sumkindafreak/new_showduino/firmware/s3-comms-controller/README.md

# Showduino ESP32-S3 Comms Controller

```text
Status: ACTIVE
Role: Showduino Communications Engine (dedicated ESP32-S3 Dev Module)
```

Dedicated USB-programmable ESP32-S3 communications processor.

This is **not** the 800×480 touchscreen Director (`firmware/director-esp32-8048s050/`).
It has no LVGL, no display, and no GT911. It is a separate ESP32-S3 Dev Module.

```text
Director ESP32-S3
        |
        | ESP-NOW
        v
ESP32-S3 Comms Controller   (this firmware)
        |
        | UART 115200 8N1
        v
ESP32-P4 Stage Engine
```

The P4 remains the authoritative Stage Engine. This board transports only. The P4 boots and runs locally if this S3 is missing.

## Constitution

> The Communications Engine transports.

It must **not**:

- Run the show timeline
- Own authoritative show state
- Make show-level decisions
- Invent show / production / emergency / node / output / E1.31 state
- Own SD, audio, pixels, or the Plug-in Bus
- Initialise Bluetooth

It **may** host the static browser WebUI from PROGMEM and proxy P4 API GETs.

## Sketch

```text
firmware/s3-comms-controller/ShowduinoS3CommsController/
```

Arduino board: **ESP32S3 Dev Module** (`esp32:esp32:esp32s3`).

USB CDC must remain enabled so this board stays directly programmable and debuggable over USB. The P4 UART uses UART1 on GPIO17/GPIO18, not UART0 and not native USB D+/D−.

### Compile (Arduino core 3.3.11)

```text
arduino-cli compile --fqbn "esp32:esp32:esp32s3:USBMode=hwcdc,CDCOnBoot=cdc,FlashSize=8M,PSRAM=opi,PartitionScheme=default_8MB" firmware/s3-comms-controller/ShowduinoS3CommsController
```

USB recovery uses this same FQBN. Hold BOOT, tap RESET, release BOOT, then `arduino-cli upload` to the CDC port. Always keep `PartitionScheme=default_8MB` so both OTA slots remain.

Do not reuse a firmware version string after that build has been physically installed or accepted. Uninstalled 0.5.1 prerelease assets may be replaced; installed SoftAP/browser-control hardening is **0.5.3**. See `docs/comms-ota.md` and `docs/browser-control.md`.

Arduino IDE: **PSRAM = OPI PSRAM** (DevKitC-1 N8R8 / 8 MB). Use **QSPI PSRAM** only on an N8R2 2 MB module. Disabled is wrong for this board.

## UART pins

Defined only in `BoardConfig.h`:

| S3 GPIO | Function |
|---|---|
| **18** | UART RX (from P4 TX) |
| **17** | UART TX (to P4 RX) |

Wiring:

```text
S3 GPIO17 TX  ->  P4 GPIO4 RX
S3 GPIO18 RX  <-  P4 GPIO5 TX
S3 GND        --  P4 GND
115200 8N1, newline-framed ASCII
```

## Phase 1 behaviour

- Receive Director ESP-NOW desk packets (magic `0x5348444F`, version 1, 96-byte command)
- Receive Audio Node ESP-NOW packets (116-byte node packet, type `AUDIO`) and forward `NODE:AUDIO:` to the P4
- Receive Lamp Node ESP-NOW packets (type `LAMP`) and forward `NODE:LAMP:` to the P4
- Forward `ROUTE:AUDIO:<seq>:<cmd>` from the P4 to the Audio Node (transport only)
- Forward `ROUTE:LAMP:<seq>:<cmd>` from the P4 to the Lamp Node (transport only)
- Validate and reject malformed packets
- Remember Director MAC and Audio Node MAC
- Newline-frame commands to the P4 UART
- Forward P4 UART lines back to the Director as desk packets
- Reply `DIAG:PONG` to P4 `DIAG:PING` (local; not forwarded to Director)
- USB maintenance: `HELP`, `STATUS`, `MAC`, `PING:P4`, `RGB:STATUS`, `RGB:TEST`
- Onboard WS2812 status RGB on **GPIO48** (DevKitC-1 v1.0). v1.1 boards use GPIO38 — change only `SHOWDUINO_COMMS_RGB_PIN`.
- `PING:P4` sends `DIAG:PING` and waits for `DIAG:PONG`
- SoftAP `Showduino` on channel 1 (AP+STA, WPA2) serving PROGMEM system console / commissioning WebUI
- Local `GET /api/comms` plus UART proxy of P4 `/api/*`
- `GET/POST /api/studio-timeline` envelope check, then UART proxy to the P4 (PIXEL / AUDIO:NODE RAM cues only)

USB does **not** inject arbitrary Stage Engine commands.

Copy the boot Wi-Fi MAC into Director `SHOWDUINO_COMMS_MAC_*` in `firmware/director-esp32-8048s050/ShowduinoDirector8048S050/BoardConfig.h`.

## USB power / brownout

Cheap ESP32-S3 Dev Modules often brownout on USB when UART or the Wi-Fi radio starts (`E BOD: Brownout detector was triggered`).

Firmware mitigations (USB sag, not a substitute for 5 V):

- Brownout *reset* is disabled so a short dip does not reboot-loop
- ESP-NOW TX power is reduced (`WIFI_POWER_8_5dBm`)
- `esp_wifi_start()` is not called twice after `WiFi.mode(WIFI_STA)`

First boot: **unplug the P4 UART wires**. If GPIO17 TX is clamped by an unpowered P4, USB current spikes and the chip resets. Power the P4, then connect:

```text
S3 GPIO17 TX  ->  P4 GPIO4 RX
S3 GPIO18 RX  <-  P4 GPIO5 TX
GND
```

Prefer a powered USB hub or the board 5 V pin, not a weak laptop port.

## WebUI (PROGMEM)

Canonical frontend source: `web/showduino-studio/`.

Regenerate flash-resident assets (do not hand-edit `WebAssets.generated.h`):

```text
python tools/embed-webui/embed_webui.py
```

or:

```text
powershell -File tools/embed-webui/embed-webui.ps1
```

Join Wi-Fi `Showduino` / `showduino` (documented bench WPA2 secret — change before a public venue). Open `http://192.168.4.1/`. SoftAP stays on ESP-NOW channel 1.

If the P4 UART is down the UI still loads and shows **P4 OFFLINE**. S3 does not invent show state.

Navigation: Home, Productions, Live, Outputs, Devices, Network, System, Settings. Page map: `web/showduino-studio/README.md`.

## Comms self-OTA (Phase 2A)

Comms 0.5.1 can install **its own** image into the inactive `default_8MB` OTA slot from a GitHub Release. See `docs/comms-ota.md`.

- Operator action is **Update Comms**, never Update System
- P4 must authorise maintenance; a running show or emergency blocks apply
- SHA-256 is required; HTTPS is required; signed manifests are not implemented
- During the Comms reboot, Director and ESP-NOW nodes briefly disconnect. P4 and GPIO25 stay up
- Other components still require USB

## FUTURE / RESERVED / NOT IMPLEMENTED

- Bluetooth LE
- OTA for P4, Director, or specialist nodes
- Ethernet / E1.31 (next P4 work; not this firmware)

Intended later topology:

```text
Browser
  ├─ Wi-Fi → Comms S3 WebUI (this board)
  └─ future Ethernet path as appropriate
Comms S3 --UART--> P4 Show Engine --Ethernet--> E1.31 / show network
```

## Related

| Path | Status |
|---|---|
| `firmware/p4-c6-espnow-bridge/` | UNUSED BY SHOWDUINO / RESERVED HARDWARE (onboard C6) |
| `firmware/c3-supermini-espnow-bridge/` | LEGACY / SUPERSEDED |
| `firmware/stage-engine-p4/` | ACTIVE Stage Engine |
| `firmware/director-esp32-8048s050/` | ACTIVE Director |
