sumkindafreak/new_showduino/firmware/director-s3/README.md

# Showduino Director S3 (UART scaffold)

```text
Status: LEGACY
Not part of the canonical runtime.
```

Earlier ESP32-S3 Director using UART toward the engine. Superseded by `firmware/director-esp32-8048s050/` (ESP‑NOW → Communications Engine).

See [`docs/repository-status.md`](../../docs/repository-status.md).
