sumkindafreak/new_showduino/firmware/touch-probe-8048/README.md

# Touch Probe 8048

```text
Status: DIAGNOSTIC
Hardware bring-up utility; not production firmware.
```

GT911 / XPT2046 touch diagnostics for ESP32-8048S043 / S050 panels.

See [`docs/repository-status.md`](../../docs/repository-status.md).
