sumkindafreak/new_showduino/docs/repository-status.md

# Showduino Repository Status

> **2 November 2026:** The active-stack inventory below describes the historical main-source classification, not all features on the owner-reported working local firmware. The local baseline is represented in unmerged [PR #51](https://github.com/sumkindafreak/new_showduino/pull/51); optional FastLED and other staged work are in draft PRs #52–#57, and a reported MOSFET reconnect output-drop has a paired P4/node candidate in draft #58. Do not treat those drafts as installed or physically accepted. [Current status](manual/SHOWDUINO_FINISH_LINE_STATUS_2026-10-30.md#2-november-2026--working-local-baseline-and-staged-github-integration).

Classification of firmware projects. Status labels guide development priority; legacy source is retained where useful.

Related:

- [Constitution](constitution.md)
- [Architecture](architecture.md)
- [Command protocol](command-protocol.md)
- [Final hardware architecture](final-hardware-architecture.md)
- [Audio and Pixel Engine](audio-pixel-engine.md)
- [Specialist Node Roadmap](node-roadmap.md)
- [Wireless Emergency + Pixel Node](emergency-node.md)
- [System updates](system-updates.md)

**Roadmap note:** the active P4 now owns authoritative runtime/safety, bounded persistent PIXEL/AUDIO/LAMP/MOSFET/TEST/LOG production loading, onboard system audio, and the local GPIO23 segmented Show Pixel Engine. Those cue types are implemented in the persistent parser; broader cue coverage and physical acceptance remain open. See [production storage](production-storage.md).

---

## 1. Canonical active stack

```text
Director ESP32-S3
    → ESP-NOW
Communications Engine ESP32-S3 (dedicated Dev Module)
    → UART
Show Engine ESP32-P4
```

The supported current stack also includes the first specialist **Audio Node**.

Current specialist-node rollout order:

```text
Audio Node → S3 Lamp Node → C3 Pixel Node → C3 Emergency Node → MOSFET Node
```

The Relay Node product role is **retired**. The S3 Lamp Node occupies that Director fabric slot. MOSFET remains a later digital/PWM specialist. DMX remains parked until explicitly reopened.

The S3 Communications Engine now hosts the bench/browser SoftAP WebUI and proxies API requests to the P4. It remains transport/UI hosting only; it does not own show decisions.

### Active firmware

| Folder | Role |
|---|---|
| `firmware/director-esp32-8048s050/` | Director — operator UI, requests, display |
| `firmware/s3-comms-controller/` | Communications Engine — dedicated ESP32-S3 ESP-NOW + UART + SoftAP/WebUI proxy |
| `firmware/stage-engine-p4/` | Show Engine on Stage Controller |
| `firmware/audio-node-esp32-a1s/` | First specialist Audio Node — implemented, hardware test required |
| `firmware/s3-lamp-node/` | S3 Lamp Node — ACTIVE carbide simulator (physical GPIOs confirmed) |
| `firmware/c3-pixel-node/` | C3 Pixel Node — remote pixel specialist |
| `firmware/c3-emergency-node/` | C3 Emergency + Pixel Node — wireless assert-only Emergency Button + full Pixel engine on GPIO2 (GPIO unconfirmed) |
| `firmware/c3-lamp-node/` | Historical C3 lamp — SUPERSEDED / reference |

---

## 2. Complete firmware classification table

| Folder | Status | Target hardware | Current purpose | Relationship / next action |
|---|---|---|---|---|
| `firmware/director-esp32-8048s050/` | **ACTIVE** | ESP32-S3 800×480 | Canonical Director LVGL + ESP-NOW client | Keep; Director requests/displays only |
| `firmware/s3-comms-controller/` | **ACTIVE** | ESP32-S3 Dev Module | Communications Engine, Audio Node routing, SoftAP/WebUI/API proxy | Keep transport-only; no show decisions |
| `firmware/stage-engine-p4/` | **ACTIVE** | ESP32-P4 Stage Controller | Authoritative Show Engine | Current platform focus includes P4 pixel bench commissioning |
| `firmware/audio-node-esp32-a1s/` | **ACTIVE / HARDWARE TEST REQUIRED** | Ai-Thinker ESP32-A1S / ES8388 | Attraction/programme audio node | Bench commission before claiming hardware-complete |
| `firmware/s3-lamp-node/` | **ACTIVE / PHYSICAL PINS CONFIRMED** | ESP32-S3 Dev Module family | Interactive carbide-lamp practical | Production Lamp Node firmware 0.4.0 |
| `firmware/c3-pixel-node/` | **ACTIVE / HARDWARE TEST REQUIRED** | ESP32-C3 | Remote pixel specialist | Same FX/emergency-white model as P4 GPIO23 |
| `firmware/c3-emergency-node/` | **ACTIVE / GPIO UNCONFIRMED** | ESP32-C3 Super Mini class | Wireless emergency station (ASSERT ONLY) + Pixel capability on GPIO2 | Do not mark GPIO verified until pushbutton commissioned. Sequential ESTOP-01 → reboot → healthy+linked → ESTOP-02 |
| `firmware/c3-lamp-node/` | **SUPERSEDED** | ESP32-C3 Super Mini OLED | Historical lamp FX firmware | Retained as reference; not the physical lamp |
| `firmware/mosfet-node-esp32/` | **SOFTWARE IMPLEMENTED** | ESP32_MOS_X4 / 303E32NMOS4 | Digital/PWM powered outputs OUT1–4 | Pin map defined; physical validation required |
| `firmware/relay-node-esp32/` | **LEGACY / RETIRED** | ESP32 + relay module | Historical relay-node prototype | Retain as reference only; not a production Node |
| `firmware/p4-c6-espnow-bridge/` | **UNUSED / RESERVED** | Onboard ESP32-C6 | Historical C6 bridge qualification | C6 hardware remains unused/reserved |
| `firmware/c3-supermini-espnow-bridge/` | **LEGACY / SUPERSEDED** | ESP32-C3 SuperMini | Previous SUE Communications Engine | Retain as reference; not current path |
| `firmware/director-s3/` | **LEGACY** | ESP32-S3 + TFT_eSPI | Earlier UART Director scaffold | Do not extend |
| `firmware/espnow-bridge/` | **LEGACY** | ESP32 family | Early ESP-NOW bridge scaffold | Retain packet ideas only |
| `firmware/touch-probe-8048/` | **DIAGNOSTIC** | 8048 touchscreen | Touch hardware bring-up | Keep as lab tool |
| `firmware/sue-esp32s3-node/` | **INCOMPLETE** | ESP32-S3 | Old multi-function node placeholder | Do not confuse with current specialist-node roadmap |
| `firmware/controller-cyd/` | **ARCHIVE CANDIDATE** | CYD | Legacy UI generation | Archive later |
| `firmware/executor-mega/` | **ARCHIVE CANDIDATE** | Arduino Mega | Legacy executor | Archive later |

---

## 3. Active project boundaries

### Director

**Owns:** operator UI, input handling, display state, ESP-NOW client transport, Director-local diagnostics.

**Must not own:** authoritative show state, production execution, node routing policy, physical completion assumptions.

### Communications Engine

**Owns:** ESP-NOW fabric, UART transport to P4, transport-address discovery, Audio Node packet forwarding, link health, static browser WebUI hosting and P4 API proxying.

**Must not own:** show decisions, timelines, cue state, physical FX execution, or false completion acknowledgements.

### Show Engine — ESP32-P4

**Owns:**

- authoritative show/emergency state;
- production loading and timeline execution;
- safety policy;
- node coordination;
- P4 system/safety audio;
- GPIO24 emergency/signage pixels;
- GPIO23 local segmented Show Pixel Engine;
- storage and local services as implemented.

The GPIO23 engine currently supports direct/bench `PIXEL:` commands and the shared 25-effect vocabulary. Persistent production format v1 accepts bounded PIXEL, AUDIO, LAMP, MOSFET, TEST and LOG cues. ESTOP-prefixed pixel persistence remains unsupported. See [production storage](production-storage.md).

### Emergency/signage pixels — GPIO24

Safety-owned, not a production lane.

```text
Each sign = 10 pixels
NORMAL: first pixel GREEN, remaining 9 OFF
EMERGENCY: every pixel WHITE
```

Up to 100 configured pixels gives up to ten sign bundles. All groups are prepared in one frame and transmitted together.

### Show pixels — GPIO23

One local theatrical line with independent segments and non-blocking effects. Emergency overrides every segment and forces the full line bright white. Clearing emergency leaves the show line blacked out; old effects do not auto-resume.

Shared FX vocabulary: `protocol/showduino_pixel_fx.h`.

### Audio Node

**Classification:** implemented / hardware test required.

Owns local ES8388 + microSD programme audio, playback lifecycle, fades/duck/inventory, P4 GRANT ownership, and a channel-1 SoftAP WebUI when standalone. It does not own P4 system/emergency audio or show decisions.

### S3 Lamp Node

**Classification:** ACTIVE firmware / physical GPIOs confirmed. Replaces the retired Relay Node product role on the Director fabric. Interactive carbide-lamp practical via `firmware/s3-lamp-node/` firmware **0.4.0**; same image is a standalone SoftAP prop (`Showduino-Lamp-<id>`) and a GRANT-managed Showduino node. P4 `LampNodeLink` / Comms `ROUTE:LAMP:`. Historical C3 firmware remains in `firmware/c3-lamp-node/`. See [`s3-lamp-node.md`](s3-lamp-node.md).

### C3 Pixel Node

**Classification:** implemented / hardware test required.

Remote equivalent of P4 GPIO23. Same firmware binary on every C3; commission `LED-01` / friendly name / line length after flash. P4 `PixelNodeLink` / Comms `ROUTE:PIXEL:<id>:`. Max 512 pixels on C3 (P4 local line remains 1–1024). See [`c3-pixel-node.md`](c3-pixel-node.md).

### MOSFET Node

**Classification:** SOFTWARE IMPLEMENTED / HARDWARE PIN MAP DEFINED / PHYSICAL OUTPUT VALIDATION REQUIRED.

ESP32_MOS_X4 four powered outputs with LEVEL / PULSE / FADE, Comms multi-peer `ROUTE:MOSFET:`, P4 `MosfetNodeLink`, Director Page 04 live tile, Studio Powered Output deploy. GPIO unverified until physical bench. Not a Relay revival.

---

## 4. Pixel electrical baseline

Each P4 pixel data line uses a **470 Ω series resistor** near the controller/logic buffer:

```text
GPIO23 / buffer → 470 Ω → Show Pixel DIN
GPIO24 / buffer → 470 Ω → Emergency/Signage DIN
```

Common ground is mandatory. A 74AHCT125/74HCT125-class 5 V logic buffer is recommended for final/long-cable installations. The resistor is signal conditioning, not level conversion. Use an appropriately sized external 5 V pixel supply and bulk capacitance near the line start.

---

## 5. Current implementation maturity

| Maturity | Current repository scope |
|---|---|
| **IMPLEMENTED** | Director → ESP-NOW → S3 Comms → UART → P4; P4 authoritative emergency/runtime; P4 SD TEST/LOG/PIXEL/AUDIO/LAMP/MOSFET production loading; P4 ES8311 system audio; Audio Node firmware; C3 Lamp Node firmware; C3 Pixel Node firmware; C3 Emergency Node firmware; MOSFET Node firmware; P4 GPIO24 grouped emergency signage; P4 GPIO23 segmented 25-FX local pixel engine; Comms SoftAP/WebUI/API proxy; Studio RAM timeline PIXEL/AUDIO/MOSFET:NODE ingest |
| **HARDWARE TEST REQUIRED** | Audio Node physical board; C3 Lamp Node physical board; C3 Pixel Node physical board; C3 Emergency Node physical board; MOSFET Node ESP32_MOS_X4 pin/LED validation; P4 GPIO23 Show Pixel line; final GPIO24 grouped signage wiring |
| **PARTIAL** | Persistent production assets/cue types beyond TEST/LOG; completion-driven state across every node type; SHDO v2 authoring vs P4 format-v1 store; public showduino.com deploy of the Studio V4 picker (source/overlay updated in this tree) |
| **PLANNED** | production AUDIO/PIXEL cue dispatch polish; native `.shdo` ingest on the P4 |
| **PARKED** | DMX work until explicitly reopened |
| **LEGACY** | Relay Node product concept, C3/SUE Comms, onboard-C6 Comms attempt, CYD/Mega generation, GoreFX dashboard tree |

---

## 6. Naming / repository debt

- `firmware/stage-engine-p4/` retains the older folder name even though the role is Show Engine / Stage Controller.
- Older docs may still describe the Relay Node as future/current; when encountered, update them to MOSFET Node or clearly mark historical context.
- Older docs may still say the S3 Comms Controller does not host SoftAP/WebUI; current Comms firmware does.
- Onboard C6 references must remain clearly marked unused/reserved.

No broad archive/move operation is required for the current pixel milestone.
