sumkindafreak/new_showduino/images/Connection lost system alert panel.png

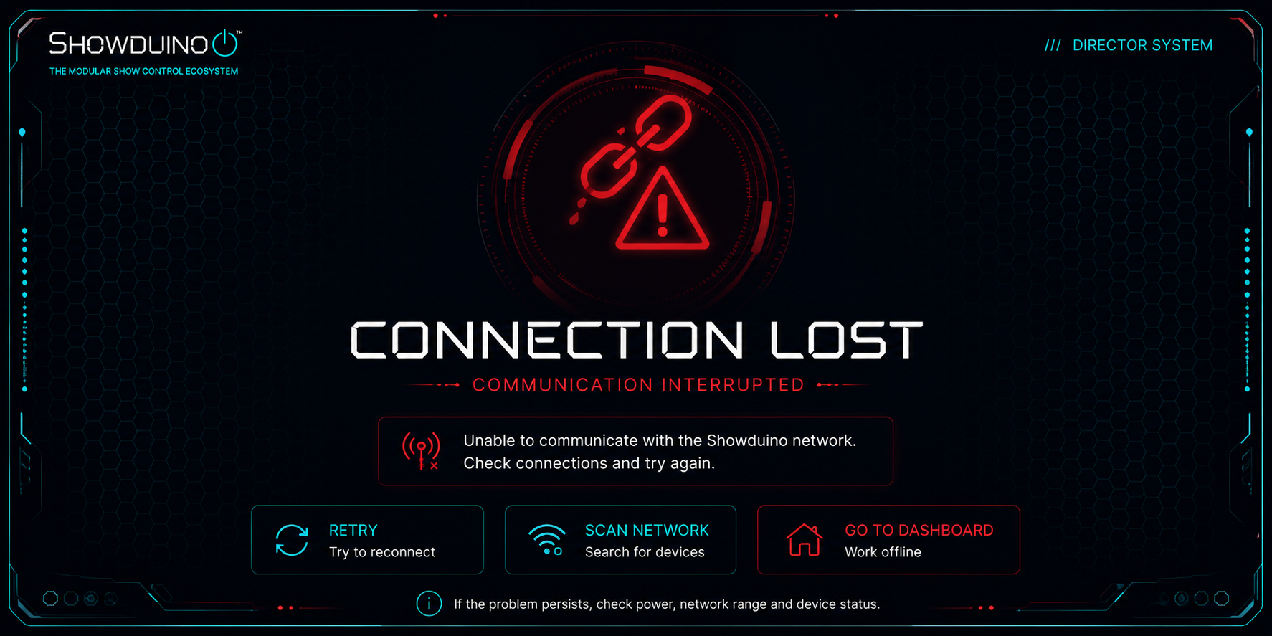
images/Connection lost system alert panel.png
