sumkindafreak/new_showduino/images/Emergency stop active_ system in safe mode.png

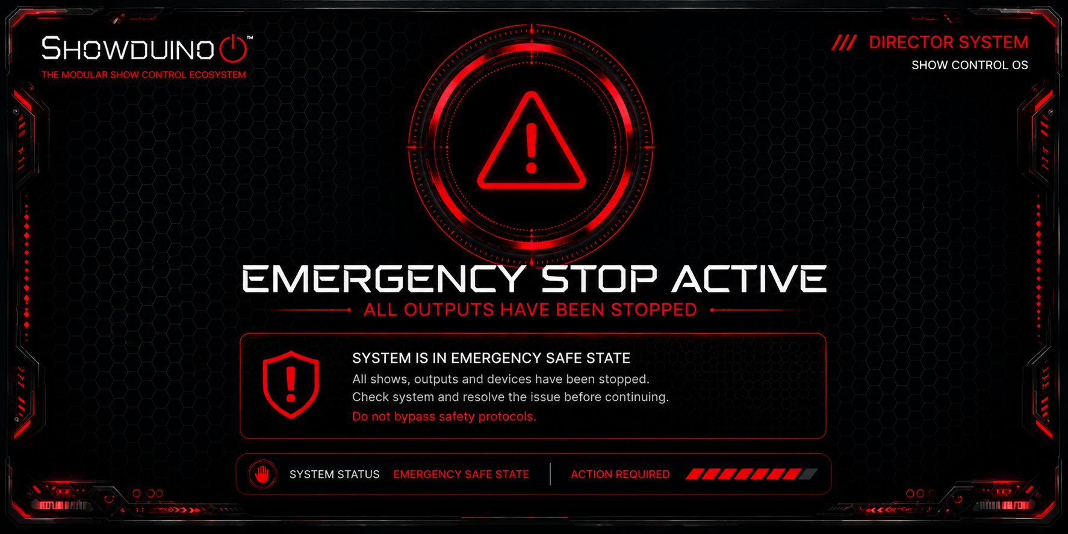
images/Emergency stop active_ system in safe mode.png
