sumkindafreak/new_showduino/images/Firmware update in progress dashboard.png

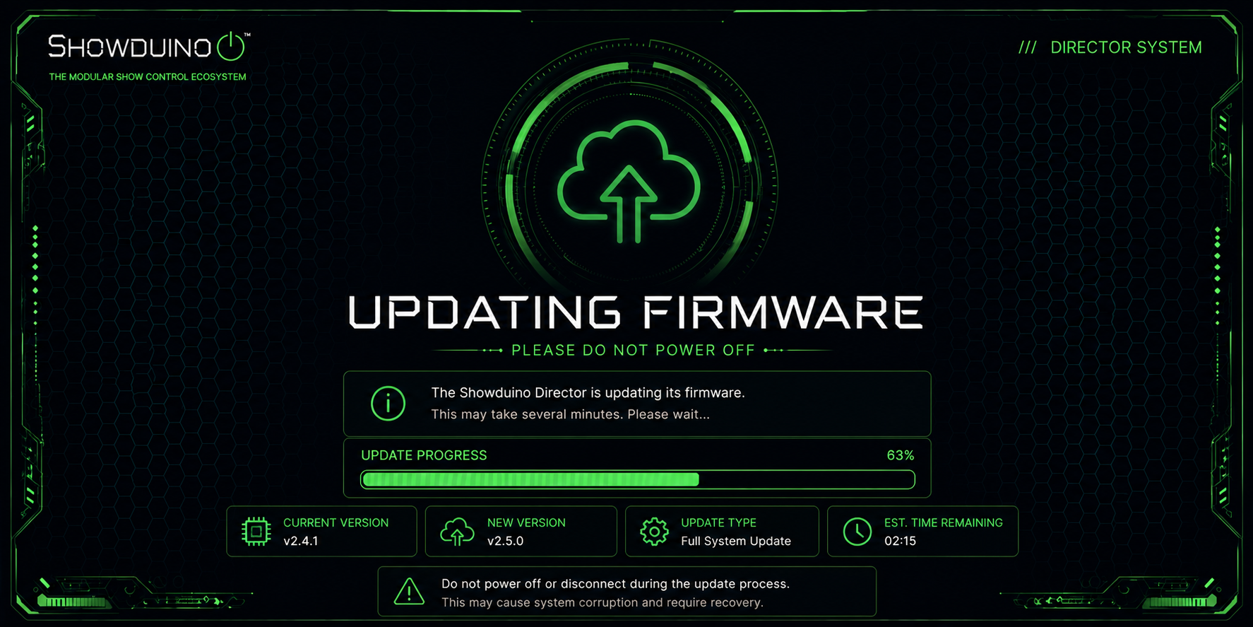
images/Firmware update in progress dashboard.png
