sumkindafreak/new_showduino/images/Futuristic control system dashboard UI.png

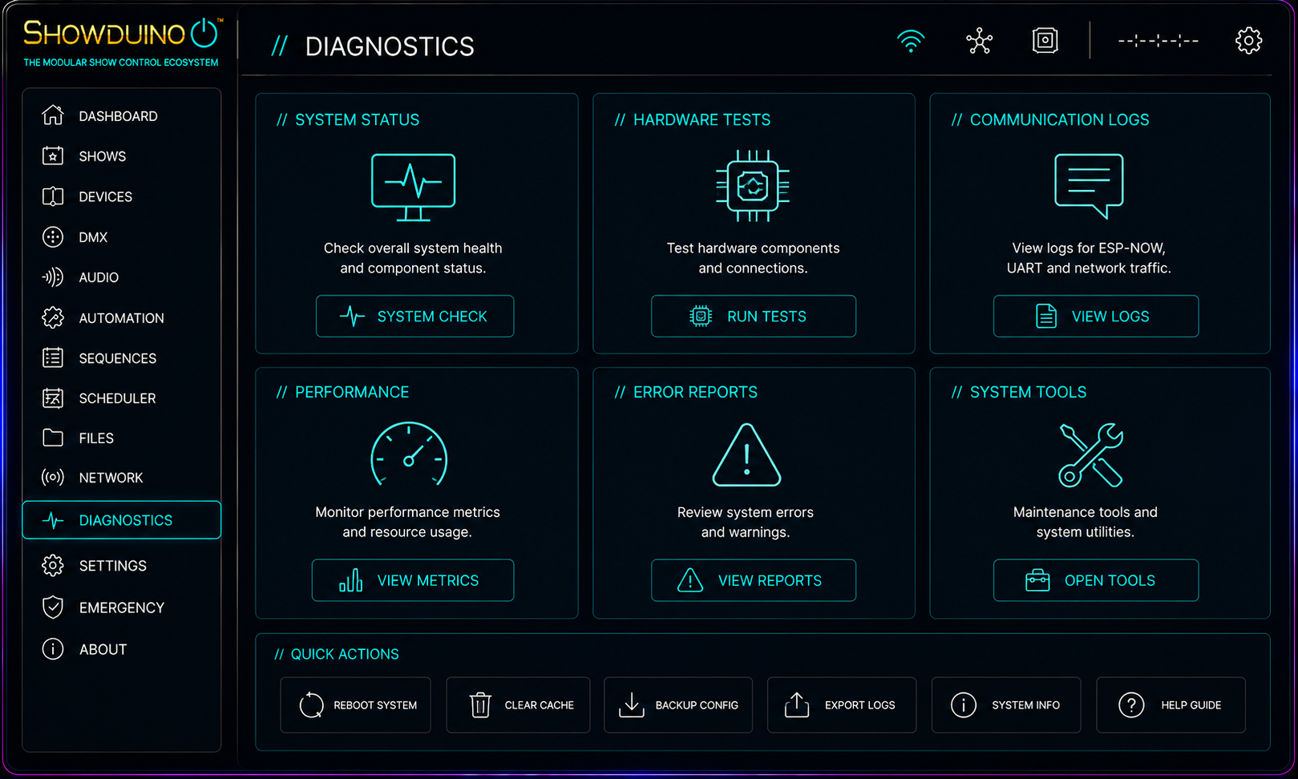
images/Futuristic control system dashboard UI.png
