sumkindafreak/new_showduino/images/Futuristic modular show control dashboard.png

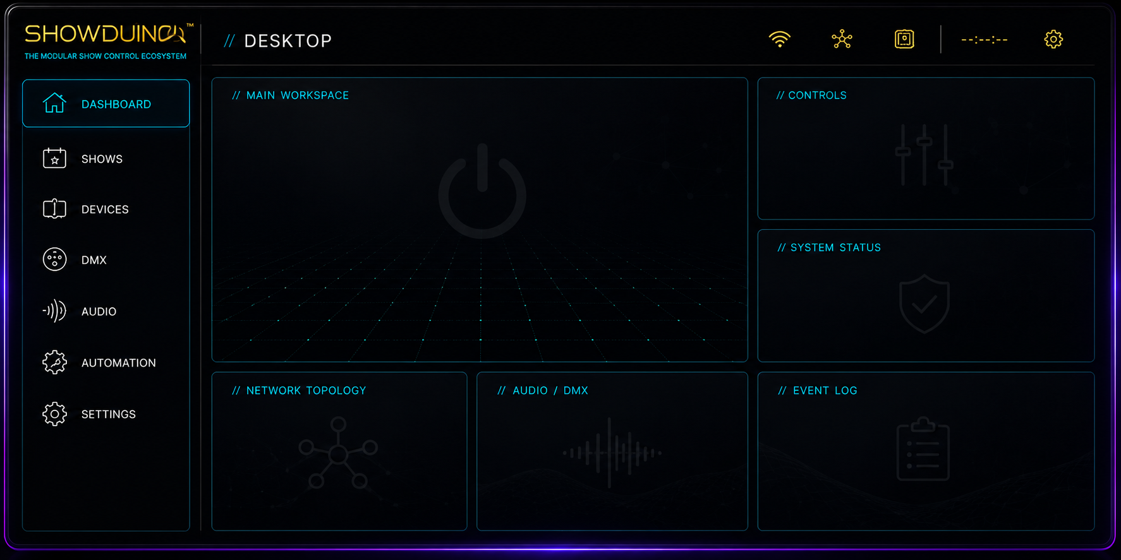
images/Futuristic modular show control dashboard.png
