sumkindafreak/new_showduino/images/Futuristic network control dashboard design.png

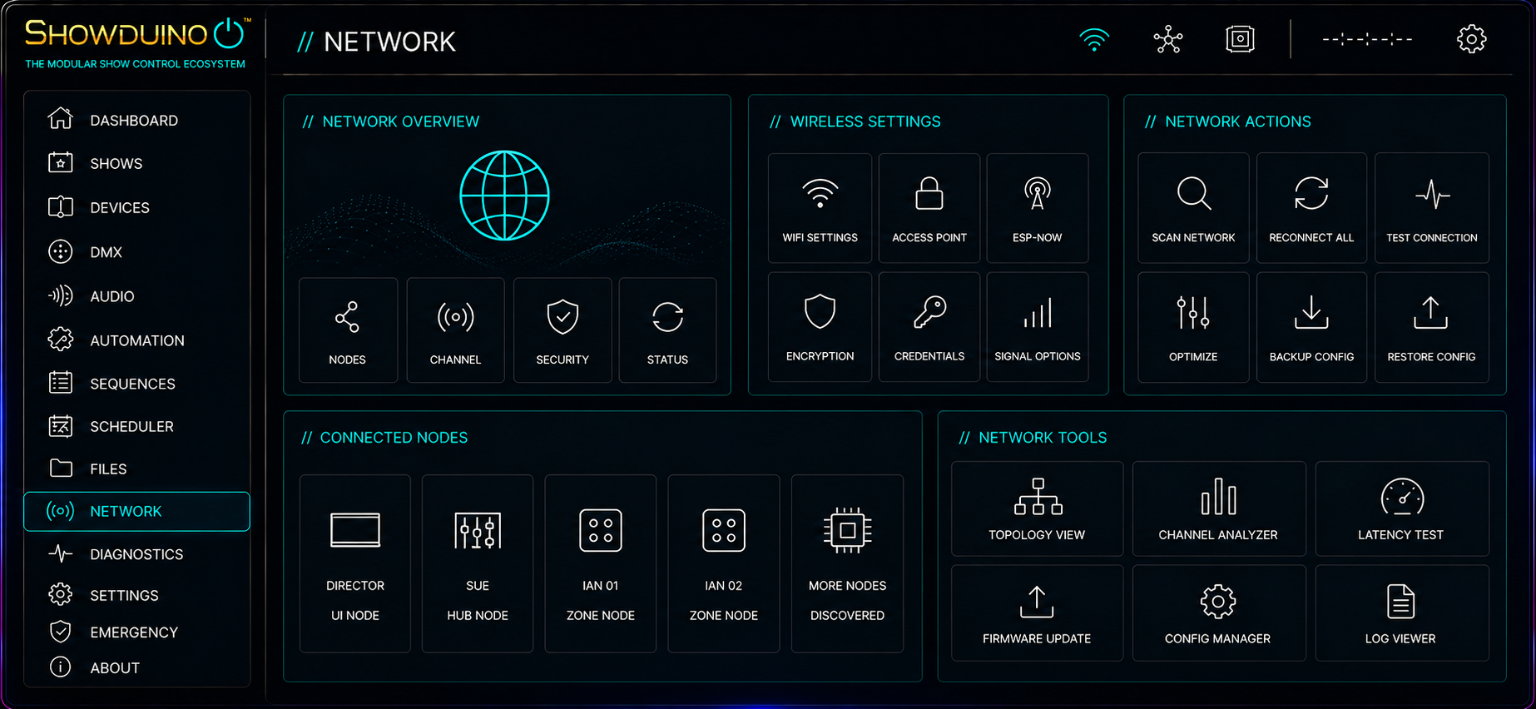
images/Futuristic network control dashboard design.png
