sumkindafreak/new_showduino/images/Futuristic show control dashboard screen.png

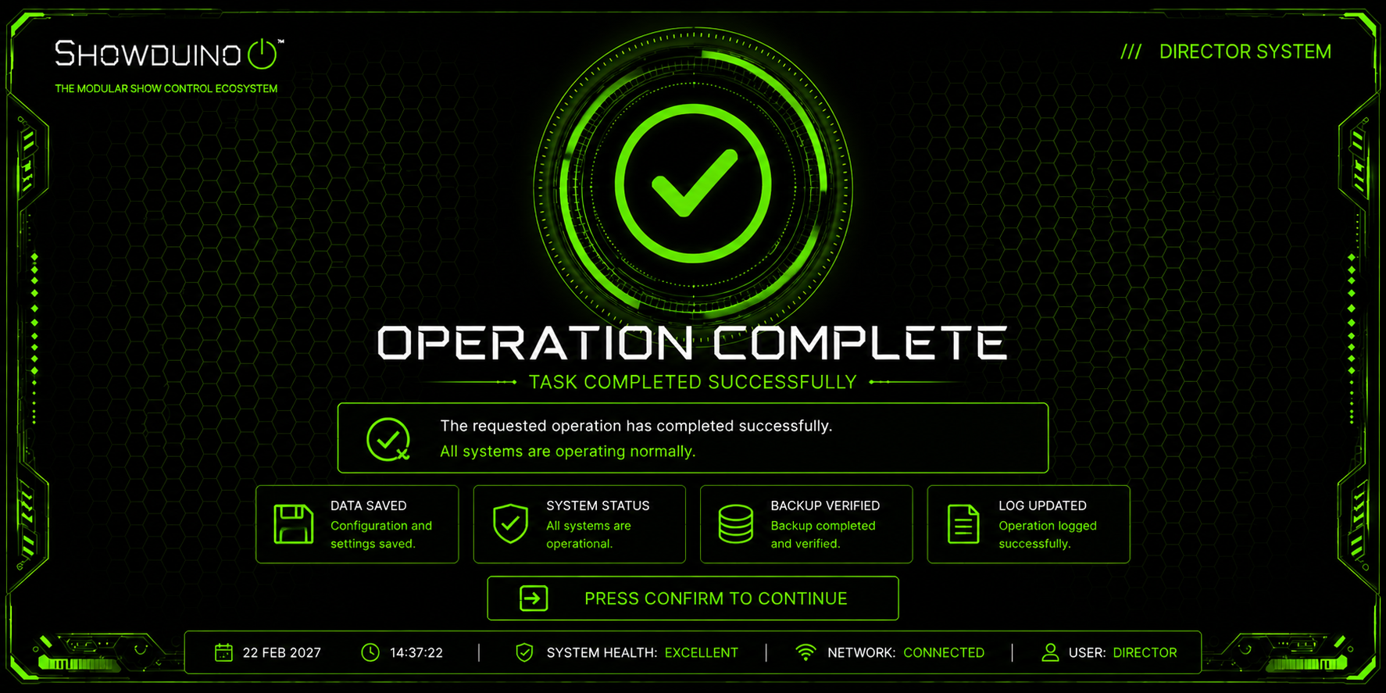
images/Futuristic show control dashboard screen.png
