sumkindafreak/new_showduino/images/Futuristic show control interface design.png

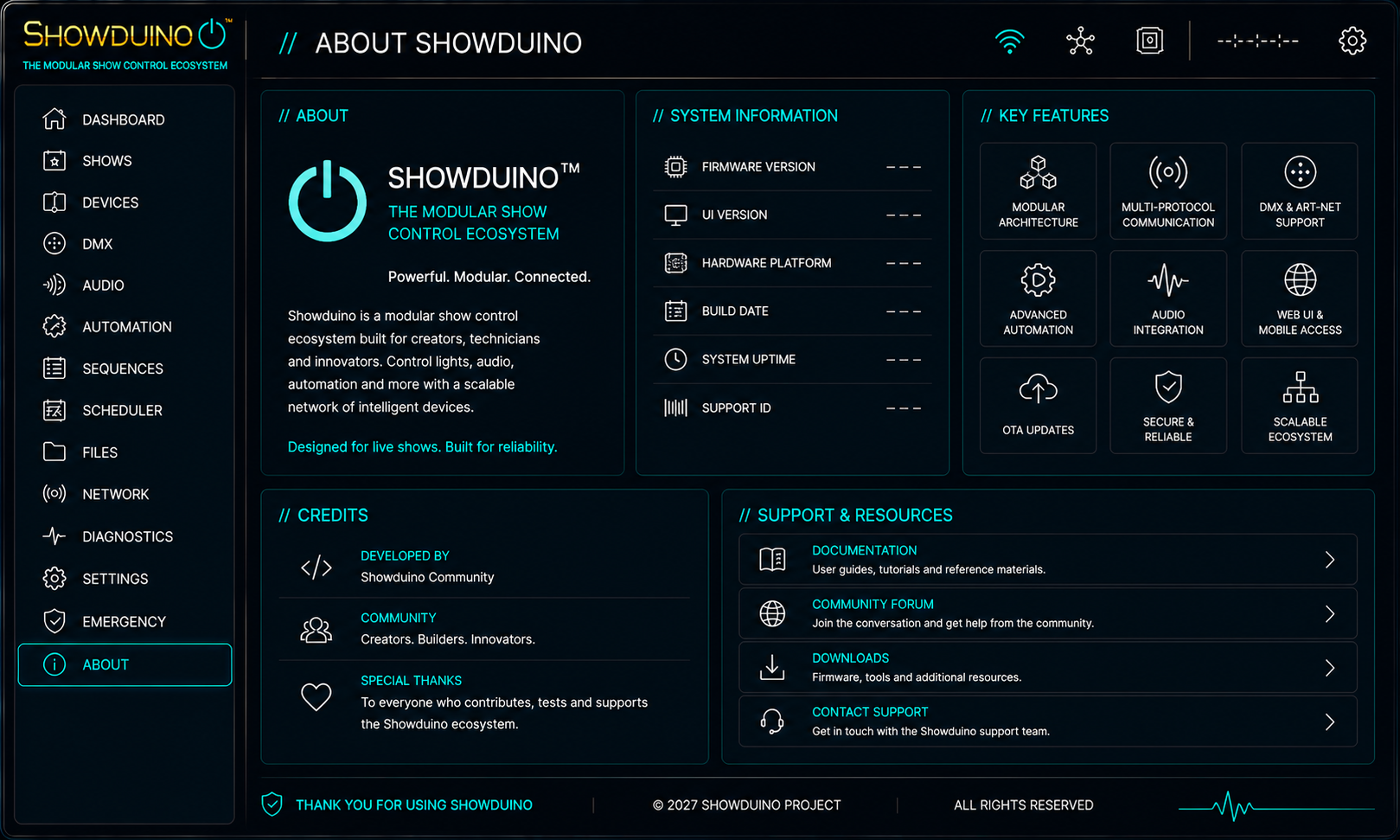
images/Futuristic show control interface design.png
