sumkindafreak/new_showduino/images/Futuristic system backup interface.png

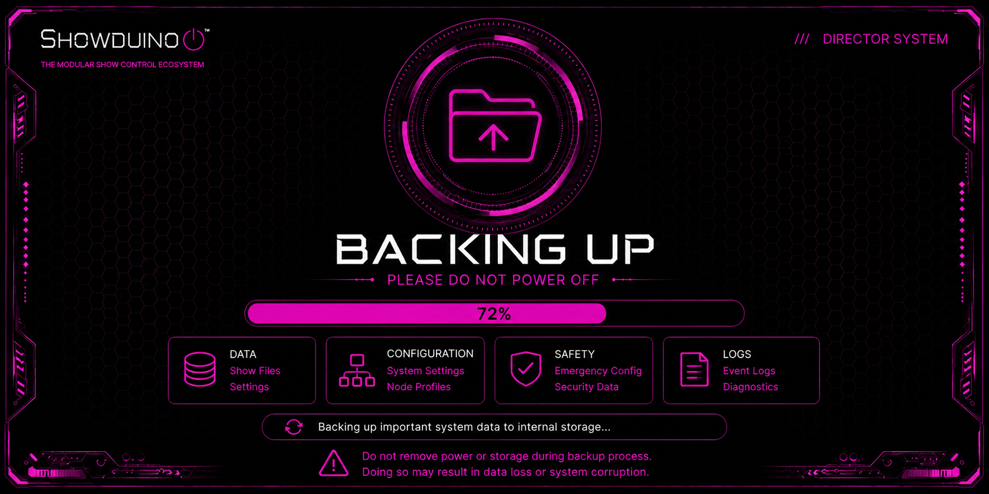
images/Futuristic system backup interface.png
