sumkindafreak/new_showduino/images/Futuristic system unlock interface.png

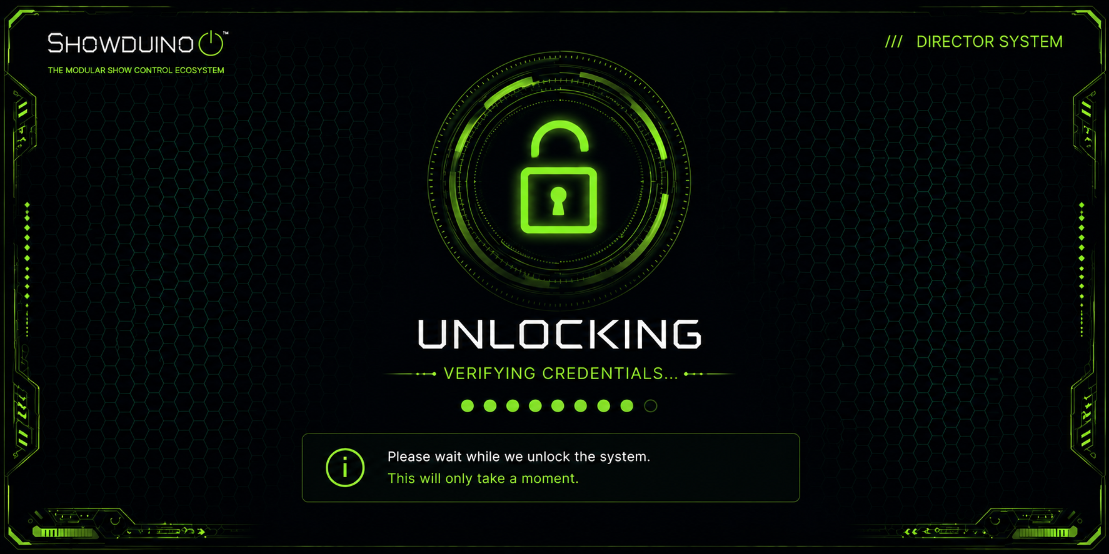
images/Futuristic system unlock interface.png
