sumkindafreak/new_showduino/images/Locked director system interface.png

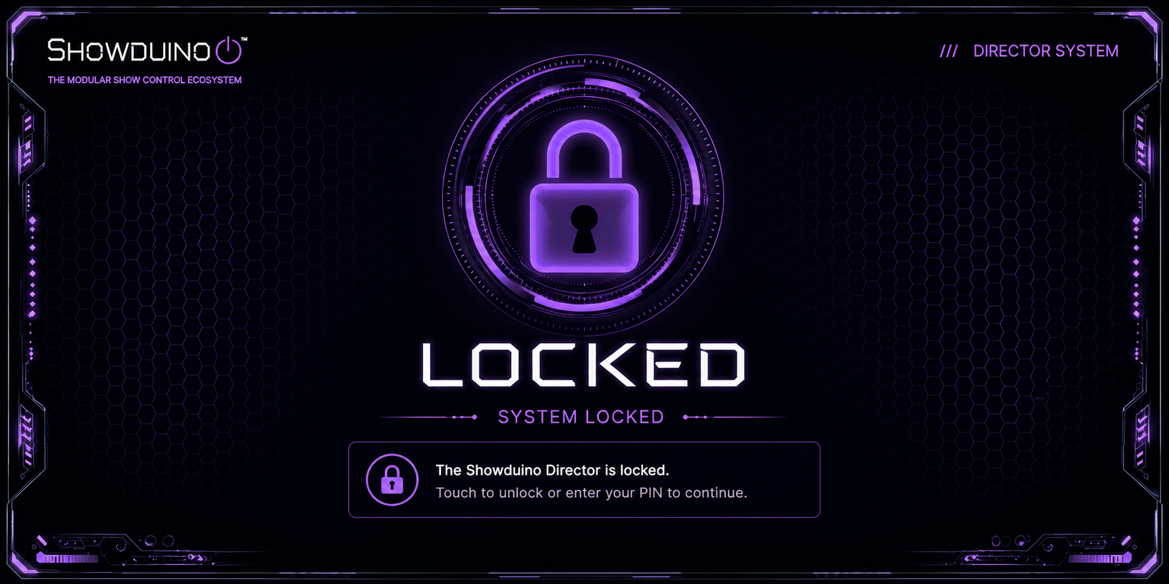
images/Locked director system interface.png
