sumkindafreak/new_showduino/images/No network – system status dashboard.png

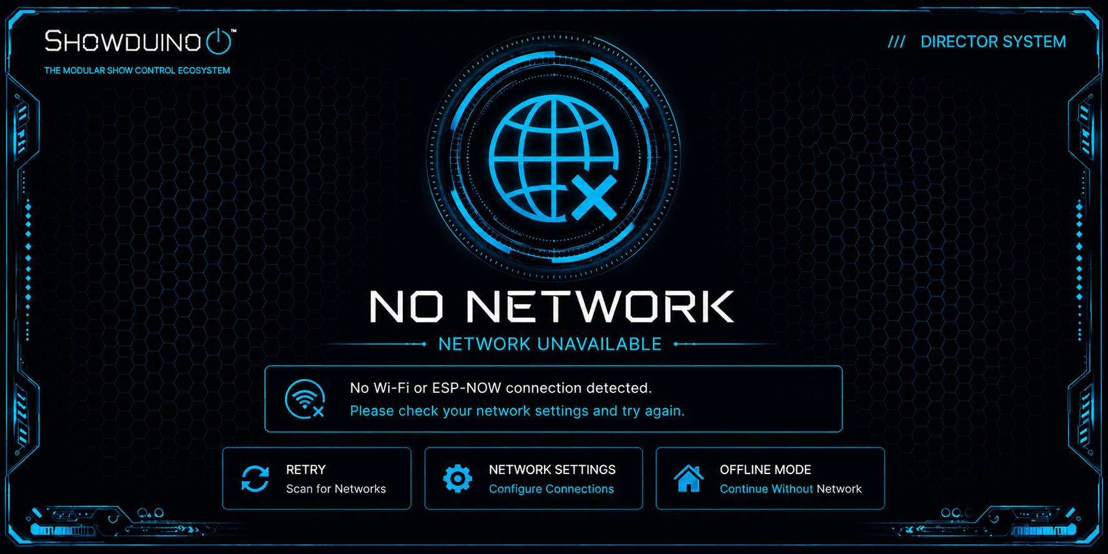
images/No network – system status dashboard.png
