sumkindafreak/new_showduino/images/No SD card detected on dashboard.png

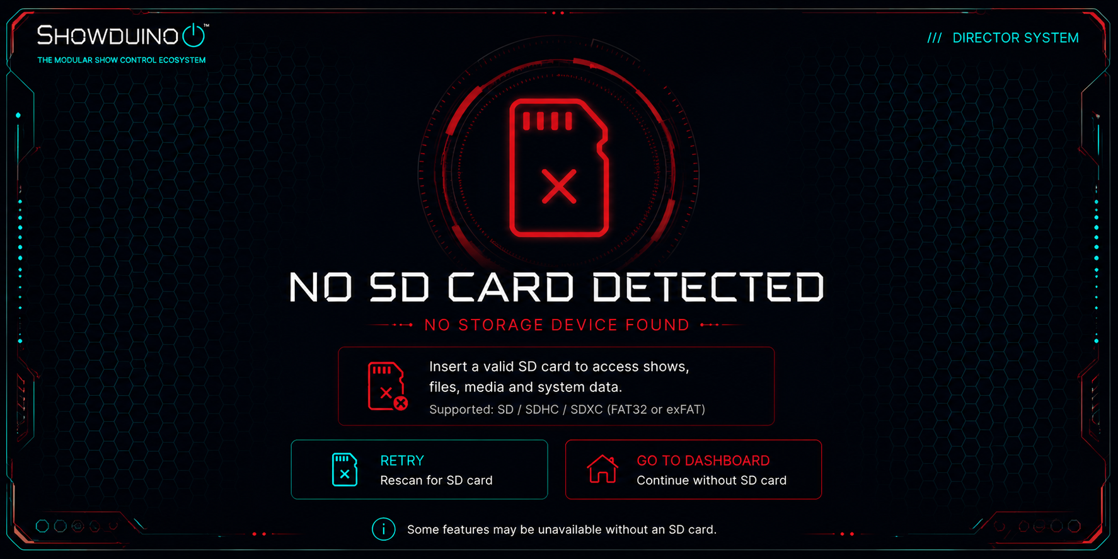
images/No SD card detected on dashboard.png
