sumkindafreak/new_showduino/images/Sci-fi device discovery interface.png

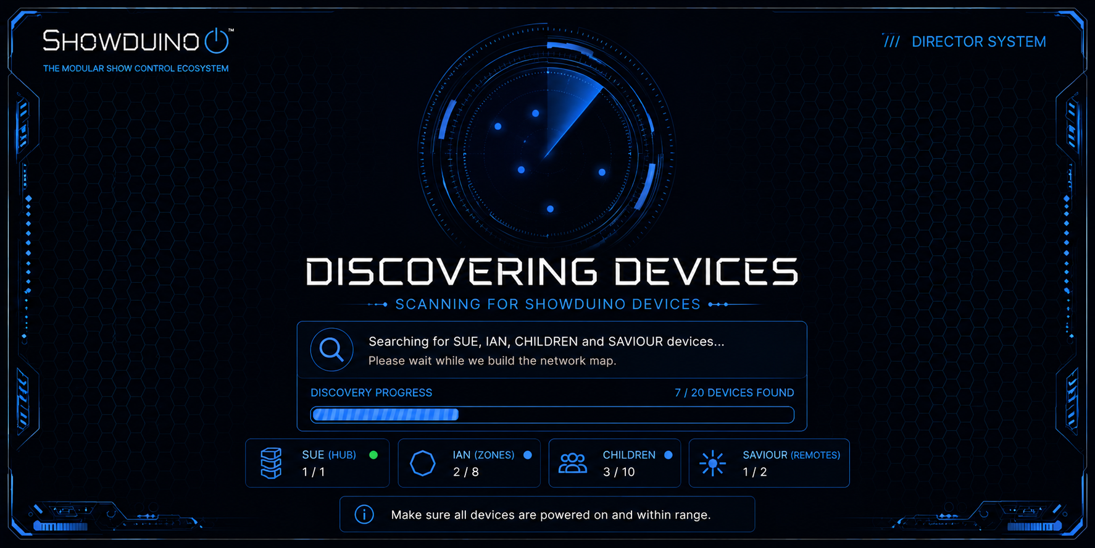
images/Sci-fi device discovery interface.png
