sumkindafreak/new_showduino/images/System reboot in progress HUD.png

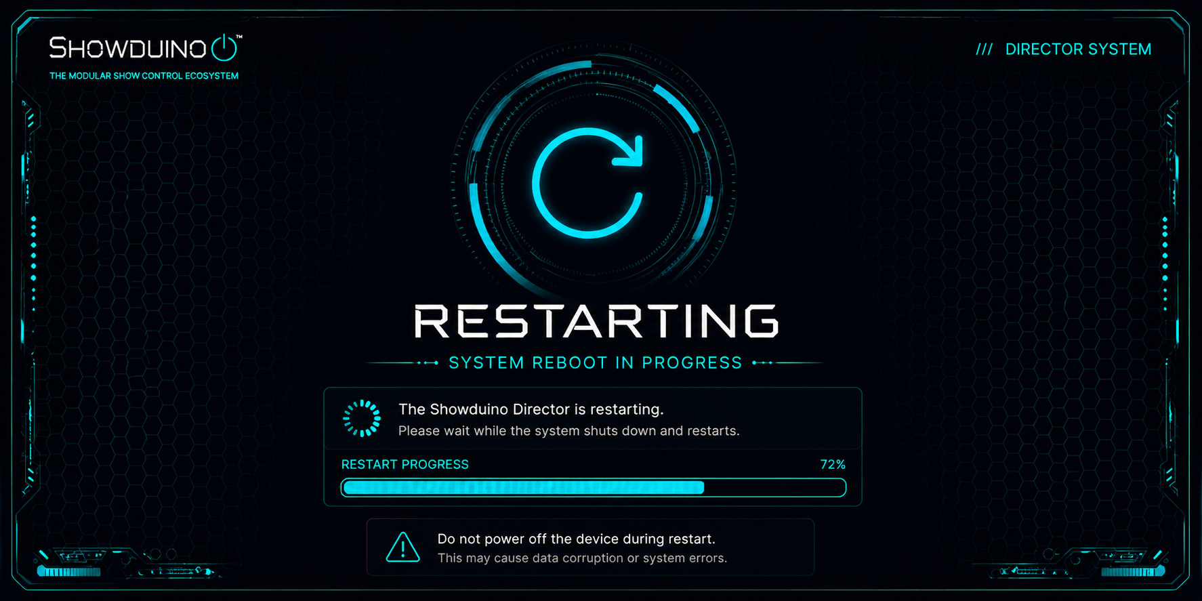
images/System reboot in progress HUD.png
