sumkindafreak/new_showduino/images/Tech recovery interface with neon accents.png

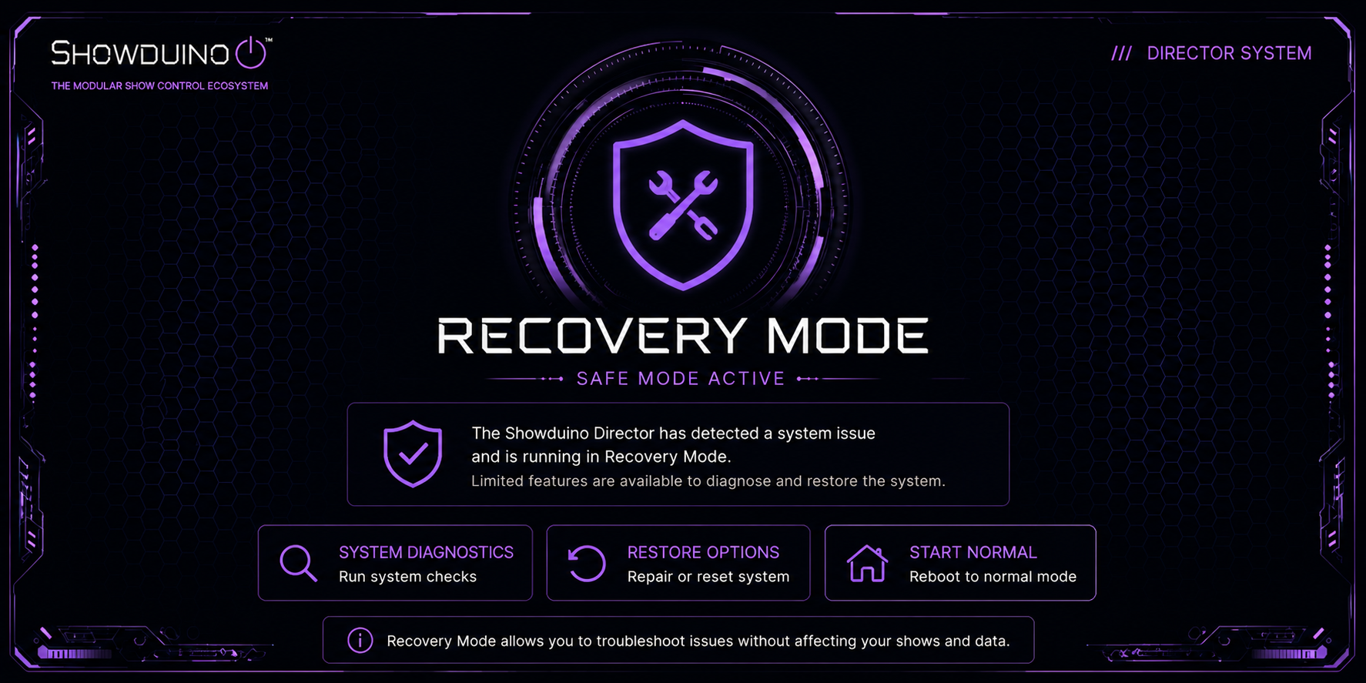
images/Tech recovery interface with neon accents.png
