sumkindafreak/new_showduino/showduino_ver_me/Screenshot 2026-09-04 194759.png

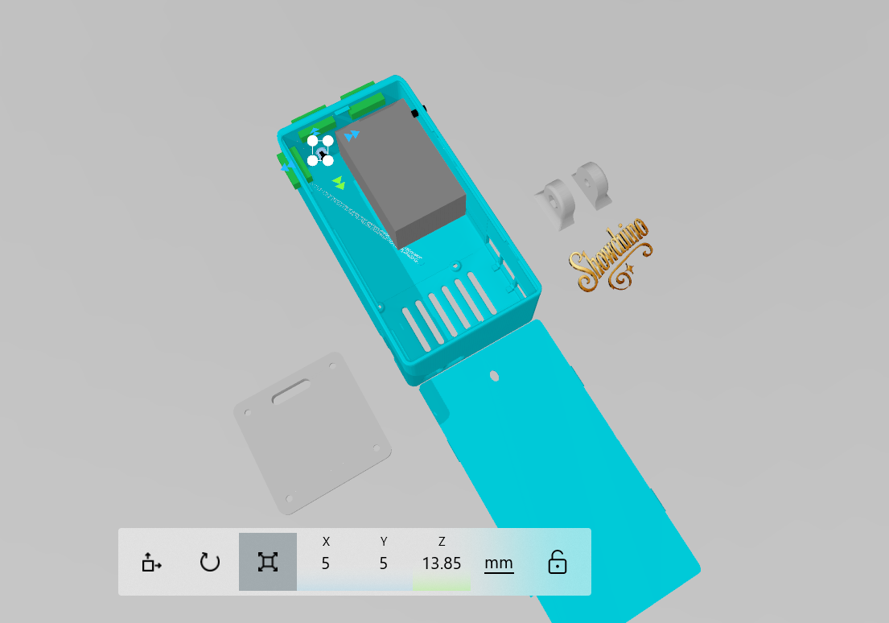
showduino_ver_me/Screenshot 2026-09-04 194759.png
