sumkindafreak/new_showduino/docs/manual/SHOWDUINO_FINISH_LINE_AUDIT_2026-10-24.md

# Showduino finish-line audit — 24 October 2026

**Target:** one complete, physically observed, non-DMX show followed by a mid-show Emergency repeat. **Status: FIRST COMBINED AUDIO/VISUAL PLAYBACK ACHIEVED (29 OCT); FORMAL COMPLETE-SCENARIO + EMERGENCY ACCEPTANCE STILL OPEN.**

## 29 October 2026 follow-up — FIRST REAL AUDIO/VISUAL SHOW PLAYBACK

- **Owner-confirmed physical milestone:** On **29 October 2026**, Showduino actually played a show with **both audio and visual effects together** on real hardware for the first time. The owner reported some teething issues. This is stronger evidence than the earlier visual-only 22-second pixel test and **supersedes** prior statements that Showduino has not played a show. Do not relabel this achievement as a mere simulation or isolated pixel/audio test.
- **Acceptance boundary:** The owner has not yet supplied a signed, time-stamped end-to-end run record identifying production file, duration, all required nodes, exact installed firmware builds, COMPLETE state or Emergency interruption/recovery. Therefore **first playback = achieved**, but **repeatable complete-scenario acceptance = not yet recorded**, and the separate **full v1 release gate = open**. The older 22-second acceptance record remains `NOT RUN` for its specified all-node normal and Emergency sequence; it must not be treated as contradicting the new first-show milestone.
- **GitHub source check:** `main` at [`e57870c`](https://github.com/sumkindafreak/new_showduino/commit/e57870caaea2) is four commits ahead of the 28 October reviewed `fd0834ef`. All four commits are scheduled **S3 Studio WebUI bundle regenerations**, touching only `firmware/s3-comms-controller/ShowduinoS3CommsController/src/web/WebAssets.generated.h` and `tools/embed-webui/last-build.json`. The manifest still reports `buildHash=56677901c6a2`, **42 assets**, **214,954 embedded bytes**, and authoring Studio source `850dea084320a45fb89b584507eda1514662b8dd`. No active firmware source changed in that range. The exact code flashed during the first show is **not known from GitHub main**.
- **Previously observed issues remain unclosed until retested:** Director Core 1 `LoadProhibited` resets, legacy Stage/synchronisation warnings and microphone CALIBRATE/threshold acknowledgement were reported on 28 October. Today's show playback demonstrates an operating audio/visual path, but does not by itself prove those issues have been fixed. WAV stuttering/volume were reported resolved on the working bench setup; preserve that configuration and do not infer PR #37 is flashed.
- **Smallest non-DMX next steps:** (1) record/backup the working installed firmware versions and exact production/assets; (2) repeat the *same* successful show and capture LOAD, deliberate START, cue timing and COMPLETE with P4-confirmed state; (3) identify and fix only any reproducible blockers (especially Director resets if they recur); (4) repeat that same show with mid-playback Emergency and verify safe outputs, latch, deliberate clear and **no automatic resume**; (5) enter observed PASS/FAIL evidence into the bench record and only then freeze a known-good build. No new modules, UI features or DMX work are required for this finish line.
- **Documentation disposition:** This dated correction is proposed on documentation-only [PR #41](https://github.com/sumkindafreak/new_showduino/pull/41); it does **not** change `main`, firmware, the authored show or the 20 October User Manual code baseline.

## 28 October 2026 follow-up — real bench progress and new Director crash blocker

- Reviewed `main` at [`fd0834ef`](https://github.com/sumkindafreak/new_showduino/commit/fd0834efa621aa1c8bada6e91147b581bedf03e5), committed **28 October 2026 18:25:16 UTC**. GitHub comparison `ddfdb6fc..fd0834ef` contains **four commits** and changes only the generated Comms `WebAssets.generated.h` and `tools/embed-webui/last-build.json`. The embed manifest retains `buildHash=56677901c6a2`, **42 assets**, **214,954 embedded bytes**, and the same authoring Studio source SHA `850dea084320a45fb89b584507eda1514662b8dd`; `buildUtc` advanced to `2026-10-28T18:25:16Z`. No active firmware implementation changed in these four commits. Compared with the 20 October manual source baseline, `main` is now **36 commits ahead**.
- **New owner-reported physical evidence, not yet a signed acceptance record:** the existing 22-second *visual* test exercised P4 and Audio Node pixels/lighting, and an Emergency response was observed. Separately, **ESP32-A1S WAV stuttering and volume problems are now reported fixed in physical playback**. This **supersedes** the older "WAV still stutters" report for the currently installed bench configuration; do not infer that unmerged PR #37 is the proven fix or that a specific GitHub SHA is flashed. Full timed all-node show, system-test WAV assets on A1S/P4, Chamber production and comprehensive Emergency repeat remain unverified. See [release-gate issue #42](https://github.com/sumkindafreak/new_showduino/issues/42) for the owner's dated observations.
- **New blocking regression on 28 October (Director):** the owner flashed the Director and initially reported working asset selection, then observed repeated **ESP32-S3 Core 1 `LoadProhibited` panics/reboots** while navigating Home/Audio Node. The 17:02 Director serial log shows `EXCCAUSE=0x1c`, `RTC_SW_CPU_RST`, an Audio Node page crash, later Home page crashes, and the same ELF short hash `2272f8568`. Backtraces need symbolication against the **exact flashed ELF**; no root cause or patch is confirmed. Other log lines include `WARN: legacy Stage (STATUS:READY)`, `DEGRADED reason=SYNCHRONISING`, and `TX FAILED -> Stage: AUDIO:NODE:SOUND:THRESHOLD:30`. These are observed link/version/routing warnings, not a proven P4 firmware diagnosis.
- **Audio microphone controls are only partially evidenced:** the Audio Node serial showed `[SOUND] DISABLE`, `[SOUND] ENABLE` and `SOUND:TRIGGER:TRANSIENT,ID=5,L=50,P=60,F=0,TH=20`, so at least some commands reach it. **CALIBRATE produced no observed Audio Node serial response**, and threshold/telemetry acknowledgements are not verified. Director touch/layout, P4 routing and the Audio Node's playback-versus-input ownership still require focused bench testing; do not mark the microphone path accepted.
- **Acceptance remains OPEN:** the existing [22-second all-node result sheet](https://github.com/sumkindafreak/new_showduino/blob/integration/pr27-pr28-current-main/docs/manual/SHOWDUINO_BENCH_RESULT_RECORD.md) is still `NOT RUN` as a full LOAD → START → COMPLETE plus mid-show Emergency acceptance. The visual-only bench demonstration is valuable partial progress, not the complete signed show. Preserve that working hardware setup before further flashing.
- **Separate release target:** the owner has set **31 October 2026** as the full active-v1 release target in [issue #42](https://github.com/sumkindafreak/new_showduino/issues/42), requiring every active node and safety behaviour physically verified. This broader release gate does **not** expand the scope of the present single-scenario finish-line test. A calendar target is not an acceptance result.
- **Minimum next actions for the existing scenario:** (1) record actual flashed SHAs and save the currently working pixel/audio configuration; (2) decode the Director crash backtrace with its exact ELF and stabilise Home/Audio Node navigation plus the mismatched Stage/link warnings; (3) test CALIBRATE/threshold acknowledgement with WAV stopped, without adding microphone features; (4) install/verify the existing test WAV assets and persist/LOAD/START the same 22-second all-node fixture; (5) run the same show with Emergency during audio and record all node outputs, Director-authorised clear and no automatic resume. Do not broaden the test or merge unverified safety changes.
- **Documentation disposition:** this is a documentation-only update on [PR #41](https://github.com/sumkindafreak/new_showduino/pull/41). The User Manual retains its 20 October firmware-source baseline, now with a dated bench-status note; no firmware, test fixture, hardware or `main` branch files were changed by this update.

## 27 October 2026 follow-up — another four bundle regenerations; finish line still unpassed

- Checked `main` at [`ddfdb6fc`](https://github.com/sumkindafreak/new_showduino/commit/ddfdb6fc78a84e7d1acaa6a7024ca100d8110d73). Direct GitHub comparison `36215ee4..ddfdb6fc` shows **four commits**, changing only `firmware/s3-comms-controller/ShowduinoS3CommsController/src/web/WebAssets.generated.h` and `tools/embed-webui/last-build.json`. No active firmware source, production fixture or operator manual changed in this range.
- The manifest's `buildUtc` is **2026-10-27T18:23:11Z**; `buildHash` remains **`56677901c6a2`**, with **42 assets**, **214,954 embedded bytes**, and authoring Studio pinned to **`850dea084320a45fb89b584507eda1514662b8dd`**. These unchanged metadata fields are consistent with regeneration, **not** proof that the compiled firmware was flashed or tested.
- From the 20 October firmware/manual baseline `f4c9aea`, `main` is now **32 commits ahead**. The comparison contains documentation and generated Comms WebUI assets/manifest, but no changes to active `.ino`, `.cpp` or `.h` firmware sources other than the generated WebAssets header. Retain the dated manual baseline; do not silently promote unmerged fixes.
- The fixed [22-second acceptance procedure](https://github.com/sumkindafreak/new_showduino/blob/integration/pr27-pr28-current-main/examples/productions/ALL_NODES_BENCH_TEST.md) and its [bench result record](https://github.com/sumkindafreak/new_showduino/blob/integration/pr27-pr28-current-main/docs/manual/SHOWDUINO_BENCH_RESULT_RECORD.md) remain on the unmerged integration branch; the result record still says **NOT RUN**. No new physically evidenced LOAD → START → COMPLETE or Emergency repeat was found in the reviewed repository records.
- Open PRs [#29](https://github.com/sumkindafreak/new_showduino/pull/29), [#35](https://github.com/sumkindafreak/new_showduino/pull/35), [#36](https://github.com/sumkindafreak/new_showduino/pull/36), [#37](https://github.com/sumkindafreak/new_showduino/pull/37) and [#40](https://github.com/sumkindafreak/new_showduino/pull/40) still contain proposed integration/parser/audio/pixel changes. The independent Emergency persistence proposal [#33](https://github.com/sumkindafreak/new_showduino/pull/33) is explicitly hardware-validation pending and **must not be merged merely to complete the 22-second show**.
- **Documentation disposition:** recorded this follow-up on documentation-only [PR #41](https://github.com/sumkindafreak/new_showduino/pull/41), updated its User Manual pointer and index, and made **no firmware or production changes**. No evidence warrants marking the acceptance gate passed or changing the five-step procedure below.

## 26 October 2026 follow-up — four more generated-bundle commits, no new physical pass

- Checked `main` at [`36215ee4`](https://github.com/sumkindafreak/new_showduino/commit/36215ee4a10c09b99ce69803e60f1cd2f402c187), committed **26 October 2026 at 18:40:39 UTC**. This is **four commits ahead** of the 25 October check (`43e0cebd`), and **eight commits ahead** of the 24 October audit (`87963bb`).
- GitHub comparison `43e0cebd..main` shows only `firmware/s3-comms-controller/ShowduinoS3CommsController/src/web/WebAssets.generated.h` and `tools/embed-webui/last-build.json` changed. All four commits say **“Regenerate S3 Studio WebUI bundle”** (26 October at 01:00, 06:53, 14:02 and 18:40 UTC). No active firmware source, acceptance fixture or operator manual changed in that range.
- Current manifest: `buildHash: 56677901c6a2`, **42 assets**, **861,510 raw bytes**, **214,954 embedded bytes**, website Studio pinned to `sumkindafreak/showduino.com@850dea084320a45fb89b584507eda1514662b8dd`; only the build timestamp differs from the 25 October manifest in the fields checked. This is consistent with regeneration rather than a functional update. The generated header bytes were **not** decoded or run on hardware here; do not claim a proven regression-free binary.
- The **20 October manual firmware baseline remains intentionally dated**; current `main` is now **28 commits ahead** of `f4c9aea`, without evidence of active firmware-source changes in those subsequent commits. Draft integration/fix PRs [#29](https://github.com/sumkindafreak/new_showduino/pull/29), [#35](https://github.com/sumkindafreak/new_showduino/pull/35), [#36](https://github.com/sumkindafreak/new_showduino/pull/36), [#37](https://github.com/sumkindafreak/new_showduino/pull/37) and [#40](https://github.com/sumkindafreak/new_showduino/pull/40) remain **open**, not part of `main`.
- The existing [bench result record](https://github.com/sumkindafreak/new_showduino/blob/integration/pr27-pr28-current-main/docs/manual/SHOWDUINO_BENCH_RESULT_RECORD.md) is still marked **NOT RUN**. No new dated physical LOAD → START → COMPLETE or mid-show Emergency acceptance evidence was found in the reviewed GitHub main/acceptance branch. The previously reported roughly 7-metre wireless Emergency-to-Audio observation is the most recent limited physical evidence available here; it is **not** proof of full Emergency acceptance.
- **Documentation disposition:** This addendum updates the audit and linked manual/index in [PR #41](https://github.com/sumkindafreak/new_showduino/pull/41), without changing the original manual's 20 October source baseline, firmware or acceptance criteria. The same five-step non-DMX procedure below remains the minimum route to a pass.

## 25 October 2026 follow-up — main advanced, acceptance unchanged

- Latest checked `main`: [`43e0cebd`](https://github.com/sumkindafreak/new_showduino/commit/43e0cebd3107a4d044cbddc53b70b6be6b0cf62c) (25 October, 18:29 UTC), **four commits ahead** of the 24 October audit baseline `87963bb`.
- Direct GitHub compare `87963bb..main` shows **only two changed paths**: `firmware/s3-comms-controller/ShowduinoS3CommsController/src/web/WebAssets.generated.h` and `tools/embed-webui/last-build.json`. The manifest retains `buildHash: 56677901c6a2`, **42 assets**, **214,954 embedded bytes**, and the same pinned website Studio source commit `850dea084320a45fb89b584507eda1514662b8dd`; its `buildUtc` changed from 24 to 25 October. This is consistent with timestamp-only regeneration, **not evidence of a new Studio feature or tested firmware**. The generated header changed, but its binary payload was not independently decoded during this audit.
- Compared with the 20 October manual baseline `f4c9aea`, `main` is now **24 commits ahead**; the additional four commits still do not modify active firmware source. The manual's dated firmware baseline remains valid, with this addendum identifying the later repository snapshot.
- Draft PRs [#29](https://github.com/sumkindafreak/new_showduino/pull/29), [#35](https://github.com/sumkindafreak/new_showduino/pull/35), [#36](https://github.com/sumkindafreak/new_showduino/pull/36), [#37](https://github.com/sumkindafreak/new_showduino/pull/37), and [#40](https://github.com/sumkindafreak/new_showduino/pull/40) remain **open/unmerged**. This documentation reconciliation remains [PR #41](https://github.com/sumkindafreak/new_showduino/pull/41), not yet merged to `main`.
- No new dated full-hardware 22-second **LOAD → START → COMPLETE** result or mid-show Emergency repeat was found in the reviewed repository evidence. The finish-line gate is still **NOT PASSED**. Keep the exact existing acceptance production and the five-step sequence below; do not widen scope.

## Source of truth and limits

- Checked `sumkindafreak/new_showduino` **`main` at `87963bbd017b4ca930f49db9928a3d39b32fa690`** on 24 October 2026.
- The maintained manual's reviewed firmware baseline remains `f4c9aeaabdcf939417f9891fb01d98e1e5d8aec2` (20 October). GitHub comparison shows **20 subsequent commits**, affecting documentation and the generated Comms Studio bundle/manifest; **no active firmware source changed** in that comparison. Do not silently promote draft firmware into `main`.
- `main` declares P4 `0.6.8`, Comms `0.5.4` and Audio Node `0.4.3` in their BoardConfig files. These are source versions, **not confirmed versions flashed onto the owner's hardware**.
- Most recent owner-reported physical observation: a wireless Emergency Node triggered audible Audio Node playback from roughly **7 metres** away. This proves only that particular observed path, **not** the full Emergency sequence, audio continuity or a complete show.
- **No dated physical LOAD → RUN → COMPLETE pass, and no complete Emergency repeat, has been recorded.** Host tests, firmware compilation, a Studio preview and a P4 persist/reload roundtrip are not substitutes.

## Confirmed in source or software tests — not a physical acceptance pass

- `main` contains Director, Comms S3, P4 timeline/runtime and persistent production code; the supported bounded cue types include PIXEL, AUDIO, LAMP, MOSFET, TEST and LOG.
- The 20 October documentation review records passing host production tests and website static checks. It did not flash or exercise physical hardware.
- Draft [PR #29](https://github.com/sumkindafreak/new_showduino/pull/29) has **separately** passed full Director/P4/Comms builds, host suites, and a persistent compile/reload of the fixed **22-second** `all-nodes-bench-test.shdo`. Its acceptance show and result sheet are on that **unmerged branch**, not on `main`: [fixture/procedure](https://github.com/sumkindafreak/new_showduino/blob/integration/pr27-pr28-current-main/examples/productions/ALL_NODES_BENCH_TEST.md), [result record](https://github.com/sumkindafreak/new_showduino/blob/integration/pr27-pr28-current-main/docs/manual/SHOWDUINO_BENCH_RESULT_RECORD.md).
- The smaller `main` fixture [`first-audio-test.shdo`](../../examples/productions/first-audio-test.shdo) is a **30-second** production with **22 seconds of requested WAV playback** (3 s PLAY, 25 s STOP). It is **not** the 22-second all-node acceptance show.

## Blocking observations and draft fixes

| Gate | Evidence / status | Minimum action |
| --- | --- | --- |
| Audio Node uninterrupted WAV | Owner reported stuttering; `main` is Audio 0.4.3. [PR #37](https://github.com/sumkindafreak/new_showduino/pull/37) buffers/retries I2S writes but is **uncompiled and untested on the A1S**. | Compile and A/B test existing WAV against the installed firmware; retain only a proven fix. |
| Actual website Studio export → SD persist | [PR #35](https://github.com/sumkindafreak/new_showduino/pull/35) fixes `action.value` token handling; [PR #36](https://github.com/sumkindafreak/new_showduino/pull/36) rejects truncated commands. Both are **unmerged**. #36 reports host tests only. | Verify a genuine exported file through the P4 persist/load path; apply the narrow parser fix if reproduced. |
| Matched 22-second multi-node show | [PR #29](https://github.com/sumkindafreak/new_showduino/pull/29) remains **draft/unmerged** and has diverged from `main`; its builds are not evidence of flashed hardware. | Reconcile without discarding current `main` or local edits; build/flash the matched required set; use its **existing** acceptance file. |
| Pixel and indicator wiring | On `main`, Audio GPIO22 is the configurable show-pixel output and GPIO5 is still KEY6; there is **no separate active GPIO5 status pixel**. [PR #40](https://github.com/sumkindafreak/new_showduino/pull/40) proposes GPIO5 **one indicator pixel**, GPIO22 **10-pixel minimum show line**, and disables KEY6; it is **not merged, compiled or physically verified**. P4/C3 default-ten changes are also draft. | Verify pin map and installed firmware first; test GPIO5 indicator and GPIO22 show line separately before accepting PR #40. |
| Emergency repeat and other outputs | Emergency white on P4/C3/Audio/Emergency pixels, Lamp emergency sound, MOSFET safe OFF, Director clear/Locate and no auto-resume have **no complete recorded hardware pass**. [PR #33](https://github.com/sumkindafreak/new_showduino/pull/33) latch persistence is also draft, not proven on power-loss hardware. | Repeat the same 22-second show with Emergency during the 10–14 s audio cue; log actual outputs and clear behaviour. |

The draft MP3 decoder and broader lighting-engine work are **not prerequisites** for this acceptance. No extra production features are required to record the existing test.

## Smallest finish-line sequence

1. **Preserve local work:** record local `git status`, installed firmware versions and any unpushed commits before syncing. Reconcile `main` and the minimum required draft fixes; do not merge untested Emergency persistence or other unrelated changes merely to reach a version number.
2. **Prepare the existing 22-second test:** use the exact [PR #29 acceptance procedure](https://github.com/sumkindafreak/new_showduino/blob/integration/pr27-pr28-current-main/examples/productions/ALL_NODES_BENCH_TEST.md), existing node IDs, saved 10-pixel counts, `system-test.wav`, and a **benign low-voltage** MOSFET OUT1 load. Verify Audio SD and output routing first.
3. **Prove one normal run:** persist, explicitly LOAD, deliberately START, observe each cue and reach **COMPLETE at 22 seconds**. Record actual Director/P4/Comms and node states, WAV continuity, Lamp Jewel and MOSFET OFF.
4. **Prove one Emergency run:** restart the **same** show; assert Emergency during Audio playback (10–14 s). Check P4 latch independent of Director, Audio stop, emergency audio as configured, pixel white, MOSFET OFF, authorised Director clear and **no automatic resume**. Check Director Locate separately where installed.
5. **Freeze only after both passes:** write dated logs, installed commit hashes, observations and failures into the [bench result record](https://github.com/sumkindafreak/new_showduino/blob/integration/pr27-pr28-current-main/docs/manual/SHOWDUINO_BENCH_RESULT_RECORD.md). Repair only a failing path, repeat the same tests, then archive the known-good firmware and production.

**Non-negotiable architecture:** **One Director. One coordinated show. Multiple replaceable nodes.** The Director exclusively chooses/commands shows; the P4 executes and enforces authoritative runtime/Emergency state. Comms transports. Nodes act, and no specialist-node button independently changes scenes. **Emergency STOP must assert and be enforced independently of Director connectivity.** Clearing Emergency never restarts a show. Showduino's theatrical interlock is not a certified life-safety system.
