sumkindafreak/new_showduino/firmware/director-esp32-8048s050/ShowduinoSdTouchTest/README.md

# Showduino SD + Touch Test

```text
Status: DIAGNOSTIC
Hardware bring-up utility; not production firmware.
```

Standalone SD mount / GT911 / RGB panel check for the 8048 Director hardware. Not the production Director application.

Parent product firmware: `../ShowduinoDirector8048S050/` (**ACTIVE**).

See [`docs/repository-status.md`](../../../docs/repository-status.md).
