sumkindafreak/new_showduino/docs/physical-test-checklist.md

# Showduino V1 physical-test checklist

> **2 November 2026 later owner report (supersedes the earlier failure as the latest observation, not as a signed pass):** Emergency clearance is reportedly fixed in the flashed local firmware, and the 22-second full-node show runs. Preserve that baseline; repeat assert → safe outputs → deliberate Director-confirmed clear → no automatic restart with isolated effect loads, and capture P4 authoritative state. Also reproduce the newly reported **MOSFET output drop during Director-only reconnect** and test any proposed paired P4/MOSFET fix from [draft #58](https://github.com/sumkindafreak/new_showduino/pull/58) for held outputs, node reboot, Emergency and no unintended restore. These physical checks remain **NOT SIGNED OFF**; [current evidence](manual/SHOWDUINO_FINISH_LINE_STATUS_2026-10-30.md#2-november-2026--working-local-baseline-and-staged-github-integration).

> **31 October 2026 — safety gate FAIL/BLOCKED:** Owner-reported Emergency clearance failures and intermittent unresponsive Director during recent show/Cue Library testing. Do not mark the physical Emergency/clear checklist PASS, run with live hazardous effect loads, or treat Director reset as an Emergency clear. Preserve exact flashed builds; capture P4, Director and Comms serial logs of assert, physical release, Director confirmation, request/ACK or rejection, P4 authoritative latch and post-clear no-resume state. Test with isolated low-power outputs only after investigation. This supersedes the older blanket `NOT RUN` wording as a statement about *all* physical tests: some audio/pixel/show playback has been observed, but this specific safety acceptance is now reported failing.

Product: **1.0.0-rc.1**. Do not tag `v1.0.0` until this list is signed off.

Pass/fail must come from hardware. Source inspection is not a pass.

Dated gate record: [physical-acceptance-1.0.0-rc.1-2026-09-11.md](release/physical-acceptance-1.0.0-rc.1-2026-09-11.md). That pass found **no attached Showduino hardware** on the validation host. Every physical item remains **BLOCKED** / **NOT RUN**.

## Bench setup

1. P4 with SD containing at least `system_test`.
2. Comms S3 UART: S3 GPIO17 TX → P4 GPIO4 RX; S3 GPIO18 RX ← P4 GPIO5 TX; 115200 8N1.
3. Director ESP32-S3.
4. Audio Node (if present).
5. Lamp Node (if present).
6. Pixel Node (if present) — ESP32-C3 Super Mini OLED, DATA GPIO2, OLED GPIO5/6.
7. Phone/laptop on SoftAP `Showduino` → `http://192.168.4.1/` and `/studio/`. Pixel Node AP is `Showduino-Pixel-XXXX` at `http://192.168.5.1/` (commissioning only).

## Radio / power-cycle (release-blocking)

- [ ] Power P4 → Comms → Director. Director links without forcing channel 1 after Comms STA join.
- [ ] **Audio Node power-on while Director is linked: Director stays linked (10×).**
- [ ] Audio Node power-cycle 10× with show idle: no Director drop, no ESP-NOW deinit loop.
- [ ] Lamp Node join does not drop Director.
- [ ] Comms STA connect to a venue AP on a non-1 channel: Director and Audio follow without Comms deleting peers.
- [ ] STA disconnect: after ~3 s radio returns to channel 1; Director relinks.
- [ ] SoftAP `Showduino` remains joinable during STA connect.

## Boot / atmosphere

- [ ] Director boot 10×: first complete boot frame, then backlight; no fade-in of boot art.
- [ ] Boot sound and atmospheric LEDs coordinate; emergency white still overrides.

## Emergency / safety (must not regress)

- [ ] Physical E-stop GPIO25 latches; outputs safe; auto-resume does not happen.
- [ ] Release does not clear Emergency.
- [ ] Director clear is request → confirmation; P4 rejects while GPIO25 is held.
- [ ] New physical Emergency assertion cancels a pending clear confirmation.
- [ ] GPIO23 emergency pixels all white; GPIO24 groups of 10; Lamp emergency white; Pixel Node entire configured line bright white.
- [ ] SHDO persist commit during emergency aborts; running show stops.

## Main button Locate + Director acknowledgement (hardware still required)

Do not tick these unless they were physically run.

- [ ] Quick press immediately enters Emergency
- [ ] Release does not clear Emergency
- [ ] 7-second hold does NOT Locate
- [ ] 8-second hold DOES Locate
- [ ] Locate command fires once only
- [ ] Locate works from second hold while already Emergency-latched
- [ ] Director wakes from auto-off
- [ ] Director backlight stays on during Locate
- [ ] Ambient LEDs flash continuously
- [ ] Locate continues beyond 60 seconds
- [ ] LOCATE ACTIVE UI is visible
- [ ] First touch stops Locate
- [ ] First touch is consumed
- [ ] Emergency remains latched after Locate acknowledgement
- [ ] Clear rejected while button pressed
- [ ] Director clear requires deliberate confirmation
- [ ] New Emergency assertion cancels old clear authorisation
- [ ] Clear leaves show stopped/safe
- [ ] Show requires deliberate restart

## Director touchscreen calibration (hardware still required)

Do not tick these unless they were physically run.

- [ ] Factory fallback still operates with NVS calibration absent
- [ ] Settings → Touchscreen Calibration opens correctly
- [ ] Five targets require separate press/release cycles
- [ ] Holding one target cannot skip to the next
- [ ] Calibration completes
- [ ] Bad/failed calibration is not saved
- [ ] Valid calibration becomes active without reboot
- [ ] Reboot preserves calibration
- [ ] Full power removal preserves calibration
- [ ] Top-left touch accurate
- [ ] Top-right touch accurate
- [ ] Bottom-left touch accurate
- [ ] Bottom-right touch accurate
- [ ] Centre touch accurate
- [ ] Edge controls remain usable
- [ ] Calibration screen prevents underlying UI clicks
- [ ] Auto-off is suspended during calibration
- [ ] Normal auto-off resumes afterward
- [ ] Emergency during calibration aborts calibration safely
- [ ] No partial calibration saved after Emergency
- [ ] Locate behaviour still works correctly
- [ ] Reset calibration restores factory mapping
- [ ] Reset does not delete unrelated Director NVS
- [ ] TOUCH:STATUS reports correct mode
- [ ] TOUCH:RESET provides recovery

## Pixel Node (NEEDS HARDWARE TEST)

- [ ] Flash identical C3 firmware. Boot dark / `NOT INITIALISED`. OLED visible crop/orientation correct.
- [ ] Commission Node ID + friendly name. Save Count does not light. Initialise Line matches configured length.
- [ ] Segments persist across reboot. Independent simultaneous FX. Same vocabulary as P4 GPIO23.
- [ ] Locate is time-limited and loses to emergency. Webpage cannot clear emergency.
- [ ] P4 / Director / Studio see the node. Disconnect: timeline continues. Reconnect: rediscovery.
- [ ] Two nodes (`LED-01`, `LED-02`) independent. Pixel join does not drop Director/Audio/Lamp (10× power-cycle).

## MOSFET Node (ESP32_MOS_X4 / 303E32NMOS4)

Software pin map is defined; physical validation is required before production use.

1. [ ] Disconnect real attraction loads. Flash over UART (IO0 download). Benign low-voltage supply only.
2. [ ] Boot reports MOSFET-01; all outputs OFF at idle. Serial shows GPIO MAP SOFTWARE DEFINED / HARDWARE UNVERIFIED.
3. [ ] Measure cold boot / reset / IO0 download for output glitches on all four channels.
4. [ ] Connect one benign resistive/LED test load (not motor/solenoid until topology checked).
5. [ ] OUT1→GPIO16, OUT2→GPIO17, OUT3→GPIO26, OUT4→GPIO27; LED GPIO23 polarity.
6. [ ] Test 25/50/75/100%, pulse, fade in/out.
7. [ ] Active output + reset → OFF. Active + authority loss → OFF. Restore link → stays OFF.
8. [ ] Emergency STOP → immediate OFF. Clear → remains OFF. Fresh command works.
9. [ ] Only after pass may `SHOWDUINO_MOSFET_GPIO_VERIFIED` become 1.

### Identifier NeoPixels (GPIO25) — local indicators + dim status

Not a theatrical Pixel Line. Four WS2812 on one data pin. Green = energised MOSFET only.

1. [ ] MOSFET outputs disconnected from real attraction loads.
2. [ ] Connect four NeoPixels in series.
3. [ ] GPIO25 → 330 Ω → DIN Pixel 0 → Pixel 1 → Pixel 2 → Pixel 3.
4. [ ] Common ground. Safe 5 V pixel supply (do not overload onboard 5 V).
5. [ ] Boot — violet chase 1→2→3→4 once, then dim status (not bright Christmas tree).
6. [ ] Idle healthy owned: P0 purple, P1 cyan, P2 turquoise, P3 violet @ ~8–12 brightness. No green.
7. [ ] OUT1 100% → Pixel 0 green; other OFF pixels keep status colours.
8. [ ] OUT2 100% → Pixel 1 green only (wins over cyan/amber role).
9. [ ] OUT3 / OUT4 same for pixels 2 / 3.
10. [ ] Test 25/50/75% green brightness tracking.
11. [ ] PULSE / FADE follow real output.
12. [ ] ALL OFF → greens off; status colours may remain on OFF channels.
13. [ ] ESP-NOW searching (no ownership) → slow amber bounce; reconnect grant → turquoise sweep once.
14. [ ] WebUI client join → brief magenta double-pulse on free pixels.
15. [ ] IDENTIFY → 4-pixel white chase; MOSFET outputs unchanged.
16. [ ] Fault → magenta ↔ amber; Emergency → MOSFET outputs OFF and **all identifier pixels solid full-bright white**.
17. [ ] Authority loss → outputs OFF and identifiers OFF; reconnect does not restore stale state.
18. [ ] Only then mark `SHOWDUINO_MOSFET_IDENTIFIER_PIXEL_VERIFIED` = 1.

## Studio / persist

- [ ] `/studio/` RAM timeline PIXEL + AUDIO:NODE still works; START waits for P4.
- [ ] WebUI Productions persist of a minimal SHDO writes SD `manifest.json` + `timeline.json` and does **not** auto-load or auto-start.
- [ ] Director can PRODUCTION:LOAD the persisted id, then START.

## Network / updates

- [ ] WebUI Network shows AP / home Wi-Fi / internet / ESP-NOW channel separately from P4 Ethernet.
- [ ] Connect/disconnect/forget do not log passwords.
- [ ] Internet unplug does **not** show SHOWDUINO CONNECTION LOST on Director.
- [ ] Check for Updates returns `no_releases` or a newer tag without installing.

## Honesty

Any unchecked radio/Audio item is **NEEDS HARDWARE TEST**. Audio power-on vs Director remains a **BLOCKER** for tagging 1.0.0 until the 10× test passes.

Status/identifier acceptance vocabulary: [`status-colour-standard.md`](status-colour-standard.md).
