sumkindafreak/new_showduino/firmware/director-esp32-8048s050/ShowduinoDirector8048S050/ShowduinoDirector8048S050.ino

/*
  Showduino Director 5" - ESP32-S3 RGB (JC8048W550C / 8048S050)

  Display / touch bring-up follows BankOfDadLVGL landscape pattern:
  - RGB bounce buffer
  - TAMC_GT911 -> LVGL
  - DISPLAY_ROTATION 0 (landscape 800x480)

  Primary use:
  - Portable control surface
  - ESP-NOW -> Communications Engine (C3) -> Show Engine (P4)

  Required Arduino libraries:
  - lvgl 9.x
  - Arduino_GFX_Library
  - TAMC_GT911
  - Adafruit NeoPixel (ambient status LEDs on GPIO17)

  Arduino IDE:
  - Board: ESP32S3 Dev Module
  - USB CDC On Boot: Disabled   (required - USB-C serial is CH340 on UART0)
  - USB Mode: USB-OTG (TinyUSB)
  - Flash Size: 16MB | QIO 80MHz
  - PSRAM: OPI PSRAM
  - Partition: app3M_fat9M_16MB
  - Serial Monitor: 115200 on the same COM port that prints ESP-ROM
*/

#include <Arduino.h>
#include <Arduino_GFX_Library.h>
#include <SPI.h>
#include <SD.h>
#include <FS.h>
#include <Wire.h>
#include <lvgl.h>
#include <TAMC_GT911.h>
#include <esp_heap_caps.h>

#include "BoardConfig.h"
#include "lvgl_port.h"
#include "touch_lvgl.h"
#include "backlight.h"
#include "DirectorAmbientPixels.h"
#include "DirectorEmergencyClearDialog.h"
#include "ShowduinoUi.h"
#include "DirectorUnlockScreen.h"
#include "DirectorUiMotion.h"
#include "DirectorAmbientPixels.h"
#if SHOWDUINO_OS2_SHELL
#include "os2/ShowduinoOs.h"
#endif
#include "EspNowTransport.h"
#include "src/WebServerManager.h"
#include "src/StorageAPI.h"
#include "src/TimelineEngine.h"
#include "../../../protocol/showduino_state_wire.h"
#include "../../../protocol/showduino_legacy_strings.h"
#include "../../../protocol/showduino_log.h"
#include "../../../protocol/showduino_show_runtime.h"

// =========================================================
// RGB panel - BankOfDad bounce buffer, landscape rotation 0
// =========================================================
Arduino_ESP32RGBPanel *rgbpanel = new Arduino_ESP32RGBPanel(
  RGB_DE_PIN, RGB_VSYNC_PIN, RGB_HSYNC_PIN, RGB_PCLK_PIN,
  RGB_R0_PIN, RGB_R1_PIN, RGB_R2_PIN, RGB_R3_PIN, RGB_R4_PIN,
  RGB_G0_PIN, RGB_G1_PIN, RGB_G2_PIN, RGB_G3_PIN, RGB_G4_PIN, RGB_G5_PIN,
  RGB_B0_PIN, RGB_B1_PIN, RGB_B2_PIN, RGB_B3_PIN, RGB_B4_PIN,
  RGB_HSYNC_POLARITY, RGB_HSYNC_FRONT, RGB_HSYNC_PULSE, RGB_HSYNC_BACK,
  RGB_VSYNC_POLARITY, RGB_VSYNC_FRONT, RGB_VSYNC_PULSE, RGB_VSYNC_BACK,
  RGB_PCLK_ACTIVE_NEG, RGB_PREFER_SPEED, false,
  0, 0, RGB_BOUNCE_BUFFER
);

Arduino_RGB_Display *panel = new Arduino_RGB_Display(
  SCREEN_WIDTH, SCREEN_HEIGHT, rgbpanel, DISPLAY_ROTATION, true
);

TAMC_GT911 touchDev(TOUCH_SDA_PIN, TOUCH_SCL_PIN, TOUCH_INT_PIN, TOUCH_RST_PIN,
                    SCREEN_WIDTH, SCREEN_HEIGHT);

ShowduinoUi ui;
ShowduinoEspNowTransport espNowTransport;
TimelineEngine timeline;           /* SD parse + cue upload helper only - not authority */
ShowRuntime gShowMirror;           /* read-only mirror of Stage ShowRuntime */

String usbInputBuffer;
String stageInputBuffer;

unsigned long lastHeartbeatMs = 0;
unsigned long lastHelloMs = 0;
unsigned long lastUiRefreshMs = 0;
unsigned long lastLvglTickMs = 0;
unsigned long lastStageReplyMs = 0;
unsigned long lastEspNowRecoverMs = 0;
unsigned long bootMs = 0;

uint8_t linkState = LINK_SEARCHING;
bool emergencyLocked = false;
bool espNowReady = false;
bool linkLostLogged = false;
bool syncRequested = false;
bool runtimeQuerySent = false;
uint32_t txCount = 0;
uint32_t rxCount = 0;
uint8_t gNodesOnline = 0;
bool tlEndAckSeen = false;
int tlEndAckCount = -1;

void markLinkDisconnected(const char *reason);
void requestLinkRetry();
void readEspNowReplies();
void readStageSerial();
void sendToStage(const String &command);
void requestStateSync();
void applyMirroredRuntime(const ShowRuntime &rt);
void onEmergencyActivatedDirectorUx();
void pushEmergencyTimelineSnapshot();
bool uploadShowTimelineToStage(const char *idOrName);

static void directorWakeDisplay(const char *tag) {
  Serial.printf("[%s] Display wake\n", tag);
  backlightNotifyActivity();
}

static void onEmergencyClearConfirm() {
  sendToStage(SHOWDUINO_LEGACY_EMERGENCY_CLEAR_CONFIRM);
}

static void onEmergencyClearCancel() {
  sendToStage(SHOWDUINO_LEGACY_EMERGENCY_CLEAR_CANCEL);
}

#if SHOWDUINO_OS2_SHELL
void publishOs2Services() {
  Os2::publishShow(
      gShowMirror.showName,
      (uint8_t)gShowMirror.state,
      gShowMirror.elapsedMs,
      gShowMirror.remainingMs,
      gShowMirror.totalDurationMs,
      gShowMirror.currentCue,
      gShowMirror.totalCues,
      gShowMirror.loaded != 0,
      gShowMirror.running != 0,
      gShowMirror.paused != 0,
      gShowMirror.emergency != 0 || emergencyLocked,
      gShowMirror.finished != 0);
  Os2::publishLink(
      linkState,
      gNodesOnline,
      (uint8_t)SHOWDUINO_EXPECTED_NODES,
      (uint32_t)lastStageReplyMs,
      (uint32_t)millis(),
      espNowReady,
      txCount,
      rxCount);
  Os2::publishSafety(emergencyLocked);
}

void syncOs2Catalogue() {
  ShowManager &sm = gStorage.showManager();
  Os2::ProductionManifest items[SHOW_INDEX_MAX];
  int n = 0;
  for (uint8_t i = 0; i < sm.size() && n < SHOW_INDEX_MAX; ++i) {
    const ShowIndexEntry *e = sm.get(i);
    if (!e || !e->id[0]) continue;
    Os2::ProductionManifest &p = items[n++];
    memset(&p, 0, sizeof(p));
    strncpy(p.id, e->id, sizeof(p.id) - 1);
    strncpy(p.name, e->name[0] ? e->name : e->id, sizeof(p.name) - 1);
    strncpy(p.description, e->description, sizeof(p.description) - 1);
    strncpy(p.version, e->version, sizeof(p.version) - 1);
    strncpy(p.author, e->author, sizeof(p.author) - 1);
    strncpy(p.lastEdited, e->modified, sizeof(p.lastEdited) - 1);
    strncpy(p.entryShow, e->id, sizeof(p.entryShow) - 1);
    p.durationSeconds = e->durationSeconds;
    p.hasThumbnail = e->hasThumbnail;
    p.capabilities.sceneCount = e->cueCount;
    p.capabilities.audio = true;     /* package may include audio/ - refined later */
    p.capabilities.lighting = true;
    p.capabilities.effects = false;
    p.capabilities.audioTrackCount = 0;
    p.readiness = Os2::StatusLevel::Healthy;
  }
  Os2::publishCatalogue(items, n);

  /* Seed session from Director config last show if present. */
  const DirectorConfig &cfg = gStorage.getConfig();
  if (cfg.lastShow[0]) {
    Os2::sessionService().setLastProduction(cfg.lastShow);
    Os2::assetService().select(cfg.lastShow);
  }
}

void drainOs2Commands() {
  Os2::Command cmd;
  while (Os2::commandService().takeNext(cmd)) {
    using CT = Os2::CommandType;
    switch (cmd.type) {
      case CT::LoadProduction: {
        ShowDefinition def;
        if (!gStorage.showManager().loadShow(cmd.arg, def)) {
          ui.appendLog(String("CMD LoadProduction failed: ") + cmd.arg);
          Os2::commandService().markFailed(cmd.seq, "missing production");
        } else {
          ui.setLoadedShowName(def.name);
          DirectorConfig &cfg = gStorage.getConfig();
          strncpy(cfg.lastShow, def.id, sizeof(cfg.lastShow) - 1);
          gStorage.markConfigDirty();
          gStorage.startShowLog(def.id);
          uploadShowTimelineToStage(def.id);
          Os2::sessionService().setLastProduction(def.id);
          ui.appendLog(String("CMD loaded: ") + def.name);
          Os2::commandService().markSucceeded(cmd.seq, def.name);
          Os2::shell().openApp(Os2::AppId::Dashboard);
        }
        break;
      }
      case CT::StartShow: {
        const char *key = nullptr;
        if (gStorage.showManager().hasCurrentShow()) {
          key = gStorage.showManager().currentShow().id;
        } else if (gShowMirror.showName[0]) {
          key = gShowMirror.showName;
        }
        if (key && key[0]) {
          sendToStage(String("SHOW:RUN:") + key);
          Os2::commandService().markSucceeded(cmd.seq);
          ui.appendLog("CMD StartShow");
        } else {
          Os2::commandService().markFailed(cmd.seq, "nothing loaded");
          ui.appendLog("CMD StartShow failed - nothing loaded");
        }
        break;
      }
      case CT::StopShow:
        sendToStage("SHOW:STOP");
        Os2::commandService().markSucceeded(cmd.seq);
        break;
      case CT::PauseShow:
        sendToStage("SHOW:PAUSE");
        Os2::commandService().markSucceeded(cmd.seq);
        break;
      case CT::ResumeShow:
        sendToStage("SHOW:RESUME");
        Os2::commandService().markSucceeded(cmd.seq);
        break;
      case CT::EmergencyStop:
        sendToStage("EMERGENCY:STOP");
        emergencyLocked = true;
        ui.setEmergencyLocked(true);
        Os2::commandService().markSucceeded(cmd.seq);
        break;
      case CT::EmergencyClear:
        sendToStage("EMERGENCY:CLEAR");
        Os2::commandService().markSucceeded(cmd.seq);
        break;
      case CT::SelectProduction:
        Os2::assetService().select(cmd.arg);
        Os2::commandService().markSucceeded(cmd.seq);
        break;
      case CT::OpenApp: {
        Os2::IApp *app = Os2::apps().findByName(cmd.arg);
        if (app) {
          Os2::shell().openApp(app);
          Os2::commandService().markSucceeded(cmd.seq);
        } else {
          Os2::commandService().markFailed(cmd.seq, "unknown app");
        }
        break;
      }
      default:
        Os2::commandService().markFailed(cmd.seq, "unhandled");
        break;
    }
  }
}
#endif

void applyLinkState(uint8_t state) {
  uint8_t prev = linkState;
  if (linkState == state) return;
  linkState = state;
  ui.setLinkState(state);
  if (state == LINK_DISCONNECTED) {
    if (prev != LINK_DISCONNECTED) SD_LOGW("DIRECTOR", "Comms lost");
    ui.markRelayStaleUnknown();
    syncRequested = false;
    runtimeQuerySent = false;
    ui.setSynchronising(false);
    gShowMirror.stageConnected = 0;
  } else if (state == LINK_READY && prev != LINK_READY) {
    SD_LOGI("DIRECTOR", "Comms online");
    directorAmbientPulse(DIRECTOR_AMBIENT_EVT_CONNECTION_RESTORED);
    requestStateSync();
  }
  ui.updateStatusWidgets(false);
#if SHOWDUINO_OS2_SHELL
  publishOs2Services();
#endif
}

void onStorageStatus(const StorageStatus &st) {
  static StorageBootStage lastLogged = StorageBootStage::Idle;
  if (st.stage != lastLogged) {
    lastLogged = st.stage;
    Serial.printf("[StorageUI] %s\n", st.bootMessage);
  }
}

// =========================================================
// Stage Engine command sender
// Primary route: ESP-NOW -> C3 bridge -> P4 UART.
// Backup route: direct UART for bench/service testing.
// =========================================================
bool isQuietLinkTraffic(const String &msg) {
  return msg == SHOWDUINO_LEGACY_HEARTBEAT ||
         msg == SHOWDUINO_LEGACY_ACK_HEARTBEAT ||
         msg == "OK:HEARTBEAT" ||
         msg == SHOWDUINO_LEGACY_HELLO ||
         msg == SHOWDUINO_LEGACY_READY ||
         msg == SHOWDUINO_LEGACY_SHOWDUINO_STAGE ||
         msg == "BOOT:STAGE_ENGINE_READY" ||
         msg == SHOWDUINO_WIRE_SNAPSHOT_BEGIN ||
         msg == SHOWDUINO_WIRE_SNAPSHOT_END ||
         msg == "ERR:UNKNOWN_COMMAND" ||
         msg.startsWith("ERR:UNKNOWN_COMMAND:") ||
         msg.startsWith("STATE:") ||
         msg.startsWith(SHOW_RUNTIME_WIRE_PREFIX) ||
         /* Quiet 1 Hz clock pushes; keep TIME:REQUEST visible for diagnostics. */
         (msg.startsWith(SHOWDUINO_LEGACY_TIME_PREFIX) &&
          msg != SHOWDUINO_LEGACY_TIME_REQUEST);
}

// =========================================================
// Stage Engine response parser (UART fallback + ESP-NOW replies)
// =========================================================
void handleStageLine(String line) {
  line.trim();
  if (line.length() == 0) return;

  rxCount++;
  lastStageReplyMs = millis();
  linkLostLogged = false;
  ui.noteStageReply(lastStageReplyMs);

  // Any valid Stage reply proves the link is alive (reconnects from DISCONNECTED).
  applyLinkState(LINK_READY);

  /* HELLO / sendCapabilities tokens. TIME:READY|UNSYNCED must not be treated as SUE clock. */
  if (line == "TIME:READY" || line == "TIME:UNSYNCED") {
    ui.applyStageCapabilityLine(line.c_str());
    ui.setTraffic(txCount, rxCount);
    ui.updateStatusWidgets(false);
    return;
  }

  /* SUE TimeService - display only; do not invent a local clock. */
  if (line.startsWith(SHOWDUINO_LEGACY_TIME_PREFIX)) {
    ui.applySueTimeWire(line.c_str());
    return;
  }

  ui.applyStageCapabilityLine(line.c_str());

  if (ui.applyGatewayWire(line.c_str()) || ui.applyUpdateWire(line.c_str())) {
    return;
  }

  if (line == SHOWDUINO_WIRE_SNAPSHOT_BEGIN) {
    ui.beginSnapshot();
    return;
  }
  if (line == SHOWDUINO_WIRE_SNAPSHOT_END) {
    ui.endSnapshot();
    syncRequested = false;
    ui.appendLog("Sync complete");
    return;
  }

  ShowduinoShowRuntimeWire showW = showduino_parse_state_show(line.c_str());
  if (showW != SHOWDUINO_SHOW_WIRE_INVALID) {
    /* Legacy STATE:SHOW - prefer mirrored SHOW:RUNTIME when present. */
    if (gShowMirror.revision == 0) {
      if (showW == SHOWDUINO_SHOW_WIRE_PLAYING) ui.setShowView(DeskShowView::Playing);
      else if (showW == SHOWDUINO_SHOW_WIRE_EMERGENCY) ui.setShowView(DeskShowView::Emergency);
      else ui.setShowView(DeskShowView::Idle);
    } else if (showW == SHOWDUINO_SHOW_WIRE_EMERGENCY) {
      ui.setShowView(DeskShowView::Emergency);
    }
  }

  if (line.startsWith(SHOW_STATE_WIRE_PREFIX)) {
    ShowState st = showStateFromName(line.c_str() + strlen(SHOW_STATE_WIRE_PREFIX));
    gShowMirror.state = st;
    showRuntimeSyncFlags(&gShowMirror);
    refreshTimelineUi();
  }

  if (line.startsWith(SHOW_RUNTIME_WIRE_PREFIX) ||
      (line.indexOf('|') > 0 && line.startsWith("SHOW:RUNTIME"))) {
    ShowRuntime parsed;
    if (showRuntimeParse(line.c_str(), &parsed)) {
      applyMirroredRuntime(parsed);
    }
  }

  if (line == SHOW_FINISHED_WIRE) {
    gStorage.endShowLog("complete");
  }

  if (line == SHOWDUINO_LEGACY_DIRECTOR_LOCATE) {
    directorLocateOnCommand(millis());
    ui.appendLog("Director locate");
    ui.pushOperatorEvent("Director locate");
  }

  if (line == SHOWDUINO_LEGACY_EMERGENCY_CLEAR_REQUEST) {
    directorWakeDisplay("ESTOP");
    gDirectorEmergencyClearDialog.show(millis());
    ui.pushOperatorEvent("Emergency clear requested");
  }

  if (line == SHOWDUINO_LEGACY_EMERGENCY_CLEAR_EXPIRED) {
    gDirectorEmergencyClearDialog.hide();
    ui.noteEmergencyClearCancelled();
    ui.appendLog("Emergency clear request expired");
    ui.pushOperatorEvent("Clear request expired");
  }

  if (line == SHOWDUINO_LEGACY_EMERGENCY_CLEAR_OK) {
    gDirectorEmergencyClearDialog.hide();
  }

  {
    ShowduinoEmergencySourceWire src{};
    if (showduino_parse_state_emergency_source(line.c_str(), &src)) {
      ui.applyEmergencySourceWire(src);
    }
    const int safety = showduino_parse_state_safety_estop_fault(line.c_str());
    if (safety >= 0) ui.setSafetyEstopFault(safety == 1);
    const ShowduinoEmergencyNodeWire enW = showduino_parse_state_node_emergency(line.c_str());
    if (enW != SHOWDUINO_EMERGENCY_NODE_WIRE_INVALID) {
      ui.applyEmergencyNodeWire(enW);
    }
    ShowduinoEmergencyDetailWire ed{};
    if (showduino_parse_state_node_emergency_detail(line.c_str(), &ed)) {
      ui.applyEmergencyNodeDetail(ed);
    }
    ShowduinoEmergencyStationWire es{};
    if (showduino_parse_state_node_emergency_station(line.c_str(), &es)) {
      ui.applyEmergencyStationWire(es);
    }
  }

  ShowduinoEmergencyWire emW = showduino_parse_state_emergency(line.c_str());
  if (emW != SHOWDUINO_EMERGENCY_WIRE_INVALID) {
    bool nowLocked = (emW == SHOWDUINO_EMERGENCY_WIRE_ACTIVE);
    Serial.printf("[E-Stop] Stage STATE:EMERGENCY:%s (was %s)\n",
                  nowLocked ? "ACTIVE" : "CLEAR",
                  emergencyLocked ? "LOCKED" : "CLEAR");
    if (nowLocked && !emergencyLocked) {
      onEmergencyActivatedDirectorUx();
    }
    emergencyLocked = nowLocked;
    ui.markEmergencyStateFromStage();
    ui.setEmergencyLocked(emergencyLocked);
    if (!nowLocked) {
      gDirectorEmergencyClearDialog.hide();
    }
  }

  ShowduinoLampNodeWire lampW = showduino_parse_state_node_lamp(line.c_str());
  if (lampW != SHOWDUINO_LAMP_NODE_WIRE_INVALID) {
    ui.setLampNodeAvail(lampW);
    gNodesOnline = ui.getNodeCount();
#if SHOWDUINO_OS2_SHELL
    publishOs2Services();
#endif
  }
  {
    ShowduinoLampDetailWire ldet{};
    if (showduino_parse_state_node_lamp_detail(line.c_str(), &ldet)) {
      ui.setLampNodeDetail(ldet);
    }
  }
  {
    ShowduinoLampSensorWire lsen{};
    if (showduino_parse_state_node_lamp_sensors(line.c_str(), &lsen)) {
      ui.setLampNodeSensors(lsen);
    }
  }
  if (line.startsWith("LAMP:ACCEPTED:")) {
    ui.noteLampAccepted();
  }
  if (line.startsWith("LAMP:FAILED:") || line.startsWith("REJECTED:LAMP:")) {
    const int colon = line.lastIndexOf(':');
    ui.noteLampFailed(colon >= 0 ? line.substring(colon + 1).c_str() : "FAILED");
  }

  ShowduinoPixelNodeWire pixW = showduino_parse_state_node_pixel(line.c_str());
  if (pixW != SHOWDUINO_PIXEL_NODE_WIRE_INVALID) {
    ui.setPixelNodeAvail(pixW);
    gNodesOnline = ui.getNodeCount();
#if SHOWDUINO_OS2_SHELL
    publishOs2Services();
#endif
  }
  {
    ShowduinoPixelDetailWire pdet{};
    if (showduino_parse_state_node_pixel_detail(line.c_str(), &pdet)) {
      ui.setPixelNodeDetail(pdet);
    }
  }

  ShowduinoMosfetNodeWire mosW = showduino_parse_state_node_mosfet(line.c_str());
  if (mosW != SHOWDUINO_MOSFET_NODE_WIRE_INVALID) {
    ui.setMosfetNodeAvail(mosW);
    gNodesOnline = ui.getNodeCount();
#if SHOWDUINO_OS2_SHELL
    publishOs2Services();
#endif
  }
  {
    ShowduinoMosfetDetailWire mdet{};
    if (showduino_parse_state_node_mosfet_detail(line.c_str(), &mdet)) {
      ui.setMosfetNodeDetail(mdet);
    }
  }

  ShowduinoAudioNodeWire audioW = showduino_parse_state_node_audio(line.c_str());
  if (audioW != SHOWDUINO_AUDIO_NODE_WIRE_INVALID) {
    static char sLastAudioWire[48] = "";
    if (showduino_log_changed(sLastAudioWire, sizeof(sLastAudioWire), line.c_str())) {
      SD_LOGI("DIRECTOR", "Audio node %s", line.c_str());
    }
    ui.setAudioNodeWire(audioW);
    gNodesOnline = ui.getNodeCount();
#if SHOWDUINO_OS2_SHELL
    publishOs2Services();
#endif
  }
  {
    ShowduinoAudioDetailWire det;
    if (showduino_parse_state_node_audio_detail(line.c_str(), &det)) {
      ui.applyAudioNodeDetail(det);
    }
    ShowduinoAudioSoundWire snd;
    if (showduino_parse_state_node_audio_sound(line.c_str(), &snd)) {
      ui.applyAudioNodeSound(snd);
    }
    if (line.startsWith(SHOWDUINO_WIRE_STATE_NODE_AUDIO_CAPS_PREFIX)) {
      ui.applyAudioNodeCaps(line.c_str() + (sizeof(SHOWDUINO_WIRE_STATE_NODE_AUDIO_CAPS_PREFIX) - 1));
    }
    if (line.startsWith(SHOWDUINO_WIRE_STATE_NODE_AUDIO_META_PREFIX)) {
      const char *p = line.c_str() + (sizeof(SHOWDUINO_WIRE_STATE_NODE_AUDIO_META_PREFIX) - 1);
      char fw[12] = "";
      char mac[18] = "";
      const char *comma = strchr(p, ',');
      if (comma) {
        size_t n = (size_t)(comma - p);
        if (n >= sizeof(fw)) n = sizeof(fw) - 1;
        memcpy(fw, p, n);
        strncpy(mac, comma + 1, sizeof(mac) - 1);
      } else {
        strncpy(fw, p, sizeof(fw) - 1);
      }
      ui.applyAudioNodeMeta(fw, mac);
    }
    if (line.startsWith(SHOWDUINO_WIRE_STATE_NODE_AUDIO_INV_PREFIX)) {
      const char *p = line.c_str() + (sizeof(SHOWDUINO_WIRE_STATE_NODE_AUDIO_INV_PREFIX) - 1);
      uint16_t page = (uint16_t)atoi(p);
      const char *c1 = strchr(p, ':');
      uint16_t total = 0;
      char names[SHOWDUINO_AUDIO_INV_WIRE_MAX][SHOWDUINO_AUDIO_INV_NAME_MAX + 1] = {};
      uint8_t count = 0;
      if (c1) {
        total = (uint16_t)atoi(c1 + 1);
        const char *list = strchr(c1 + 1, ':');
        if (list && list[1]) {
          list++;
          char buf[(SHOWDUINO_AUDIO_INV_WIRE_MAX * (SHOWDUINO_AUDIO_INV_NAME_MAX + 1)) + 1];
          strncpy(buf, list, sizeof(buf) - 1);
          char *item = buf;
          while (item && *item && count < SHOWDUINO_AUDIO_INV_WIRE_MAX) {
            char *comma2 = strchr(item, ',');
            if (comma2) *comma2 = '\0';
            strncpy(names[count], item, SHOWDUINO_AUDIO_INV_NAME_MAX);
            names[count][SHOWDUINO_AUDIO_INV_NAME_MAX] = '\0';
            count++;
            item = comma2 ? comma2 + 1 : nullptr;
          }
        }
      }
      ui.applyAudioNodeInv(page, total, names, count);
    }
  }

  /* Legacy emergency companions */
  if (line == SHOWDUINO_LEGACY_STATUS_ELOCKED) {
    if (!emergencyLocked) onEmergencyActivatedDirectorUx();
    emergencyLocked = true;
    ui.markEmergencyStateFromStage();
    ui.setEmergencyLocked(true);
  }
  if (line == SHOWDUINO_LEGACY_STATUS_ECLEARED) {
    emergencyLocked = false;
    ui.markEmergencyStateFromStage();
    ui.setEmergencyLocked(false);
    gDirectorEmergencyClearDialog.hide();
    ui.pushOperatorEvent("Stage cleared emergency");
  }

  /* Fingerprint: early Stage Engine (pre-ShowRuntime) - operator must reflash P4. */
  if (line == "STATUS:READY") {
    ui.appendLog("WARN: legacy Stage (STATUS:READY) - flash ShowduinoStageEngineP4");
    ui.pushOperatorEvent("Stage firmware outdated - reflash P4");
  }

  if (line == SHOWDUINO_LEGACY_ERR_ESTOP_HELD ||
      line.startsWith("ERR:EMERGENCY_CLEAR:") ||
      line.startsWith(SHOWDUINO_LEGACY_EMERGENCY_CLEAR_REJECTED_PREFIX)) {
    ui.noteEmergencyClearRejected();
    if (line.endsWith("BUTTON_ACTIVE") || line == SHOWDUINO_LEGACY_ERR_ESTOP_HELD) {
      ui.appendLog("Cannot clear Emergency. Release the Emergency button first.");
      ui.pushOperatorEvent("Release the Emergency button first");
    } else if (line.endsWith("NO_REQUEST")) {
      ui.appendLog("CLEAR rejected - no pending Director clear request");
      ui.pushOperatorEvent("Clear request is not pending");
      gDirectorEmergencyClearDialog.hide();
      ui.noteEmergencyClearCancelled();
    } else if (line.endsWith("TIMEOUT")) {
      ui.appendLog("CLEAR rejected - request timed out");
      ui.pushOperatorEvent("Clear request timed out");
      gDirectorEmergencyClearDialog.hide();
      ui.noteEmergencyClearCancelled();
    } else if (line.endsWith("SUPERSEDED")) {
      ui.appendLog("CLEAR cancelled - new Emergency assertion");
      ui.pushOperatorEvent("Clear request cancelled by new Emergency");
      gDirectorEmergencyClearDialog.hide();
      ui.noteEmergencyClearCancelled();
    } else {
      ui.appendLog("CLEAR rejected - " + line);
      ui.pushOperatorEvent("Emergency clear rejected");
      gDirectorEmergencyClearDialog.hide();
      ui.noteEmergencyClearCancelled();
    }
  }

  if (line == "ERR:UNKNOWN_COMMAND" || line.startsWith("ERR:UNKNOWN_COMMAND:")) {
    static uint32_t lastUnknownMs = 0;
    static uint16_t unknownBurst = 0;
    unknownBurst++;
    if ((millis() - lastUnknownMs) >= 4000UL) {
      lastUnknownMs = millis();
      if (line.startsWith("ERR:UNKNOWN_COMMAND:") && line.length() > 21) {
        ui.appendLog(String("Stage rejected: ") + line.substring(21));
      } else {
        ui.appendLog("Stage rejected command (unknown) - check P4 firmware build");
      }
      if (unknownBurst > 1) {
        ui.appendLog(String("Stage unknown-command burst x") + String(unknownBurst));
      }
      unknownBurst = 0;
    }
    return;
  }

  if (line.startsWith("ACK:SHOW:TL:END:")) {
    tlEndAckSeen = true;
    tlEndAckCount = line.substring(strlen("ACK:SHOW:TL:END:")).toInt();
  }

  int relayCh = 0;
  ShowduinoRelayKnowledgeWire relayK = SHOWDUINO_RELAY_WIRE_INVALID;
  if (showduino_parse_state_relay(line.c_str(), &relayCh, &relayK) == 0) {
    if (relayK == SHOWDUINO_RELAY_WIRE_ON) ui.noteConfirmedSnapshot((uint8_t)relayCh, true);
    else if (relayK == SHOWDUINO_RELAY_WIRE_OFF) ui.noteConfirmedSnapshot((uint8_t)relayCh, false);
    else if (relayK == SHOWDUINO_RELAY_WIRE_UNKNOWN) ui.applyRelayUnknown((uint8_t)relayCh);
    else if (relayK == SHOWDUINO_RELAY_WIRE_FAULT) ui.applyRelayFault((uint8_t)relayCh);
  }

  char reason[40];
  if (showduino_parse_relay_outcome(line.c_str(), SHOWDUINO_WIRE_REJECTED_RELAY_PREFIX,
                                    &relayCh, reason, sizeof(reason)) == 0) {
    ui.clearRelayPendingKeepLast((uint8_t)relayCh);
    ui.appendLog(String("Rejected R") + relayCh + ": " + reason);
  }
  if (showduino_parse_relay_outcome(line.c_str(), SHOWDUINO_WIRE_FAILED_RELAY_PREFIX,
                                    &relayCh, reason, sizeof(reason)) == 0) {
    ui.clearRelayPendingKeepLast((uint8_t)relayCh);
    ui.appendLog(String("Failed R") + relayCh + ": " + reason);
  }

  /* ACCEPTED:RELAY - request accepted, not completed; leave pending visuals */
  if (line.startsWith(SHOWDUINO_WIRE_ACCEPTED_RELAY_PREFIX)) {
    /* no confirmed mutation */
  }

  /* Do NOT treat ACK:RELAY / OK:RELAY as confirmed Stage 3 state.
     Confirmed display comes only from STATE:RELAY. */

  if (line.startsWith(SHOWDUINO_WIRE_UNSUPPORTED_PREFIX) ||
      line.startsWith(SHOWDUINO_WIRE_NOT_IMPLEMENTED_PREFIX) ||
      line.startsWith(SHOWDUINO_WIRE_NODE_UNAVAILABLE_PREFIX)) {
    /* Log only - honest failure paths */
  }

  if (!isQuietLinkTraffic(line)) {
    /* Operator log / Serial: meaningful events only. Quiet covers heartbeats,
     * STATE sync, unknown-command bursts already handled above. */
    ui.appendLog("RX <- Stage: " + line);
  }

  ui.setEmergencyLocked(emergencyLocked);
  ui.setTraffic(txCount, rxCount);
  ui.updateStatusWidgets(false);
}

void sendToStage(const String &command) {
  bool sentByEspNow = false;

#if SHOWDUINO_USE_ESPNOW
  if (espNowReady) {
    sentByEspNow = espNowTransport.sendCommand(command);
  }
#endif

#if SHOWDUINO_USE_UART_FALLBACK
  if (!sentByEspNow) {
    Serial1.println(command);
  }
#endif

  txCount++;
  if (command == SHOWDUINO_LEGACY_HELLO) lastHelloMs = millis();

  /* Emergency lock: E-STOP may set local activating feedback in UI;
     CLEAR must wait for STATE:EMERGENCY:CLEAR (do not unlock here). */
  if (command == SHOWDUINO_LEGACY_EMERGENCY_STOP) {
    Serial.println("[E-Stop] TX EMERGENCY:STOP to Stage");
    if (!emergencyLocked) onEmergencyActivatedDirectorUx();
    emergencyLocked = true;
    ui.setEmergencyLocked(true);
  } else if (command == SHOWDUINO_LEGACY_EMERGENCY_CLEAR) {
    Serial.println("[E-Stop] TX EMERGENCY:CLEAR request to Stage");
  } else if (command == SHOWDUINO_LEGACY_EMERGENCY_CLEAR_CONFIRM) {
    Serial.println("[E-Stop] TX emergency clear confirm to Stage (await STATE:EMERGENCY:CLEAR)");
  } else if (command == SHOWDUINO_LEGACY_EMERGENCY_CLEAR_CANCEL) {
    Serial.println("[E-Stop] TX EMERGENCY:CLEAR_CANCEL to Stage");
  }

  ui.setTraffic(txCount, rxCount);

  if (!isQuietLinkTraffic(command)) {
    if (sentByEspNow) ui.appendLog("TX -> Stage: " + command);
    else ui.appendLog("TX -> Stage UART: " + command);
  }

  // Drain any replies that arrived during the blocking send wait.
  readEspNowReplies();
}

void requestStateSync() {
  if (syncRequested) return;
  syncRequested = true;
  ui.setSynchronising(true);
  ui.appendLog("Sync: STATUS:REQUEST + SHOW:STATE? + TIME:REQUEST");
  sendToStage(SHOWDUINO_LEGACY_STATUS_REQUEST);
  sendToStage(SHOW_STATE_QUERY);
  sendToStage(SHOWDUINO_LEGACY_TIME_REQUEST);
  runtimeQuerySent = true;
}

void applyMirroredRuntime(const ShowRuntime &rt) {
  ShowState prev = gShowMirror.state;
  gShowMirror = rt;
  gShowMirror.stageConnected = (linkState == LINK_READY) ? 1 : 0;

  if (rt.showName[0]) ui.setLoadedShowName(rt.showName);

  ui.applyRuntimeMirror(gShowMirror);

  if (rt.state == SHOW_STATE_EMERGENCY_STOP || rt.emergency) {
    if (prev != SHOW_STATE_EMERGENCY_STOP) {
      onEmergencyActivatedDirectorUx();
    }
    if (!emergencyLocked) {
      emergencyLocked = true;
      ui.setEmergencyLocked(true);
    }
  } else if (prev == SHOW_STATE_EMERGENCY_STOP || emergencyLocked) {
    /* Runtime left EMERGENCY_STOP - unlock even if STATE:EMERGENCY:CLEAR was dropped. */
    emergencyLocked = false;
    ui.setEmergencyLocked(false);
  }

  refreshTimelineUi();
#if SHOWDUINO_OS2_SHELL
  publishOs2Services();
#endif
}

/** Timeline cue strings are executed by Stage - Director does not dispatch. */
void timelineDispatch(const char *command) {
  (void)command;
}

void refreshTimelineUi() {
  uint8_t pct = 0;
  if (gShowMirror.totalDurationMs > 0) {
    if (gShowMirror.elapsedMs >= gShowMirror.totalDurationMs) pct = 100;
    else pct = (uint8_t)((gShowMirror.elapsedMs * 100UL) / gShowMirror.totalDurationMs);
  } else if (gShowMirror.finished) {
    pct = 100;
  }

  ui.setTimelinePlayback(gShowMirror.showName[0] ? gShowMirror.showName : "-",
                         showStateName(gShowMirror.state),
                         gShowMirror.elapsedMs,
                         gShowMirror.remainingMs,
                         pct);
}

void serviceTimeline() {
  /* Stage owns playback - Director only mirrors SHOW:RUNTIME. */
}

bool uploadShowTimelineToStage(const char *idOrName) {
  if (!idOrName || !idOrName[0]) return false;

  ShowManager &sm = gStorage.showManager();
  const ShowIndexEntry *entry = sm.findByIdOrName(idOrName);
  char showId[64] = {};
  char showName[64] = {};

  if (entry) {
    strncpy(showId, entry->id, sizeof(showId) - 1);
    strncpy(showName, entry->name[0] ? entry->name : entry->id, sizeof(showName) - 1);
  } else {
    strncpy(showId, idOrName, sizeof(showId) - 1);
    strncpy(showName, idOrName, sizeof(showName) - 1);
  }

  ShowDefinition def;
  if (!sm.hasCurrentShow() || strcmp(sm.currentShow().id, showId) != 0) {
    if (!sm.loadShow(showId, def)) {
      ui.appendLog(String("LOAD failed - missing show ") + showId);
      return false;
    }
  } else {
    def = sm.currentShow();
  }
  if (def.name[0]) strncpy(showName, def.name, sizeof(showName) - 1);

  char path[STORAGE_MAX_PATH_LEN];
  if (!sm.timelinePath(showId, path, sizeof(path)) || !SD.exists(path)) {
    ui.appendLog(String("LOAD failed - missing timeline ") + path);
    return false;
  }

  timeline.setDispatch(timelineDispatch);
  if (!timeline.LoadTimeline(path)) {
    ui.appendLog("LOAD failed - timeline parse error");
    return false;
  }
  timeline.setShowName(showName);
  timeline.Stop();

  char loadCmd[96];
  snprintf(loadCmd, sizeof(loadCmd), "SHOW:LOAD:%s", showId);
  if (strlen(loadCmd) >= SHOWDUINO_DESK_COMMAND_MAX) {
    snprintf(loadCmd, sizeof(loadCmd), "SHOW:LOAD:%s", showName);
  }
  sendToStage(loadCmd);
  sendToStage("SHOW:TL:BEGIN");

  uint16_t sent = 0;
  uint16_t skipped = 0;
  for (uint16_t i = 0; i < timeline.cueTotal(); i++) {
    const TimelineCue *c = timeline.cueAt(i);
    if (!c || !c->command[0]) continue;
    char cueLine[SHOWDUINO_DESK_COMMAND_MAX];
    int n = snprintf(cueLine, sizeof(cueLine), "SHOW:TL:C:%lu:%s",
                     (unsigned long)c->timeMs, c->command);
    if (n <= 0 || n >= (int)sizeof(cueLine)) {
      skipped++;
      continue;
    }
    sendToStage(cueLine);
    sent++;
    if ((i & 7) == 0) {
      readEspNowReplies();
      yield();
    }
  }

  tlEndAckSeen = false;
  tlEndAckCount = -1;
  sendToStage("SHOW:TL:END");

  const unsigned long TL_END_ACK_MS = 2000UL;
  unsigned long t0 = millis();
  while (!tlEndAckSeen && (millis() - t0) < TL_END_ACK_MS) {
    readEspNowReplies();
    readStageSerial();
    delay(5);
  }

  char line[140];
  if (!tlEndAckSeen) {
    ui.appendLog("Timeline upload UNVERIFIED - no Stage confirmation");
    return false;
  }
  if (tlEndAckCount != (int)sent) {
    snprintf(line, sizeof(line),
             "Timeline upload FAILED - Director sent %u cues, Stage received %d",
             (unsigned)sent, tlEndAckCount);
    ui.appendLog(line);
    return false;
  }

  ui.setLoadedShowName(showName);
  snprintf(line, sizeof(line), "Uploaded show to Stage: %s (%u cues verified, %u skipped)",
           showName, (unsigned)sent, (unsigned)skipped);
  ui.appendLog(line);
  logEvent(LogLevel::Event, LogCategory::UserAction, "Shows", line);
  return true;
}

bool requestShowRun(const char *idOrName) {
  if (idOrName && idOrName[0]) {
    /* Ensure package metadata is local; Stage must already have timeline. */
    ShowManager &sm = gStorage.showManager();
    if (!sm.hasCurrentShow() || strcmp(sm.currentShow().id, idOrName) != 0) {
      const ShowIndexEntry *entry = sm.findByIdOrName(idOrName);
      if (entry) {
        ShowDefinition def;
        sm.loadShow(entry->id, def);
      }
    }
  }
  if (gShowMirror.state != SHOW_STATE_SHOW_LOADED &&
      gShowMirror.state != SHOW_STATE_PAUSED &&
      gShowMirror.state != SHOW_STATE_FINISHED &&
      gShowMirror.totalCues == 0) {
    /* Try upload then run if operator pressed RUN without LOAD. */
    const char *key = idOrName;
    if ((!key || !key[0]) && gStorage.showManager().hasCurrentShow()) {
      key = gStorage.showManager().currentShow().id;
    }
    if (key && key[0]) {
      if (!uploadShowTimelineToStage(key)) return false;
    }
  }
  sendToStage("SHOW:RUN");
  ui.appendLog("Requested SHOW:RUN (await Stage runtime)");
  return true;
}

void requestShowStop() {
  sendToStage("SHOW:STOP");
  ui.appendLog("Requested SHOW:STOP (await Stage runtime)");
}

void pushEmergencyTimelineSnapshot() {
  const char *name = gShowMirror.showName[0] ? gShowMirror.showName : "-";
  if (name[0] == '-' && gStorage.showManager().hasCurrentShow() &&
      gStorage.showManager().currentShow().name[0]) {
    name = gStorage.showManager().currentShow().name;
  }

  /* Prefer pre-emergency play state if mirror already says EMERGENCY_STOP. */
  const char *before = "RUNNING";
  if (gShowMirror.state != SHOW_STATE_EMERGENCY_STOP) {
    before = showStateName(gShowMirror.state);
  }

  ui.setEmergencyPlaybackSnapshot(
      name,
      before,
      gShowMirror.elapsedMs,
      (uint16_t)gShowMirror.currentCue,
      (uint16_t)gShowMirror.totalCues,
      gShowMirror.remainingMs,
      linkState == LINK_READY);
}

void onEmergencyActivatedDirectorUx() {
  /* Overlay only - Stage pauses timeline & owns ShowRuntime.emergency. */
  pushEmergencyTimelineSnapshot();
  refreshTimelineUi();
}

void handleUiCommand(const String &command) {
  gStorage.setLastCommand(command.c_str());
  // Do not SD-log every tap - keeps the UI responsive. Critical actions log below.
  if (command.startsWith("EMERGENCY:") || command.startsWith("STORAGE:") ||
      command.startsWith("SHOW:") || command == "STOPALL") {
    logEvent(LogLevel::Event, LogCategory::UserAction, "UI", command.c_str());
  }

  if (command == "UI:ESTOP:RESUME") {
    sendToStage("SHOW:RESUME");
    ui.pushOperatorEvent("Requested SHOW:RESUME (await Stage confirmation)");
    logEvent(LogLevel::Event, LogCategory::Emergency, "E-Stop", "Show Resume requested");
    return;
  }
  if (command == "UI:ESTOP:ABORT") {
    /* Always CLEAR first - works even on older Stage builds that lack SHOW:STOP. */
    sendToStage(SHOWDUINO_LEGACY_EMERGENCY_CLEAR);
    delay(20);
    sendToStage(SHOWDUINO_LEGACY_SHOW_STOP);
    sendToStage(SHOWDUINO_LEGACY_STOP_ALL);
    ui.pushOperatorEvent("Abort: CLEAR + STOP sent - awaiting Stage");
    logEvent(LogLevel::Event, LogCategory::Emergency, "E-Stop", "Abort CLEAR+STOP");
    gStorage.endShowLog("aborted");
    return;
  }
  if (command == "UI:ESTOP:DIAG") {
    logEvent(LogLevel::Event, LogCategory::Emergency, "E-Stop", "Diagnostics viewed");
    return;
  }
  if (command == "UI:ESTOP:ACK") {
    logEvent(LogLevel::Event, LogCategory::Emergency, "E-Stop", "Operator Acknowledged");
    return;
  }

  if (command == "UI:NET:RETRY" || command == "UI:NET:SCAN") {
    requestLinkRetry();
    return;
  }

  if (command == "UI:SYSTEM:REBOOT") {
    Serial.println("[Director] reboot requested");
    delay(400);
    ESP.restart();
    return;
  }

  if (command == "STORAGE:BACKUP") {
    ui.showBackup();
    ui.appendLog(createManualBackup() ? "Backup created" : "Backup failed");
    return;
  }
  if (command == "STORAGE:UNMOUNT") {
    ui.appendLog(safelyUnmountSD() ? "SD safely unmounted" : "Unmount failed");
    return;
  }
  if (command == "STORAGE:EXPORT") {
    ui.appendLog(exportDiagnostics() ? "Diagnostics exported" : "Diagnostics export failed");
    return;
  }
  if (command == "STORAGE:REPAIR") {
    ui.appendLog(gStorage.repairFolders() ? "Folder structure repaired" : "Repair failed");
    return;
  }
  if (command == "STORAGE:STATUS") {
    const StorageStatus &st = getStorageStatus();
    char line[160];
    snprintf(line, sizeof(line), "SD %s %s  free=%lluMB  save=%u",
             st.mounted ? "OK" : "DOWN",
             st.cardType,
             (unsigned long long)(st.freeBytes / (1024 * 1024)),
             (unsigned)st.saveState);
    ui.appendLog(line);
    return;
  }

  if (command == "UI:SHOW:REFRESH") {
    if (gStorage.isRecoveryMode()) {
      ui.appendLog("Show refresh failed - SD recovery mode");
      return;
    }
    bool ok = gStorage.showManager().refreshLibrary();
    ui.refreshShowLibrary(gStorage.showManager());
    ui.appendLog(ok ? "Show library rescanned from SD" : "Show library rescan failed");
#if SHOWDUINO_OS2_SHELL
    syncOs2Catalogue();
#endif
    return;
  }

  if (command == "UI:SHOW:LOAD") {
    if (!ui.hasSelectedShow()) {
      ui.appendLog("LOAD failed - no show selected");
      return;
    }
    ShowDefinition def;
    if (!gStorage.showManager().loadShow(ui.selectedShowId(), def)) {
      ui.appendLog(String("LOAD failed - missing show.json for ") + ui.selectedShowId());
      return;
    }
    ui.setLoadedShowName(def.name);
    DirectorConfig &cfg = gStorage.getConfig();
    strncpy(cfg.lastShow, def.id, sizeof(cfg.lastShow) - 1);
    gStorage.markConfigDirty();
    gStorage.startShowLog(def.id);
    uploadShowTimelineToStage(def.id);
    return;
  }

  if (command == "UI:SHOW:RUN" || command.startsWith("SHOW:RUN:") || command == "SHOW:START") {
    const char *key = nullptr;
    char keyBuf[64] = {};
    if (command.startsWith("SHOW:RUN:")) {
      strncpy(keyBuf, command.c_str() + strlen("SHOW:RUN:"), sizeof(keyBuf) - 1);
      key = keyBuf;
    } else if (gStorage.showManager().hasCurrentShow()) {
      key = gStorage.showManager().currentShow().id;
    } else if (ui.hasSelectedShow()) {
      key = ui.selectedShowId();
    }
    if (!key || !key[0]) {
      ui.appendLog("RUN failed - no show selected/loaded");
      return;
    }
    requestShowRun(key);
    directorAmbientPulse(DIRECTOR_AMBIENT_EVT_START_REQUESTED);
    return;
  }

  if (command == "UI:SHOW:STOP" || command == "SHOW:STOP" || command == "STOP:ALL") {
    requestShowStop();
    directorAmbientPulse(DIRECTOR_AMBIENT_EVT_STOP_REQUESTED);
    return;
  }

  if (command == "SHOW:PAUSE" || command == "UI:SHOW:PAUSE") {
    sendToStage("SHOW:PAUSE");
    ui.appendLog("Requested SHOW:PAUSE (await Stage)");
    directorAmbientPulse(DIRECTOR_AMBIENT_EVT_PAUSE_REQUESTED);
    return;
  }

  if (command == "SHOW:RESUME" || command == "UI:SHOW:RESUME") {
    sendToStage("SHOW:RESUME");
    ui.appendLog("Requested SHOW:RESUME (await Stage)");
    directorAmbientPulse(DIRECTOR_AMBIENT_EVT_RESUME_REQUESTED);
    return;
  }

  if (command.startsWith("SETTINGS:TIMEOUT:")) {
    static const uint8_t kPresets[] = {0, 1, 3, 5, 10, 30};
    DirectorConfig &cfg = gStorage.getConfig();
    uint8_t next = cfg.screenTimeoutMinutes;

    if (command == "SETTINGS:TIMEOUT:CYCLE") {
      uint8_t idx = 0;
      bool found = false;
      for (uint8_t i = 0; i < sizeof(kPresets); i++) {
        if (kPresets[i] == cfg.screenTimeoutMinutes) {
          idx = (uint8_t)((i + 1) % sizeof(kPresets));
          found = true;
          break;
        }
      }
      if (!found) {
        idx = 0;
        for (uint8_t i = 0; i < sizeof(kPresets); i++) {
          if (kPresets[i] > cfg.screenTimeoutMinutes) {
            idx = i;
            break;
          }
        }
      }
      next = kPresets[idx];
    } else {
      next = (uint8_t)command.substring(strlen("SETTINGS:TIMEOUT:")).toInt();
    }

    cfg.screenTimeoutMinutes = next;
    gStorage.markConfigDirty();
    gStorage.saveAllConfiguration();
    backlightConfigure(cfg.screenTimeoutMinutes, cfg.brightness);
    backlightNotifyActivity();
    ui.setScreenTimeoutMinutes(next);
    if (next == 0) ui.appendLog("Auto backlight: NEVER");
    else ui.appendLog(String("Auto backlight: ") + next + " min");
    return;
  }

  if (command == "SETTINGS:AMBIENT:TOGGLE" ||
      command == "SETTINGS:AMBIENT:BRI:CYCLE" ||
      command == "SETTINGS:ANIM:CYCLE") {
    DirectorConfig &cfg = gStorage.getConfig();
    if (command == "SETTINGS:AMBIENT:TOGGLE") {
      cfg.ambientLedsEnabled = !cfg.ambientLedsEnabled;
    } else if (command == "SETTINGS:AMBIENT:BRI:CYCLE") {
      static const uint8_t kBri[] = {40, 100, 180, 255};
      uint8_t idx = 0;
      bool found = false;
      for (uint8_t i = 0; i < sizeof(kBri); i++) {
        if (kBri[i] == cfg.ambientBrightness) {
          idx = (uint8_t)((i + 1) % sizeof(kBri));
          found = true;
          break;
        }
      }
      if (!found) idx = 2;
      cfg.ambientBrightness = kBri[idx];
    } else {
      cfg.uiAnimationMode = (uint8_t)directorUiMotionNextMode(
          (DirectorUiAnimMode)cfg.uiAnimationMode);
    }
    gStorage.markConfigDirty();
    gStorage.saveAllConfiguration();
    ui.applyAtmosphereSettings(cfg.ambientLedsEnabled, cfg.ambientBrightness,
                               cfg.uiAnimationMode);
    ui.appendLog(String("Atmosphere: LEDs ") +
                 (cfg.ambientLedsEnabled ? "ON" : "OFF") +
                 " bri " + String(cfg.ambientBrightness) +
                 " motion " + directorUiMotionModeName());
    return;
  }

  if (command == "EMERGENCY:STOP") {
    /* Stage safety path unchanged. Director overlay only. */
    Serial.println("[E-Stop] UI EMERGENCY:STOP -> Stage");
    ui.noteEmergencyTriggeredByDirector();
    if (!emergencyLocked) onEmergencyActivatedDirectorUx();
    gStorage.logEmergency("UI", "EMERGENCY:STOP");
  }

  if (command == "EMERGENCY:CLEAR") {
    sendToStage(SHOWDUINO_LEGACY_EMERGENCY_CLEAR);
    ui.appendLog("E-CLEAR request sent to Stage");
    if (linkState != LINK_READY) {
      ui.appendLog("CLEAR requested - Stage offline, awaiting confirmation");
      ui.pushOperatorEvent("Cannot confirm emergency clear - Stage offline");
    }
    return;
  }

  if (command == SHOWDUINO_LEGACY_EMERGENCY_CLEAR_CONFIRM) {
    sendToStage(SHOWDUINO_LEGACY_EMERGENCY_CLEAR_CONFIRM);
    ui.appendLog("E-CLEAR confirm sent to Stage");
    if (linkState != LINK_READY) {
      ui.appendLog("CLEAR requested - Stage offline, awaiting confirmation");
      ui.pushOperatorEvent("Cannot confirm emergency clear - Stage offline");
    }
    return;
  }

  if (command == SHOWDUINO_LEGACY_EMERGENCY_CLEAR_CANCEL) {
    sendToStage(SHOWDUINO_LEGACY_EMERGENCY_CLEAR_CANCEL);
    gDirectorEmergencyClearDialog.hide();
    return;
  }

  backlightNotifyActivity();
  if (command.startsWith("RELAY:")) {
    ui.appendLog("Relay retired — use Lamp Node");
    return;
  }
  if (command.startsWith("AUDIO:") &&
      !command.startsWith("AUDIO:NODE:") &&
      command != "AUDIO:LOCAL:STOP" && command != "AUDIO:STOP" &&
      !command.startsWith("AUDIO:LOCAL:PLAY:") &&
      !command.startsWith("AUDIO:PLAY:")) {
    ui.appendLog("Audio command not supported on Stage");
    return;
  }
  if (command.startsWith("UI:") || command.startsWith("SCREEN:") ||
      command.startsWith("HOME:") || command.startsWith("PAGE02:") ||
      command.startsWith("PAGE04:") || command.startsWith("PAGE05:") ||
      command.startsWith("PAGE06:") || command.startsWith("SETTINGS:") || command == "SELFTEST:START") {
    return;
  }
  sendToStage(command);
}

void markLinkDisconnected(const char *reason) {
  static unsigned long lastLogMs = 0;
  const bool alreadyDown = (linkState == LINK_DISCONNECTED);
  applyLinkState(LINK_DISCONNECTED);
  lastHelloMs = 0;
  lastEspNowRecoverMs = 0;

  // Rate-limit UI spam when the Stage / C3 bridge is offline.
  unsigned long now = millis();
  if (!alreadyDown || !linkLostLogged || (now - lastLogMs) > 30000UL) {
    linkLostLogged = true;
    lastLogMs = now;
    ui.appendLog(String("Stage DISCONNECTED - ") + reason);
  }
}

void readEspNowReplies() {
#if SHOWDUINO_USE_ESPNOW
  if (!espNowReady) return;
  String reply;
  uint8_t n = 0;
  while (n < 32 && espNowTransport.popReply(reply)) {
    handleStageLine(reply);
    n++;
  }
#endif
}

void readStageSerial() {
#if SHOWDUINO_USE_UART_FALLBACK
  while (Serial1.available() > 0) {
    char c = (char)Serial1.read();
    if (c == '\n' || c == '\r') {
      if (stageInputBuffer.length() > 0) {
        handleStageLine(stageInputBuffer);
        stageInputBuffer = "";
      }
    } else {
      stageInputBuffer += c;
      if (stageInputBuffer.length() > 220) {
        stageInputBuffer = "";
        ui.appendLog("Stage response too long; buffer cleared.");
      }
    }
  }
#endif
}

// =========================================================
// USB Serial command bridge for bench testing
// =========================================================
void handleUsbLine(String command) {
  command.trim();
  if (command.length() == 0) return;

  if (command == "HELP") {
    ui.appendLog("USB: HEALTH, HELLO, STATUS:REQUEST, SHOW:*, EMERGENCY:*, TOUCH:STATUS, TOUCH:RESET, TOUCH:CALIBRATE, LOG:LEVEL");
    return;
  }

  if (showduino_log_handle_command(command.c_str())) return;

  if (command == "HEALTH") {
    ui.printHealthDiagnostic();
    return;
  }

  if (command == "TOUCH:STATUS") {
    touchLvglPrintCalibrationStatus();
    return;
  }
  if (command == "TOUCH:RESET") {
    gDirectorTouchCalibrationScreen.hide();
    touchLvglResetCalibration();
    return;
  }
  if (command == "TOUCH:CALIBRATE") {
    directorTouchCalStart();
    return;
  }

  if (command.startsWith("SHOW:RUN:") || command == "SHOW:START" ||
      command == "SHOW:STOP" || command == "SHOW:PAUSE" || command == "SHOW:RESUME" ||
      command == "STOP:ALL" || command == "EMERGENCY:STOP") {
    handleUiCommand(command);
    return;
  }

  sendToStage(command);
}

void drainUsbFrom(Stream &port) {
  while (port.available() > 0) {
    char c = (char)port.read();
    if (c == '\n' || c == '\r') {
      if (usbInputBuffer.length() > 0) {
        handleUsbLine(usbInputBuffer);
        usbInputBuffer = "";
      }
    } else {
      usbInputBuffer += c;
      if (usbInputBuffer.length() > 180) {
        usbInputBuffer = "";
        ui.appendLog("USB command too long; buffer cleared.");
      }
    }
  }
}

void readUsbSerial() {
  drainUsbFrom(Serial);
#if defined(ARDUINO_USB_CDC_ON_BOOT) && ARDUINO_USB_CDC_ON_BOOT
  drainUsbFrom(Serial0);
#endif
}

// =========================================================
// Automatic Stage Engine heartbeat / hello
// =========================================================
void sendHeartbeatIfDue() {
  // Only probe with HEARTBEAT while linked. HELLO owns reconnect.
  if (linkState != LINK_READY) return;

  unsigned long now = millis();
  if (now - lastHeartbeatMs >= HEARTBEAT_INTERVAL_MS) {
    lastHeartbeatMs = now;
    sendToStage("HEARTBEAT");
  }
}

void sendHelloIfNeeded() {
  if (linkState == LINK_READY) return;

  unsigned long now = millis();
  if (now - lastHelloMs >= HELLO_RETRY_INTERVAL_MS) {
    lastHelloMs = now;
    if (linkState == LINK_DISCONNECTED) {
      applyLinkState(LINK_SEARCHING);
    }
    sendToStage("HELLO");
  }
}

void requestLinkRetry() {
  lastHelloMs = 0;
  lastEspNowRecoverMs = 0;
  linkLostLogged = false;
  applyLinkState(LINK_SEARCHING);

#if SHOWDUINO_USE_ESPNOW
  espNowReady = espNowTransport.recover(true);
  Serial.println(espNowReady ? "[Link] retry: ESP-NOW re-init ok" : "[Link] retry: ESP-NOW re-init failed");
#endif

  sendToStage("HELLO");
  if (espNowReady) {
    ui.appendLog("Retrying Stage link (HELLO)...");
  } else {
    ui.appendLog("Retry failed - ESP-NOW not ready");
  }
}

void recoverEspNowIfNeeded() {
#if SHOWDUINO_USE_ESPNOW
  if (linkState == LINK_READY) return;

  unsigned long now = millis();
  if (now - lastEspNowRecoverMs < ESPNOW_RECOVER_MS) return;
  lastEspNowRecoverMs = now;
  if (espNowTransport.recover()) {
    espNowReady = true;
  }
#endif
}

void checkLinkWatchdog() {
  if (linkState != LINK_READY) return;
  if (lastStageReplyMs == 0) return;

  unsigned long now = millis();
  if (now - lastStageReplyMs < LINK_TIMEOUT_MS) return;

  markLinkDisconnected("no heartbeat reply");
}

// =========================================================
// Setup
// =========================================================
void onDirectorBootFinished() {
  ui.onBootPresentationFinished();
}

void setup() {
  /* Kill the panel backlight before anything else so a reset cannot show
   * an uninitialised RGB framebuffer or leftover LVGL chrome. */
  backlightInit(TFT_BL_PIN);

  Serial.begin(USB_DEBUG_BAUD);
#if defined(ARDUINO_USB_CDC_ON_BOOT) && ARDUINO_USB_CDC_ON_BOOT
  /* CDC Serial is the unused USB PHY. Keep UART0 alive on the CH340 COM port. */
  Serial0.begin(USB_DEBUG_BAUD);
#endif
  delay(500);

#if defined(ARDUINO_USB_CDC_ON_BOOT) && ARDUINO_USB_CDC_ON_BOOT
  Serial0.println();
  Serial0.println("Showduino Director: USB CDC On Boot is Enabled.");
  Serial0.println("This panel's USB-C serial is CH340 UART0 (the port that printed ESP-ROM).");
  Serial0.println("Arduino IDE -> USB CDC On Boot = Disabled, then reflash. GPIO19/20 are GT911.");
#endif

  Serial.println();
  Serial.println("Showduino Portable Director 5in - JC8048W550C starting...");

  if (!psramFound() || ESP.getPsramSize() < 700000) {
    Serial.println("FATAL: Enable OPI PSRAM + 16MB Flash + QIO 80MHz");
    while (true) delay(2000);
  }
  Serial.printf("PSRAM: %u bytes free\n", (unsigned)ESP.getFreePsram());

#if SHOWDUINO_USE_ESPNOW
  /* Wi-Fi/ESP-NOW before LVGL: the RGB UI build leaves too little internal heap. */
  Serial.println("ESP-NOW: starting before display/UI...");
  espNowReady = espNowTransport.begin();
  Serial.println(espNowReady ? "ESP-NOW: begin ok" : "ESP-NOW: begin failed");
#endif

  /* SD before RGB: heavy SPI while the panel DMA is running trips Interrupt WDT. */
  Serial.println("SHOWDUINO DIRECTOR");
  Serial.println("Storage: mounting SD before display...");
  bool storageOk = storageBegin(onStorageStatus);
  if (!storageOk) {
    Serial.println("SD CARD NOT AVAILABLE");
    Serial.println("RECOVERY MODE ACTIVE");
  } else {
    Serial.println("Storage ready");
  }

  Serial.println("Display/LVGL: BankOfDad landscape bring-up...");
  if (!lvglPortInit(panel, rgbpanel)) {
    Serial.println("LVGL port init failed - check PSRAM / bounce buffer");
    while (true) delay(1000);
  }

  /* Match BankOfDad: pass gfx logical size after panel begin. */
  touchLvglInit(touchDev, gfx->width(), gfx->height(), DISPLAY_ROTATION);
  Serial.printf("Display %ux%u rotation %d (landscape)\n",
                gfx->width(), gfx->height(), DISPLAY_ROTATION);

  /* SD ran before display - re-reset GT911 so I2C is clean. */
  touchLvglRestoreAfterSd();
  if (!touchLvglReady()) {
    Serial.println("Touch: init failed - check GT911 wiring.");
  }

  if (!storageOk && gfx) {
    /* Keep recovery text off the panel until the boot screen owns the first
     * visible frame. The NO SD page is deferred until boot exits. */
    Serial.println("SD recovery mode - UI after boot screen");
  }

  bootMs = millis();
  ui.setBootTime(bootMs);
  {
    const DirectorConfig &cfg = gStorage.getConfig();
    backlightConfigure(cfg.screenTimeoutMinutes, cfg.brightness);
    directorUiMotionSetMode((DirectorUiAnimMode)cfg.uiAnimationMode);
    directorAmbientSetEnabled(cfg.ambientLedsEnabled);
    directorAmbientSetBrightness(cfg.ambientBrightness);
  }

  gDirectorUnlockScreen.setFinishedHandler(onDirectorBootFinished);
  gDirectorUnlockScreen.begin(bootMs);
  lv_tick_inc(1);
  lvglPortEnableFlush(true);
  lv_timer_handler();
  lastLvglTickMs = millis();
  backlightRevealNow();

  directorAmbientBegin();
  gShowMirror.state = SHOW_STATE_BOOTING;
  directorAmbientHoldPresentation(true);
  directorAmbientSetState(DIRECTOR_AMBIENT_BOOT);

  /* HELLO now so the P4 can queue boot.wav while the boot screen is visible
   * and application UI continues constructing in the background. */
  lastHelloMs = millis();
  sendToStage("HELLO");

  Serial.println("UI: begin (behind boot screen)...");
  ui.begin(handleUiCommand);
  ui.setEspNowReady(espNowReady);
  gDirectorEmergencyClearDialog.setConfirmHandler(onEmergencyClearConfirm);
  gDirectorEmergencyClearDialog.setCancelHandler(onEmergencyClearCancel);
  Serial.println("UI: begin done");
#if SHOWDUINO_OS2_SHELL
  Serial.println("Showduino OS 2.0 Complete");
  Serial.printf("Showduino OS: %s | %s (%s)\n",
                SHOWDUINO_OS2_MILESTONE, SHOWDUINO_OS2_PHASE, SHOWDUINO_OS2_VERSION);
  Os2::boot();
  syncOs2Catalogue();
  publishOs2Services();
#endif

  if (gStorage.isRecoveryMode()) {
    ui.showNoSd();
  }

  {
    const DirectorConfig &cfg = gStorage.getConfig();
    backlightConfigure(cfg.screenTimeoutMinutes, cfg.brightness);
    ui.setScreenTimeoutMinutes(cfg.screenTimeoutMinutes);
    ui.applyAtmosphereSettings(cfg.ambientLedsEnabled, cfg.ambientBrightness,
                               cfg.uiAnimationMode);
  }

  ui.appendLog("Showduino portable Director online.");
  ui.appendLog("Panel: landscape 800x480 (BankOfDad bring-up)");
  if (gStorage.isRecoveryMode()) {
    ui.appendLog("SD CARD NOT AVAILABLE - recovery mode");
    backlightConfigure(10, 255);
    ui.setScreenTimeoutMinutes(10);
  } else {
    const StorageStatus &st = getStorageStatus();
    char line[120];
    snprintf(line, sizeof(line), "SD %s  %lluMB free", st.cardType,
             (unsigned long long)(st.freeBytes / (1024 * 1024)));
    ui.appendLog(line);
    ui.refreshShowLibrary(gStorage.showManager());
    logEvent(LogLevel::Info, LogCategory::System, "Director", "Director ready");
  }

#if SHOWDUINO_USE_ESPNOW
  ui.appendLog(espNowReady ? "ESP-NOW ready: targeting standalone S3 Comms Controller." : "ESP-NOW failed.");
#endif

#if SHOWDUINO_WEBUI_ENABLED
  webServerBegin(bootMs);
  ui.appendLog("WebUI: Studio AP + HTTP server online.");
#endif

#if SHOWDUINO_USE_UART_FALLBACK
  Serial1.begin(STAGE_ENGINE_BAUD, SERIAL_8N1, STAGE_ENGINE_RX_PIN, STAGE_ENGINE_TX_PIN);
  Serial.printf("Service UART fallback: RX=%d TX=%d baud=%d\n", STAGE_ENGINE_RX_PIN, STAGE_ENGINE_TX_PIN, STAGE_ENGINE_BAUD);
#endif

  lastHeartbeatMs = millis();
  lastUiRefreshMs = millis();
  lastLvglTickMs = millis();

  showRuntimeClear(&gShowMirror);
  gShowMirror.state = SHOW_STATE_BOOTING;
  directorAmbientHoldPresentation(true);

  Serial.println("Setup complete. Type HELP in Serial Monitor for bench commands.");
}

void loop() {
  unsigned long now = millis();
  unsigned long elapsed = now - lastLvglTickMs;
  lastLvglTickMs = now;

  lv_tick_inc(elapsed);

  /* While blanked, poll GT911 directly so a tap can wake without LVGL. */
  if (!backlightIsOn()) {
    touchLvglPollActivity();
  }

  ui.setEmergencyLocked(emergencyLocked);
  ui.setEspNowReady(espNowReady);
  gDirectorUnlockScreen.tick(now, espNowReady, linkState, emergencyLocked);
  ui.tickEmergencyOverlay(now);
  gDirectorEmergencyClearDialog.tick(now);
  ui.setTraffic(txCount, rxCount);
  if (now - lastUiRefreshMs >= UI_REFRESH_INTERVAL_MS) {
    lastUiRefreshMs = now;
    ui.updateStatusWidgets(true);
  } else {
    ui.updateStatusWidgets(false);
  }
#if SHOWDUINO_OS2_SHELL
  publishOs2Services();
  drainOs2Commands();
  Os2::tick(now);
#endif
  lvglPortLoop();
#if SHOWDUINO_WEBUI_ENABLED
  webServerLoop();
#endif
  backlightTick(now);
  serviceTimeline();

  readUsbSerial();
  readEspNowReplies();
  readStageSerial();
  recoverEspNowIfNeeded();
#if SHOWDUINO_USE_ESPNOW
  if (espNowReady) espNowTransport.service(linkState == LINK_READY);
#endif
  sendHeartbeatIfDue();
  sendHelloIfNeeded();
  checkLinkWatchdog();
  readEspNowReplies();
  storageLoop();

  directorAmbientSync(linkState, gShowMirror.state, emergencyLocked,
                      (linkState == LINK_READY) || (gShowMirror.stageConnected != 0),
                      ui.isSynchronising(),
                      ui.nodesRequiredMissing());
  directorAmbientLoop(now);

  delay(2);
}
