sumkindafreak/new_showduino/firmware/s3-lamp-node/ShowduinoS3LampNode/src/LampSensors.cpp

#include "LampSensors.h"
#include "LampConfig.h"
#include "../BoardConfig.h"
#include "../../../protocol/showduino_lamp_node.h"

#include <Arduino.h>

static ShowduinoBlowDetector sBlow;
static ShowduinoBlowClass sPending = SHOWDUINO_BLOW_NONE;
static uint32_t sLastMic = 0;
static uint32_t sLastLight = 0;
static uint32_t sLastVolt = 0;
static int32_t sLightRaw = 0;
static int32_t sLightFilt = 0;
static int32_t sVoltRaw = 0;
static int32_t sVoltFilt = 0;
static uint8_t sLightArmed = 0;
static uint8_t sVoltArmed = 0;

static int32_t analogOrNeg(int pin) {
  if (pin < 0) return -1;
  return (int32_t)analogRead(pin);
}

static int32_t iir(int32_t prev, int32_t raw, uint8_t *armed) {
  if (!*armed) {
    *armed = 1;
    return raw;
  }
  return (prev * 3 + raw) / 4;
}

void lampSensorsBegin() {
  ShowduinoBlowConfig cfg = showduino_blow_config_defaults();
  cfg.threshold = lampConfigBlowThreshold();
  cfg.puffMs = lampConfigPuffMs();
  cfg.blowMs = lampConfigBlowMs();
  showduino_blow_reset(&sBlow, &cfg);
  sPending = SHOWDUINO_BLOW_NONE;
  sLightArmed = 0;
  sVoltArmed = 0;
  if (SHOWDUINO_LAMP_MIC_PIN >= 0) pinMode(SHOWDUINO_LAMP_MIC_PIN, INPUT);
  if (SHOWDUINO_LAMP_LIGHT_PIN >= 0) pinMode(SHOWDUINO_LAMP_LIGHT_PIN, INPUT);
  if (SHOWDUINO_LAMP_VOLT_PIN >= 0) {
    pinMode(SHOWDUINO_LAMP_VOLT_PIN, INPUT);
    analogSetPinAttenuation(SHOWDUINO_LAMP_VOLT_PIN, ADC_11db);
  }
  analogReadResolution(12);
}

void lampSensorsService() {
  const uint32_t now = millis();
  if (SHOWDUINO_LAMP_MIC_PIN >= 0 &&
      (now - sLastMic) >= SHOWDUINO_LAMP_SENSOR_MIC_MS) {
    const uint32_t dt = sLastMic ? (now - sLastMic) : SHOWDUINO_LAMP_SENSOR_MIC_MS;
    sLastMic = now;
    const ShowduinoBlowClass ev =
        showduino_blow_feed(&sBlow, analogOrNeg(SHOWDUINO_LAMP_MIC_PIN), dt);
    if (ev != SHOWDUINO_BLOW_NONE) sPending = ev;
  }
  if (SHOWDUINO_LAMP_LIGHT_PIN >= 0 &&
      (now - sLastLight) >= SHOWDUINO_LAMP_SENSOR_LIGHT_MS) {
    sLastLight = now;
    sLightRaw = analogOrNeg(SHOWDUINO_LAMP_LIGHT_PIN);
    sLightFilt = iir(sLightFilt, sLightRaw, &sLightArmed);
  }
  if (SHOWDUINO_LAMP_VOLT_PIN >= 0 &&
      (now - sLastVolt) >= SHOWDUINO_LAMP_SENSOR_VOLT_MS) {
    sLastVolt = now;
    sVoltRaw = analogOrNeg(SHOWDUINO_LAMP_VOLT_PIN);
    sVoltFilt = iir(sVoltFilt, sVoltRaw, &sVoltArmed);
  }
}

const ShowduinoBlowDetector *lampSensorsBlow() { return &sBlow; }

ShowduinoBlowClass lampSensorsTakeBlowEvent() {
  const ShowduinoBlowClass ev = sPending;
  sPending = SHOWDUINO_BLOW_NONE;
  return ev;
}

int32_t lampSensorsMicRaw() { return sBlow.raw; }
int32_t lampSensorsMicFiltered() { return sBlow.filtered; }
int32_t lampSensorsMicBaseline() { return sBlow.baseline; }
int32_t lampSensorsLightRaw() { return sLightRaw; }
int32_t lampSensorsLightFiltered() { return sLightFilt; }
int32_t lampSensorsVoltRaw() { return sVoltRaw; }
int32_t lampSensorsVoltFiltered() { return sVoltFilt; }

int32_t lampSensorsVoltMv() {
  return showduino_lamp_volt_mv(sVoltFilt, lampConfigVoltScaleNum(),
                                lampConfigVoltScaleDen());
}

bool lampSensorsCalibrateVoltFullScale() {
  const int32_t v = sVoltFilt > 0 ? sVoltFilt : sVoltRaw;
  if (v <= 0) return false;
  lampConfigSetVoltScale(SHOWDUINO_LAMP_VOLT_FS_MV, (uint32_t)v);
  return true;
}

const char *lampSensorsMicStatus() {
  return SHOWDUINO_LAMP_MIC_PIN < 0 ? "UNCONFIRMED" : "OK";
}

void lampSensorsApplyConfig() {
  ShowduinoBlowConfig cfg = showduino_blow_config_defaults();
  cfg.threshold = lampConfigBlowThreshold();
  cfg.puffMs = lampConfigPuffMs();
  cfg.blowMs = lampConfigBlowMs();
  showduino_blow_reset(&sBlow, &cfg);
  sPending = SHOWDUINO_BLOW_NONE;
}

void lampSensorsCalibrateQuiet() {
  lampSensorsApplyConfig();
}

void lampSensorsCalibrateLight() {
  const int32_t v = sLightFilt > 0 ? sLightFilt : sLightRaw;
  if (v > 0) lampConfigSetLightScale((uint32_t)v);
}

int32_t lampSensorsLightNormalized() {
  return showduino_lamp_light_normalized(sLightFilt, lampConfigLightScale());
}

const char *lampSensorsLightStatus() {
  if (SHOWDUINO_LAMP_LIGHT_PIN < 0) return "UNCONFIRMED";
  if (lampConfigLightScale() == 0) return "UNCALIBRATED";
  return "CALIBRATED";
}

const char *lampSensorsVoltStatus() {
  if (SHOWDUINO_LAMP_VOLT_PIN < 0) return "UNCONFIRMED";
  const uint32_t num = lampConfigVoltScaleNum();
  const uint32_t den = lampConfigVoltScaleDen();
  if (num == 0 || den == 0) return "UNCALIBRATED";
  if (showduino_lamp_volt_is_default_fs(num, den)) return "5V_FULL_SCALE";
  return "CALIBRATED";
}

const char *lampSensorsVoltWarn() {
  const int32_t mv = lampSensorsVoltMv();
  if (mv < 0) return "-";
  const uint32_t under = lampConfigVoltUnderMv();
  const uint32_t warn = lampConfigVoltWarnMv();
  if (under && (uint32_t)mv <= under) return "UNDERVOLTAGE";
  if (warn && (uint32_t)mv <= warn) return "WARNING";
  return "OK";
}
