sumkindafreak/new_showduino/firmware/director-esp32-8048s050/ShowduinoDirector8048S050/BoardConfig.h

#ifndef SHOWDUINO_BOARD_CONFIG_H
#define SHOWDUINO_BOARD_CONFIG_H

#include <Arduino.h>
#include "../../../protocol/showduino_log.h"
#include "../../../protocol/showduino_version.h"

// =========================================================
// Showduino Director - Sunton ESP32-S3 RGB panel config
// Same RGB pin map for ESP32-8048S043 and ESP32-8048S050 (800x480 ST7262)
// =========================================================

// Touch: capacitive GT911 first. Keep XPT2046 off unless you have the resistive (R) panel -
// its CS pin is GPIO38, same as GT911 RST, and probing it can kill capacitive touch.
#define SHOWDUINO_TOUCH_GT911    1
#define SHOWDUINO_TOUCH_XPT2046  0

// USB debug serial - JC8048W550C USB-C is CH340 -> UART0 (GPIO43 TX / GPIO44 RX).
// Native USB CDC uses GPIO19/20, which are GT911 SDA/SCL on this panel.
// Arduino IDE: USB CDC On Boot = Disabled so Serial is this UART, not the USB PHY.
#define USB_DEBUG_BAUD 115200
#if defined(ARDUINO_USB_CDC_ON_BOOT) && ARDUINO_USB_CDC_ON_BOOT
#warning "Showduino Director: USB CDC On Boot is Enabled. Set it Disabled - Serial debug is the CH340 UART; GPIO19/20 are GT911."
#endif

// Screen size
#define SCREEN_WIDTH  800
#define SCREEN_HEIGHT 480

// Showduino OS 2.0 Operator Workspace (LVGL shell - no BMP chrome).
// 0 = legacy page UI (ShowduinoUi). 1 = OS 2.0 shell (apps + services + theme).
#ifndef SHOWDUINO_OS2_SHELL
#define SHOWDUINO_OS2_SHELL 0
#endif

// Backlight
#define TFT_BL_PIN 2
#define TFT_BL_ON  HIGH
#define TFT_BL_OFF LOW

// RGB display timing for ST7262 IPS LCD 800x480
#define RGB_DE_PIN    40
#define RGB_VSYNC_PIN 41
#define RGB_HSYNC_PIN 39
#define RGB_PCLK_PIN  42

#define RGB_R0_PIN 45
#define RGB_R1_PIN 48
#define RGB_R2_PIN 47
#define RGB_R3_PIN 21
#define RGB_R4_PIN 14

#define RGB_G0_PIN 5
#define RGB_G1_PIN 6
#define RGB_G2_PIN 7
#define RGB_G3_PIN 15
#define RGB_G4_PIN 16
#define RGB_G5_PIN 4

#define RGB_B0_PIN 8
#define RGB_B1_PIN 3
#define RGB_B2_PIN 46
#define RGB_B3_PIN 9
#define RGB_B4_PIN 1

#define RGB_HSYNC_POLARITY 0
#define RGB_HSYNC_FRONT    8
#define RGB_HSYNC_PULSE    4
#define RGB_HSYNC_BACK     8
#define RGB_VSYNC_POLARITY 0
#define RGB_VSYNC_FRONT    8
#define RGB_VSYNC_PULSE    4
#define RGB_VSYNC_BACK     8
#define RGB_PCLK_ACTIVE_NEG 1
#define RGB_PREFER_SPEED   16000000

// GT911 capacitive touch (JC8048W550C / 8048S050C) - BankOfDad pin map
#define TOUCH_SDA_PIN 19
#define TOUCH_SCL_PIN 20
#define TOUCH_INT_PIN 18
#define TOUCH_RST_PIN 38
/*
 * TAMC_GT911::setRotation() uses library enums, NOT DISPLAY_ROTATION:
 *   0=LEFT, 1=INVERTED, 2=RIGHT, 3=NORMAL
 * Landscape desk uses 3 / NORMAL (matches ShowduinoSdTouchTest).
 * BankOfDad portrait uses 1 / INVERTED + a manual 90° remap in its touch_lvgl.
 */
#define TOUCH_GT911_LIB_ROTATION 3

// XPT2046 resistive (legacy R panels) - not used with new capacitive bring-up
#define TOUCH_XPT_CS_PIN   38
#define TOUCH_XPT_IRQ_PIN  18
#define TOUCH_XPT_MOSI_PIN 11
#define TOUCH_XPT_MISO_PIN 13
#define TOUCH_XPT_SCK_PIN  12
#define TOUCH_XPT_ROTATION 1
#define TOUCH_XPT_RAW_MIN  200
#define TOUCH_XPT_RAW_MAX  3900

// SD card SPI from the SDK
#define SD_CS_PIN   10
#define SD_MOSI_PIN 11
#define SD_MISO_PIN 13
#define SD_SCK_PIN  12

// Director JC8048W550C - NOT the P4 local show audio path.
// These SDK I2S pins conflict with Stage UART (17/18) and are deferred.
// Authoritative single local audio output lives on ESP32-P4 / IAN
// (see firmware/stage-engine-p4/.../BoardConfig.h - P4_AUDIO_I2S_*).
#define I2S_DOUT_PIN 17
#define I2S_BCLK_PIN 0
#define I2S_LRC_PIN  18

// =========================================================
// Ambient NeoPixel state LEDs (desk mood / status)
// GPIO17 is free while I2S + Stage UART fallback stay deferred.
// GPIO18 is GT911 INT - never use for pixels.
// Two pixels on one data line (DIN -> GPIO17).
// =========================================================
#ifndef SHOWDUINO_DIRECTOR_AMBIENT_PIXEL_ENABLED
#define SHOWDUINO_DIRECTOR_AMBIENT_PIXEL_ENABLED 1
#endif
#define SHOWDUINO_DIRECTOR_AMBIENT_PIXEL_PIN        17
#define SHOWDUINO_DIRECTOR_AMBIENT_PIXEL_COUNT      2
#define SHOWDUINO_DIRECTOR_AMBIENT_PIXEL_BRIGHTNESS 255
#define SHOWDUINO_DIRECTOR_AMBIENT_FRAME_MS         40
#ifndef SHOWDUINO_ESTOP_CLEAR_REQUEST_TIMEOUT_MS
#define SHOWDUINO_ESTOP_CLEAR_REQUEST_TIMEOUT_MS    12000UL
#endif

// =========================================================
// Portable controller transport
// =========================================================
#define SHOWDUINO_USE_ESPNOW 1
// MUST stay off. This touchscreen Director has no P4 UART.
// Product path is wireless ESP-NOW to a separate standalone S3 Comms Controller.
#define SHOWDUINO_USE_UART_FALLBACK 0
#define SHOWDUINO_ESPNOW_CHANNEL 1
/* Magic / wire version / command max: protocol/showduino_protocol_version.h */
#include "../../../protocol/showduino_protocol_version.h"

// ESP-NOW MAC of the SEPARATE standalone ESP32-S3 Comms Controller
// (firmware/s3-comms-controller/). This panel is the Director, not that board.
// Bench board USB boot: 20:6E:F1:98:B5:38
#define SHOWDUINO_COMMS_MAC_0 0x20
#define SHOWDUINO_COMMS_MAC_1 0x6E
#define SHOWDUINO_COMMS_MAC_2 0xF1
#define SHOWDUINO_COMMS_MAC_3 0x98
#define SHOWDUINO_COMMS_MAC_4 0xB5
#define SHOWDUINO_COMMS_MAC_5 0x38

/* Historical alias only. This is the dedicated Communications S3 MAC.
 * It does NOT address the unused/reserved onboard ESP32-C6. */
#ifndef SHOWDUINO_P4_C6_MAC_0
#define SHOWDUINO_P4_C6_MAC_0 SHOWDUINO_COMMS_MAC_0
#define SHOWDUINO_P4_C6_MAC_1 SHOWDUINO_COMMS_MAC_1
#define SHOWDUINO_P4_C6_MAC_2 SHOWDUINO_COMMS_MAC_2
#define SHOWDUINO_P4_C6_MAC_3 SHOWDUINO_COMMS_MAC_3
#define SHOWDUINO_P4_C6_MAC_4 SHOWDUINO_COMMS_MAC_4
#define SHOWDUINO_P4_C6_MAC_5 SHOWDUINO_COMMS_MAC_5
#endif

// Historical optional Director↔P4 UART fallback. KEEP OFF.
// These are NOT the standalone Comms Controller UART pins.
// On this panel GPIO17 is ambient NeoPixels and GPIO18 is GT911 INT.
#define STAGE_ENGINE_BAUD   115200
#define STAGE_ENGINE_RX_PIN 18
#define STAGE_ENGINE_TX_PIN 17

#define LVGL_BUFFER_LINES       40
#define HEARTBEAT_INTERVAL_MS   2000UL
#define HELLO_RETRY_INTERVAL_MS  2000UL
#define UI_REFRESH_INTERVAL_MS  1000UL
// Sustained silence before DISCONNECTED. UART/ESP-NOW can burst with
// node telemetry, so this must outlast a short congestion gap.
#define LINK_TIMEOUT_MS         15000UL
/*
 * Temporary Director-side baseline: no production Nodes are required.
 * The supported stack is Director -> Communications S3 -> P4 Show Engine.
 * Relay / Audio / MOSFET / LED / DMX Nodes remain future hardware.
 * Do not invent a Node to satisfy health. Future expected-node counts
 * should come from the P4, not this compile-time constant.
 */
#define SHOWDUINO_EXPECTED_NODES  0
#define ESPNOW_RECOVER_MS       5000UL

enum ShowduinoLinkState : uint8_t {
  LINK_SEARCHING = 0,
  LINK_READY = 1,
  LINK_DISCONNECTED = 2
};

// =========================================================
// Stage 4 WebUI - Director is no longer the browser host.
// Canonical SoftAP / PROGMEM UI lives on the Communications S3.
// Keep these gated stubs so a local bench re-enable still compiles.
// =========================================================
#define SHOWDUINO_WEBUI_ENABLED 0
#define SHOWDUINO_WEBUI_AP_SSID "Showduino-Studio"
#define SHOWDUINO_WEBUI_AP_PASSWORD "showduino"
#define SHOWDUINO_WEBUI_MDNS "showduino-studio"
#define SHOWDUINO_BOARD_NAME "ESP32-8048S050"

#endif
