sumkindafreak/new_showduino/firmware/director-esp32-8048s050/ShowduinoDirector8048S050/TouchDriver.h

#ifndef SHOWDUINO_TOUCH_DRIVER_H
#define SHOWDUINO_TOUCH_DRIVER_H

/*
 * LEGACY - Director now uses touch_lvgl.h (BankOfDad GT911 pattern, landscape).
 * Do not include this from the active Director sketch.
 */

#error "Use touch_lvgl.h instead of TouchDriver.h for the active Director"

#endif
