sumkindafreak/new_showduino/firmware/director-esp32-8048s050/ShowduinoDirector8048S050/backlight.cpp

#include "backlight.h"

enum BlState : uint8_t {
  BL_STATE_FULL = 0,
  BL_STATE_DIM,
  BL_STATE_OFF
};

static uint8_t  s_pin = 255;
static uint16_t s_pwmFull = BL_PWM_MAX;
static uint16_t s_pwmDim = BL_PWM_DIM_FLOOR;
static uint16_t s_pwm = 0;
static BlState  s_state = BL_STATE_OFF;
static uint32_t s_lastActive = 0;
static uint32_t s_wakeUntil = 0;
static uint8_t  s_timeoutMin = 10;
static uint8_t  s_brightness = 255;
static bool     s_autoEnabled = true;
static bool     s_heldOff = true;
static bool     s_locateHold = false;
static bool     s_calHold = false;
#if ESP_ARDUINO_VERSION < ESP_ARDUINO_VERSION_VAL(3, 0, 0)
static uint8_t  s_ledcCh = 0;
#endif

static uint16_t brightnessToPwm(uint8_t b) {
  if (b >= 255) return BL_PWM_MAX;
  return (uint16_t)(((uint32_t)b * BL_PWM_MAX) / 255U);
}

static void applyPwm(uint16_t duty) {
  if (s_pin == 255) return;
  if (duty > BL_PWM_MAX) duty = BL_PWM_MAX;
  s_pwm = duty;
#if ESP_ARDUINO_VERSION >= ESP_ARDUINO_VERSION_VAL(3, 0, 0)
  ledcWrite(s_pin, duty);
#else
  ledcWrite(s_ledcCh, duty);
#endif
}

static void setState(BlState st) {
  if (s_heldOff) {
    applyPwm(0);
    s_state = BL_STATE_OFF;
    return;
  }
  if (s_state == st) {
    if (st == BL_STATE_FULL) applyPwm(s_pwmFull);
    return;
  }
  s_state = st;
  switch (st) {
    case BL_STATE_FULL: applyPwm(s_pwmFull); break;
    case BL_STATE_DIM:  applyPwm(s_pwmDim);  break;
    case BL_STATE_OFF:  applyPwm(0);         break;
  }
}

void backlightInit(uint8_t pin) {
  s_pin = pin;
  pinMode(s_pin, OUTPUT);
  digitalWrite(s_pin, LOW);
#if ESP_ARDUINO_VERSION >= ESP_ARDUINO_VERSION_VAL(3, 0, 0)
  ledcAttach(s_pin, 1000, 10);
  ledcWrite(s_pin, 0);
#else
  s_ledcCh = 0;
  ledcSetup(s_ledcCh, 1000, 10);
  ledcAttachPin(s_pin, s_ledcCh);
  ledcWrite(s_ledcCh, 0);
#endif
  s_heldOff = true;
  s_state = BL_STATE_OFF;
  s_pwm = 0;
  s_lastActive = millis();
  Serial.printf("Backlight: HELD OFF until first boot frame (pin=%u)\n", (unsigned)s_pin);
}

void backlightConfigure(uint8_t timeoutMinutes, uint8_t brightness255) {
  s_timeoutMin = timeoutMinutes;
  s_brightness = brightness255 ? brightness255 : 1;
  s_autoEnabled = (timeoutMinutes > 0);
  s_pwmFull = brightnessToPwm(s_brightness);
  s_pwmDim = (uint16_t)(s_pwmFull / 6U);
  if (s_pwmDim < BL_PWM_DIM_FLOOR && s_pwmFull > BL_PWM_DIM_FLOOR) {
    s_pwmDim = BL_PWM_DIM_FLOOR;
  }
  if (s_pwmDim >= s_pwmFull) {
    s_pwmDim = (s_pwmFull > 1) ? (s_pwmFull / 2) : 1;
  }

  if (!s_heldOff) {
    if (!s_autoEnabled) {
      setState(BL_STATE_FULL);
    } else if (s_state == BL_STATE_FULL) {
      applyPwm(s_pwmFull);
    }
  }

  Serial.printf("Backlight: timeout=%umin brightness=%u auto=%s hold=%s\n",
                (unsigned)s_timeoutMin, (unsigned)s_brightness,
                s_autoEnabled ? "on" : "off",
                s_heldOff ? "yes" : "no");
}

bool backlightIsHeldOff() {
  return s_heldOff;
}

void backlightRevealNow() {
  if (s_pin == 255) return;
  s_heldOff = false;
  uint32_t now = millis();
  s_lastActive = now;
  s_wakeUntil = now + BL_WAKE_LATCH_MS;
  applyPwm(s_pwmFull);
  s_state = BL_STATE_FULL;
  Serial.printf("Backlight: REVEAL immediate pwm=%u\n", (unsigned)s_pwmFull);
}

void backlightNotifyActivity() {
  if (s_heldOff) return;
  uint32_t now = millis();
  if (s_state == BL_STATE_OFF || s_state == BL_STATE_DIM) {
    s_wakeUntil = now + BL_WAKE_LATCH_MS;
  }
  s_lastActive = now;
  setState(BL_STATE_FULL);
}

bool backlightIsOn() {
  return !s_heldOff && s_state != BL_STATE_OFF;
}

bool backlightAutoEnabled() {
  return s_autoEnabled;
}

uint8_t backlightTimeoutMinutes() {
  return s_timeoutMin;
}

uint8_t backlightBrightness() {
  return s_brightness;
}

const char *backlightStatusText() {
  if (s_heldOff) return "Backlight held for boot";
  if (!s_autoEnabled) return "Backlight always on";
  switch (s_state) {
    case BL_STATE_DIM: return "Backlight dim";
    case BL_STATE_OFF: return "Backlight off";
    default:           return "Backlight on";
  }
}

void backlightSet(bool on) {
  if (s_heldOff) return;
  if (on) backlightNotifyActivity();
  else setState(BL_STATE_OFF);
}

void backlightLocateHold(bool hold) {
  if (s_locateHold == hold) return;
  s_locateHold = hold;
  if (hold) {
    s_heldOff = false;
    setState(BL_STATE_FULL);
    Serial.println("[LOCATOR] Auto-off suspended");
  } else {
    Serial.println("[LOCATOR] Auto-off restored");
    backlightNotifyActivity();
  }
}

bool backlightLocateHeld() {
  return s_locateHold;
}

void backlightCalHold(bool hold) {
  if (s_calHold == hold) return;
  s_calHold = hold;
  if (hold) {
    s_heldOff = false;
    setState(BL_STATE_FULL);
    Serial.println("[TouchCal] Auto-off suspended");
  } else {
    Serial.println("[TouchCal] Auto-off restored");
    backlightNotifyActivity();
  }
}

bool backlightCalHeld() {
  return s_calHold;
}

void backlightTick(uint32_t nowMs) {
  if (s_pin == 255) return;
  if (s_heldOff) {
    applyPwm(0);
    return;
  }
  if (s_locateHold || s_calHold) {
    if (s_state != BL_STATE_FULL) setState(BL_STATE_FULL);
    return;
  }
  if (!s_autoEnabled) {
    if (s_state != BL_STATE_FULL) setState(BL_STATE_FULL);
    return;
  }

  if (nowMs < s_wakeUntil) {
    setState(BL_STATE_FULL);
    return;
  }

  const uint32_t offMs = (uint32_t)s_timeoutMin * 60000UL;
  uint32_t dimMs = offMs / 2UL;
  if (dimMs < 30000UL) dimMs = 30000UL;
  if (dimMs >= offMs) dimMs = (offMs > 1000UL) ? (offMs - 1000UL) : 0;

  uint32_t idle = nowMs - s_lastActive;
  if (idle >= offMs) {
    setState(BL_STATE_OFF);
  } else if (idle >= dimMs) {
    setState(BL_STATE_DIM);
  } else {
    setState(BL_STATE_FULL);
  }
}
