sumkindafreak/new_showduino/(commit log)

2026-07-03 Add SUE ESP32-S3 node firmware plan
2026-07-03 Lock CYD Director and Mega Stage Engine architecture
2026-07-07 Update architecture to ESP32-S3 Director and ESP32-P4 Stage Engine
2026-07-07 Add ESP32-P4 Stage Engine command parser scaffold
2026-07-07 Add ESP32-S3 Director UART bridge scaffold
2026-07-07 Add ESP-NOW relay node architecture
2026-07-07 Add ESP-NOW relay node starter firmware
2026-07-07 Update README for S3 Director, P4 Stage Engine and ESP-NOW architecture
2026-07-09 Add ESP32-8048S050 board config
2026-07-09 Add GT911 touch driver wrapper
2026-07-09 Add ESP32-8048S050 Showduino Director firmware
2026-07-09 Document ESP32-8048S050 Director firmware
2026-07-09 Update board config for portable ESP-NOW control
2026-07-12 Merge Showduino OS Stage Engine foundation
    * Add P4 LED proof-of-life firmware
    * Add touchscreen LED proof button to Director UI
    * Document Showduino OS platform architecture
    * Add shared Showduino OS protocol v1 header
    * Document parallel Director and Stage Engine workflow
    * Add ESP-IDF Stage Engine project root
    * Add Stage Engine main component
    * Add Stage Engine runtime state interface
    * Implement Stage Engine runtime state
    * Add GPIO service interface
    * Implement GPIO proof service
    * Add Stage Engine command router interface
    * Implement Stage Engine command router
    * Add ESP32-P4 Stage Engine entrypoint
    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
2026-07-18 Sync Stage 0-3 architecture, shared protocol, and Director landscape bring-up.
    Add constitution/status docs, protocol package with authoritative STATE/snapshot wire, C3 bridge and Show Engine state model, and JC8048W550C display/touch port (BankOfDad pattern, landscape).
2026-07-18 Fix Director boot IWDT, landscape touch, and settings-controlled auto backlight.
    Mount SD before RGB, use correct GT911 rotation/calibration, and add BankOfDad-style idle dim/off with Settings timeout presets.
    [BoardConfig.h, ShowduinoDirector8048S050.ino, ShowduinoUi.h, StorageAPI.h, StorageRecovery.h, backlight.cpp, backlight.h, touch_lvgl.cpp]
2026-07-23 Add Showduino OS UI, C3 studio stack, and Director live monitoring.
    Bring local Stage 5–7.9 work onto main: Director design system and status bar, C3 Command Bus/TimeService/Device Manager, Showduino Studio web UI, and Stage Engine runtime owners — without changing ESP-NOW packet layouts.
2026-07-23 Fix ESP-NOW peer/home channel mismatch after SoftAP.
    Lock fabric channel 1 after WebUI SoftAP, register peers with channel 0, and recover on ESP_ERR_ESPNOW_CHAN so TIME/heartbeat sends stop failing.
    [EspNowTransport.h, ShowduinoC3SuperMiniBridge.ino, ShowduinoRelayNodeEsp32.ino, WebServerManager.cpp]
2026-07-23 Bring up Director ESP-NOW before LVGL so Wi-Fi has enough DRAM.
    UI was leaving ~42KB heap; wifi_init failed (channel 0, MAC 00:00:00:00:00:00) and every send hit ESP_ERR_ESPNOW_CHAN. Early radio init plus stricter bring-up/recover fixes it.
    [EspNowTransport.h, ShowduinoDirector8048S050.ino]
2026-07-23 Stamp Director ESP-NOW early-wifi-v2 and init NVS before Wi-Fi.
    Makes it obvious whether the flashed binary includes early radio bring-up, and avoids wifi_init failing when NVS was never opened.
    [EspNowTransport.h]
2026-08-07 Build Show Editor, runtime controls, and hybrid networking
    Adds the DAW-style Show Editor, connects Web Studio Show/Emergency commands to the existing P4 Stage Runtime vocabulary, and adds persistent recovery-safe hybrid AP/LAN provisioning on SUE while preserving the ESP-NOW channel constraint.
2026-08-22 Sync local Showduino workspace to GitHub.
    Bring Director, Stage, and SUE current, including the LVGL-only Director UI and emergency latch work.
2026-08-22 Fix Stage/Director show-path defects so the two-cue proof can run safely.
    Empty timelines cannot load or run, Director verifies cue-count ACKs, and emergency CLEAR stays Stage-authoritative.
    [EspNowTransport.h, ShowRuntimeOwner.h, ShowduinoDirector8048S050.ino, ShowduinoStageEngineP4.ino]
2026-08-24 Reconnect WebUI command path to current SUE UART bridge
2026-08-24 Restore Stage Runtime command interface for Web Studio
2026-08-24 Restore SUE Stage Runtime bridge for WebUI controls
2026-08-24 Reconnect Web command manager to Stage Runtime bridge
2026-08-24 Enable live Stage Runtime dispatch for Web Studio commands
2026-08-24 Fix Director control honesty and P4 SUE-boot UART flood, and add the Time Machine demo package.
    Director no longer offers unsupported hardware actions and uses the CH340 UART for serial. The Stage Engine ignores C3 ROM banners instead of replying ERR:UNKNOWN_COMMAND. TIME MACHINE — DEMO ONE is staged for the Director SD card.
    [BoardConfig.h, DisplayPages.h, EspNowTransport.h, ShowduinoDirector8048S050.ino, ShowduinoStageEngineP4.ino, ShowduinoUi.h, page_01_home.cpp, page_01_home.h]
2026-08-25 Adopt lean P4 hardware baseline with onboard C6 RTC and system audio
    Update Showduino architecture, pin/resource map, migration/status docs and component READMEs for the 2026-08-25 Stage Controller simplification. Keep the external C3/DS3231 stack as compatibility code while onboard C6, P4 RTC and ES8311 integration are qualified. Correct the Stage Controller SD documentation to SDMMC and reserve the onboard audio resources without changing runtime behaviour.
    [BoardConfig.h]
2026-08-25 Add no-risk onboard C6 hosted-link qualification
    Add an ESP-IDF P4 smoke test that preserves the Waveshare factory C6 firmware, qualifies the internal SDIO link, reads the C6 STA MAC and performs a Wi-Fi scan. Document the confirmed P4/C6 SDIO pin map, the GPIO17/18 conflict with the old external-C3 UART, the GPIO10 onboard-audio conflict, and the current ESP-Hosted ESP-NOW limitation before production migration.
2026-08-25 Make Arduino IDE the primary P4/C6 qualification workflow
2026-08-25 Add Arduino IDE onboard C6 qualification sketch
    Add a compile-and-go Arduino P4 sketch that configures the Waveshare onboard C6 SDIO pins through WiFi.setPins, starts hosted Wi-Fi, reads the C6 STA MAC and performs a network scan without modifying C6 firmware. Document Arduino IDE as the normal Showduino qualification path and retain the ESP-IDF project only as a low-level reference.
2026-08-27 Adopt the dedicated ESP32-S3 Comms Controller and P4 plugin bus as the current Showduino path.
    Replace the C3 SuperMini as the live Communications Engine, keep onboard C6 unused/reserved, and add I2C plugin discovery plus matching firmware, overlay, and architecture docs.
    [BoardConfig.h, CommsConsole.cpp, CommsUart.cpp, CommsUart.h, EmergencyPixels.cpp, EmergencyPixels.h, EspNowTransport.cpp]
2026-09-07 Wire segmented P4 pixel engine into runtime and emergency policy
2026-09-07 Mark relay node prototype superseded by MOSFET node plan
2026-09-07 Record current Showduino node rollout order
2026-09-07 Add planned MOSFET Node placeholder
2026-09-07 Sync repository status with pixel engine and current node roadmap
2026-09-07 Refocus Scene Creator on segmented pixels and current Audio Node
2026-09-07 Align Director README with current WebUI and node roadmap
2026-09-09 Add safe Studio RAM timeline deployment endpoint
    * Add safe Studio RAM timeline upload policy
    * Test safe Studio timeline upload policy
    * Run Studio timeline upload policy tests
    * Run web timeline policy test on Windows
    * Preserve current Web API implementation as wrapper base
    * Share Studio timeline upload policy across P4 and S3
    * Test shared timeline upload policy header
    * Add narrow Studio timeline deployment endpoint
    * Preserve current S3 Web server as wrapper base
    * Proxy narrow Studio timeline endpoint through Comms S3
    * Remove duplicate P4-local timeline upload policy
    * Use file-relative shared policy include on P4
2026-09-09 Ignore local arduino-cli _build trees.
    These compile copies must not enter the repository.
2026-09-09 Add shared log, ownership, and Lamp Node protocol.
    Keep colon-text wire compatibility while specialist nodes gain GRANT/standalone rules and a common Serial log API.
2026-09-09 Keep the P4 Show Engine current: Lamp link, quieter heartbeats, FW 0.5.0.
    Heartbeat no longer republishes full Audio Node state. LampNodeLink and emergency hooks stay on the P4, which remains able to run a loaded show without Director or WebUI.
    [BoardConfig.h, ShowPixels.h, ShowduinoStageEngineP4.ino]
2026-09-09 Quiet Comms S3 transport logs and keep Director/P4/Audio presence reporting.
    ESP-NOW and UART remain transport only. This does not restore C3/SUE or onboard C6 comms.
2026-09-09 Harden Director ESP-NOW link timeout and restyle operator pages.
    The desk remains a client: longer Stage timeout, deeper RX queue, and Audio/Lamp-aware UI without taking show authority.
2026-09-09 Document the live P4/S3/Director stack and standalone node ownership.
    Label C3/SUE and onboard-C6 comms as superseded or reserved so they cannot be mistaken for the current path.
2026-09-09 Fold Lamp Node into the P4 Web API and keep Studio RAM timeline Arduino-buildable.
    Rename the GitHub .inc wrappers to headers so arduino-cli can find them, expose lamp status in /api/system and /api/devices, and reject SHOW:START from emergency runtime state as well as the legacy latch.
2026-09-09 Show Audio and Lamp Node status in the S3 system console.
    Keep the pinned Studio V4 /studio/ snapshot and regenerate the PROGMEM commissioning bundle from the current web/showduino-studio source.
2026-09-09 Document the reconciled stack: SHDO v2 contract, P4 format v1, S3 console.
    Label C3/SUE, onboard C6, GoreFX and the old steps[] show file as legacy or reserved so they cannot be read as current architecture.
2026-09-09 Fix Director boot draw order and keep ESP-NOW non-blocking during UI animation.
    Keep the LCD dark until a complete boot screen is flushed, then reveal immediately. Ambient LEDs own the theatrical fade. Comms peer add uses the live AP interface so Audio Node join is less likely to drop the Director.
    [AudioCommand.cpp, AudioWeb.cpp, BoardConfig.h, ConfigManager.h, DirectorAmbientPixels.cpp, DirectorAmbientPixels.h, DirectorStatusBar.h, DirectorUiMotion.h]
2026-09-11 Teach the P4 GPIO23 line and PixelNodeLink about remote LED nodes.
    Keep local COUNT/INIT semantics, leave GPIO24 untouched, and route PIXEL:NODE commands so a missing node cannot stall the timeline.
    [BoardConfig.h, ShowPixels.cpp, ShowPixels.h, ShowduinoStageEngineP4.ino, StageConfig.cpp, StageConfig.h]
2026-09-11 Show Pixel Nodes on the Director Nodes screen and home footer.
    Parse STATE:NODE:PIXEL wires, count online remotes, and keep the existing six-card visual language.
2026-09-11 Stop the Director freezing on the READY boot splash.
    Swap straight to Home instead of fading and deleting the boot screen while LVGL still reports it as active.
    [DirectorUiMotion.h, DirectorUnlockScreen.cpp, DirectorUnlockScreen.h, ShowduinoUi.h, StorageConfig.h, page_01_home.cpp]
2026-09-11 Add the first Audio Node Hello World SHDO production.
    Give Showduino a real audio-only example that the current compiler must keep valid.
2026-09-11 Regenerate the S3 Studio V4 embed from current overlay and website main.
    Keep the physical Comms /studio/ path on the latest authoritative Studio instead of the previous bundle.
2026-09-12 Move the Lamp Node onto the physical ESP32-S3 carbide lamp.
    The opened hardware is an S3 practical, not a C3 pixel node, so the new firmware keeps GPIOs unconfirmed until Toby traces the jewel, sensors, and Fermion UART.
2026-09-12 Confirm the S3 Lamp Node production GPIO map.
    Jewel, striker, sensors, and Fermion UART are now the physical 2026-09-12 wiring, with ADC1-only analog inputs.
2026-09-12 Use UART0 on the CH343 Lamp Node and echo Fermion replies.
    The physical S3 talks through a CH343 USB-UART, so CDC-on-boot hid the application console. Print Fermion RX so first-flash commissioning can see whether the DFPlayer answers.
2026-09-12 Make the Lamp Jewel a living carbide flame.
    The physical lamp now blacks out at boot, then renders flint, catch, burn, puff and extinguish locally so a striker press, motion IGNITE and P4 IGNITE share the same non-blocking experience.
    [BoardConfig.h, LampAudio.cpp, LampAudio.h, LampConfig.cpp, LampConfig.h, LampEngine.cpp, LampEngine.h, LampMotion.cpp]
2026-09-13 Add Protocol 1.0 Emergency Node assert-only wire.
2026-09-13 Latch wireless Emergency Node asserts on P4 and Comms.
2026-09-15 Studio embed: include current UX layers
2026-09-16 docs: add commercial manual source traceability matrix
2026-09-16 Latch Emergency on press, Locate on an 8s hold, and persist Director touch calibration.
    The physical button never clears Emergency; Locate is independent and acknowledged by a consumed first touch, and touch alignment is stored in Director NVS with a factory fallback.
2026-09-21 docs: refresh Showduino README for current architecture, nodes and release gates
2026-09-22 Wire Audio Node command pending and timeout handling
2026-09-22 Preserve full Audio Node asset paths on Director wire
2026-09-22 Fix Audio Node inventory wire include order
2026-09-24 Fix Audio Node NO_STORAGE regression and emergency audio playback
    - AudioStorage.cpp: remount retry no longer gated on unreliable SD_DETECT
    pin; always retries SD.begin() on probe cadence so a genuinely present
    card is not permanently stranded in NO_STORAGE.
    - AudioCommand.cpp: add startEmergencyAsset() to actually resolve/validate
    and play show_machine/emergency.wav through the existing shared
    playback pipeline on EMERGENCY_STOP; add retrigger protection so
    repeated STOP packets do not restart the WAV; add symmetric stop/
    release logic on EMERGENCY_CLEAR; guard playback-complete/failed
    handlers so they no longer silently drop EMERGENCY state.
    - BoardConfig.h: remove duplicate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
    [AudioCommand.cpp, AudioStorage.cpp, BoardConfig.h]
2026-09-24 Fix Audio Node pixel output
    - AudioPixelEngine.cpp: emit unambiguous boot diagnostics (Engine: READY,
    GPIO, Count, Brightness, Emergency) on successful init, and specific
    [PIXEL][ERROR] reasons (count never configured, out of range, alloc
    failure) instead of a generic failure. Add an automatic, non-blocking
    boot self-test (RED/GREEN/BLUE/WHITE/OFF) that only runs once, only
    when a real pixel count is already configured, and never while
    Emergency is active — proves GPIO22/library/render independent of
    Director/WebUI command handling.
    - AudioPixelProtocol.cpp: log '[PIXEL] RX: <command>' for Director/P4
    (ESP-NOW show-origin) pixel commands so the command path is traceable
    w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
    [AudioPixelEngine.cpp, AudioPixelProtocol.cpp, AudioWeb.cpp]
2026-09-26 Route Studio pixel cues to Audio Node GPIO22
    Add AUDIO:NODE:PIXEL timeline routing on the P4, advertise Audio Node pixel outputs in device discovery, and sync the embedded Studio with website SHDO audio-node-pixels binding.
    [AudioCommand.cpp]
2026-09-26 Fix Lamp Node re-ignition after sustained blow-out
    Emit RELEASE after SUSTAINED, re-arm the blow detector by clearing aboveMs/classification and snapping filtered to live mic, and block IGNITE until the microphone returns quiet.
    [BoardConfig.h, LampProtocol.cpp, LampWeb.cpp]
2026-09-26 Replace Lamp Fermion audio with Adafruit Audio FX UART
    Drive the proven Audio FX board at 9600 on GPIO17/18 using board-reported FAT names, restart flameloo on done while BURN_LOOP is active, and keep semantic roles unchanged.
    [BoardConfig.h, LampAudio.cpp, LampAudio.h, LampWeb.cpp, NodeDiagnostics.cpp]
2026-09-26 Switch Emergency Node to momentary button and add OLED
    Replace the NC mushroom model with an INPUT_PULLUP pushbutton on GPIO4, auto-return to READY after observed P4 clear when released, and add the Pixel Node SSD1306 status display without affecting assert-only safety.
    [BoardConfig.h, EmergencyDisplay.cpp, EmergencyDisplay.h, EmergencyInput.cpp, EmergencyInput.h, EmergencyProtocol.cpp, EmergencyWeb.cpp, NodeDiagnostics.cpp]
2026-09-26 Sync commercial manuals with current Showduino architecture.
    Align customer/operator docs to latest main for Emergency+Pixel, Audio+Pixel, Lamp Audio FX, Director Lamp/Audio pages and Studio authoring boundaries without inventing hardware acceptance.
2026-09-26 Implement ESP32_MOS_X4 MOSFET Node firmware and protocol.
    Add host-testable MOSFET identity/engine, SHDO compile path, production-format MOSFET cues, and node firmware 0.1.0 with fail-safe ALL OFF.
    [BoardConfig.h, EspNowMosfetTransport.cpp, EspNowMosfetTransport.h, MosfetIdentity.cpp, MosfetIdentity.h, MosfetNodeState.cpp, MosfetNodeState.h, MosfetOutputEngine.cpp]
2026-09-26 Add MOSFET routing to Comms and P4 MosfetNodeLink.
    Multi-peer ROUTE:MOSFET delivery, emergency fanout, API exposure, and show-stop ALL OFF.
2026-09-26 Add Director MOSFET live control on Page 04.
    Convert the reserved MOSFET tile to live STATE:NODE:MOSFET wire with REFRESH and ALL OFF.
2026-09-26 Enable Studio Powered Output deployment and regenerate Comms WebUI.
    Sync MOSFET authoring into the Studio overlay and rebuild the embedded S3 asset bundle.
2026-09-26 Update Showduino docs for MOSFET Node 0.1.0.
    Mark software implemented with hardware pin validation still required.
2026-09-26 Add MOSFET Node GPIO25 identifier NeoPixels (0.1.1).
    Four local WS2812 indicators follow actual OUT1-4 levels; IDENTIFY chase does not alter outputs; not a theatrical Pixel Line.
2026-09-26 Add MOSFET identifier dual-duty status language (0.1.2).
    Green remains exclusive to energised outputs; OFF channels show dim purple/cyan/turquoise/violet status with priority-safe transient animations.
2026-09-26 Harden local SoftAP browser control over the S3 to P4 web tunnel.
    Add request IDs with bounded duplicate detection, accepted/rejected/duplicate lifecycle, atomic UART frames with timeout recovery, gitignored SoftAP secrets and optional control token, and drop wildcard CORS. Browser emergency clear is off by default. Document the local API and a public HTTPS proposal; Comms firmware 0.5.3.
2026-09-27 Fix C3 Emergency remote indication and link freshness
    [EspNowEmergencyTransport.cpp]
2026-10-02 Integrate generic P4 I/O into Stage Engine
2026-10-02 Document Stage Engine generic I/O commands
2026-10-02 Update Ethernet pin-conflict baseline
2026-10-16 docs: add source-grounded Showduino parts register and weekend first-show guide
    * docs: create traceable hardware, library, spare-parts and photographed-build inventory for weekend
    * docs: add weekend documentation and first-show verification guide
2026-10-20 Synchronize operator manuals with current firmware and Studio workflow
2026-11-01 docs: capture AWAITING STAGE and Cue Library navigation regressions
2026-11-01 docs: distinguish current February 2027 launch goal from historic Halloween gate
2026-11-02 docs: record 2 Nov flashed-baseline progress and staged integration gates
2026-11-11 docs: simplified C3 Lamp Node integration status and acceptance requirements
    No firmware for the simplified ESP32-C3 Lamp Node exists on main or on any
    branch. Records what was checked, how the described design differs from
    the historical C3 lamp and the active S3 lamp, what the P4 link and the
    SHDO compiler support today, and the hardware acceptance checks that have
    to pass before the node is described as supported.
    Claude-Session: https://claude.ai/code/session_01GVvnFABHySsGMB5nXWLHUf
